NeoLeMarc/Diplomarbeit/zigbit_firmware/Bootloader/readme.txt

Fuse bytes for atmega: (without OTAU)
EXTENDED                   0xFF
HIGH                       0x9C
LOW                        0x62
