NeoLeMarc/Diplomarbeit/vortrag_tng2/vortrag.tex

% $Header: /cvsroot/latex-beamer/latex-beamer/examples/beamerexample1.tex,v 1.47 2004/11/04 15:43:51 tantau Exp $

\documentclass{beamer}
%\documentclass{article}
%\usepackage[envcountsect]{beamerarticle}

% Do NOT take this file as a template for your own talks. Use a file
% in the directory solutions instead. They are much better suited.

% Try the class options [notes], [notes=only], [trans], [handout],
% [red], [compress], [draft] and see what happens!

% Copyright 2003 by Till Tantau <tantau@users.sourceforge.net>.
%
% This program can be redistributed and/or modified under the terms
% of the LaTeX Project Public License Distributed from CTAN
% archives in directory macros/latex/base/lppl.txt.

% For a green structure color use:
%\colorlet{structure}{green!50!black}

\usepackage{array,paralist}
\usepackage{tabularx}
\usepackage{eurosym}

\mode<article> % only for the article version
{
  \usepackage{fullpage}
  \usepackage{hyperref}
}

\mode<presentation>
{
  \setbeamertemplate{background canvas}[vertical shading][bottom=red!10,top=blue!10]

  \usetheme{CambridgeUS}
  \usefonttheme[onlysmall]{structurebold}
}

%\setbeamercolor{math text}{fg=green!50!black}
%\setbeamercolor{normal text in math text}{parent=math text}

\usepackage{amsmath,amssymb}
\usepackage[latin1]{inputenc}
\usepackage{colortbl}
\usepackage[english]{babel}

%\usepackage{lmodern}
%\usepackage[T1]{fontenc} 

\usepackage{times}
\setbeamercovered{dynamic}

%% Titel etc
\title[]{Kabellose Sensornetze: ZigBee, Bluetooth \& co.}
\author[Noe]{Marcel Noe}
\institute[TNG]{
        \inst{}TNG Technology Consulting GmbH}
\date[2013]

%% Hauptseite
\begin{document}
\frame{\titlepage}

\section<presentation>*{Einführung}

\begin{frame}
  \frametitle{Überblick}
  \tableofcontents[part=1,hidesubsections]
\end{frame}

\part<presentation>{Vortrag}

\logo{}
\section{Motivation}
\subsection{Was ist ein Sensornetz?}
\begin{frame}
    \frametitle{Was ist ein Sensornetz?}

    \begin{columns}[T]
        \begin{column}{7cm}
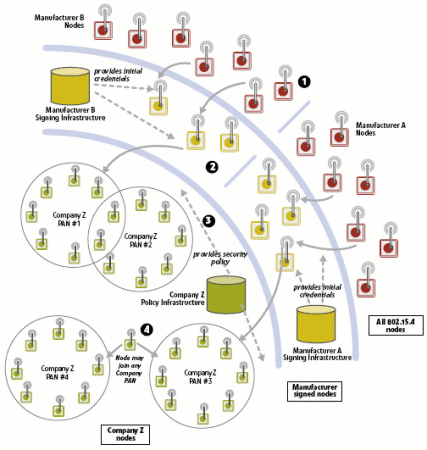
[picture p1: vortrag_tng2/images/certicom_sensor_nets_fig2.png]
            \\
        \end{column}

        \begin{column}{4cm}
            \begin{itemize}
                \item Netzwerk aus vielen verteilten Sensorknoten 
                \item Oft ad-hoc vernetzt 
                \item Energieversorgung meist über Batterie 
            \end{itemize}
        \end{column}
    \end{columns}
\end{frame}

\section{Anwendungen}
\subsection{Anwendungen}

\section{Grundlagen der kabellosen Datenübertragung}
\subsection{Die ISM Bänder}
\begin{frame}
    \frametitle{Die ISM Bänder}
      \begin{columns}[T]
        \begin{column}{3cm}
            \begin{itemize}
                \item 6,765 MHz
                \item 13,553 MHz
                \item 26,957 MHz 
                \item 40,66 MHz
                \item 433 MHz
                \item 902 MHz
                \item 2,4 GHz
                \item 5,7 GHz
                \item 24 GHz
                \item 61 GHz
                \item 122 GHz
                \item 244 GHz
            \end{itemize}
        \end{column}
        \begin{column}{5cm}
            \begin{itemize}
                \item In den meisten Ländern für jeden frei verwendbare Frequenzbänder
                \item Alle kabellosen Consumerprodukte verwenden eines der ISM-Bänder
                \item Verwendung anderer Frequenzen benötigt spezielle Lizenzen
            \end{itemize}
        \end{column}
    \end{columns}
\end{frame}

\subsection{Eigenschaften verschiedener Frequenzbänder}
\begin{frame}
    \frametitle{Eigenschaften verschiedener Frequenzbänder}

    Grundsätzlich: Je höher die Frequenz, desto höher die Datenübertragungsraten. Aber desto schlechter auch 
    Reichweite ein Eindringtiefe.
\end{frame}

\subsubsection{900 MHz}
\begin{frame}
    \frametitle{900 MHz}

    \begin{itemize}
           \item ca. 2,6 fache Reichweite wie 2,4GHz
           \item Bandbreite: 26 MHz (1/3 wie im 2,4GHz Band)
           \item Nur in Region 2 (Hauptsächlich Amerika. {\bf nicht} Europa)
    \end{itemize}
\end{frame}

\subsubsection{2.4 GHz}
\begin{frame}
    \frametitle{2.4 GHz Band}

    \begin{itemize}
           \item Reichweite ungerichtet bis ca. 100m 
           \item Maximal zulässige Sendeleistung: 100mW 
           \item Weltweit zulässig 
           \item Bandbreite: 100MHz
    \end{itemize}

\end{frame}

\subsubsection{5 GHz}
\begin{frame}
    \frametitle{5 GHz}

    \begin{itemize}
           \item Maximal zulässige Sendeleistung: 1W, daher theoretisch höhere Reichweite als 2,4GHz 
           \item Weltweit zulässig (Ausgenommen bestimmte Kanäle, z.B. in Japan)
           \item DFS und TPC zwingend vogeschrieben, um militärische Anwendungen nicht zu stören
           \item Bandbreite: 150MHz
           \item Weniger "Betrieb" als im 2,4GHz Band
    \end{itemize}
\end{frame}

\subsection{Frequenzspreizung}
\begin{frame}
    \frametitle{Frequenzspreizung: Motivation}

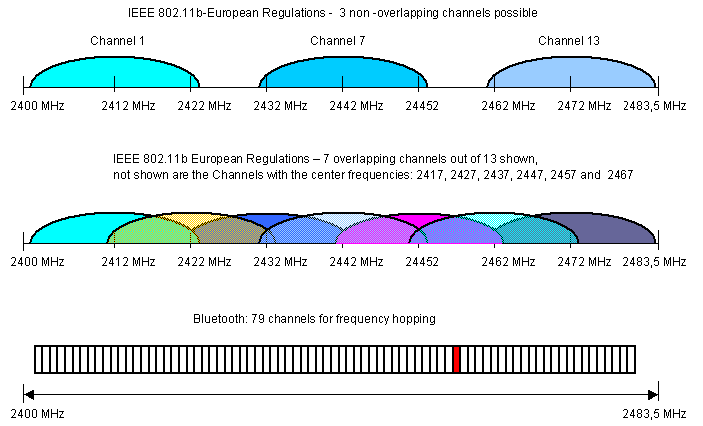
[picture p2: vortrag_tng2/images/ism_congest.png]
    \\
\end{frame}

\subsubsection{FHSS: Frequency Hopping Spread Spectrum}
\begin{frame}
    \frametitle{FHSS: Frequency Hopping Spread Spectrum}

    \\
\end{frame}

\subsubsection{DSSS: Direct Sequence Spread Spectrum}
\begin{frame}
    \frametitle{DSSS: Direct Sequence Spread Spectrum}

    \\
\end{frame}

\section{Verschiedene Technologien}
\subsection{WLAN}
\begin{frame}
    \frametitle{IEEE 802.11: WLAN}

    \begin{columns}[T]
        \begin{column}{3cm}
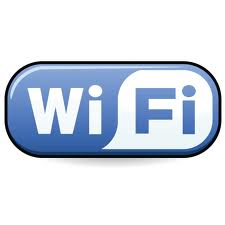
[picture p3: vortrag_tng2/images/wifi_logo.jpeg]
            \\
            \vspace{1cm}
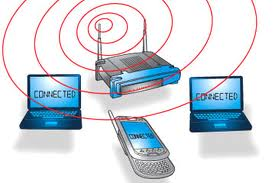
[picture p4: vortrag_tng2/images/wifi.jpeg]
            \\
        \end{column}

        \begin{column}{8cm}
            \begin{itemize}
                \item 2,4GHz und 5GHz 
                \item Übertragungsraten bis 150Mbit/sec
                \item Reichweiten ungerichtet bis ca. 100m, bei Sichtverbindung mit externer Antenne sogar bis 300m
                \item Richtfunk bis ca. 40km
                \item Je nach Standard: Verwendung von DSSS, FHSS und OFDM
                \item Relativ hoher Leistungsbedarf: 100mA zum Empfangen, 190mA zum Senden 
                \item Ad-Hoc Modus möglich
            \end{itemize}
        \end{column}
    \end{columns}
\end{frame}

\subsection{Bluetooth}
\begin{frame}
    \frametitle{Bluetooth}

    \begin{columns}[T]

        \begin{column}{3cm}
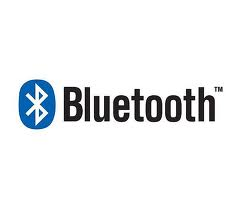
[picture p5: vortrag_tng2/images/bluetooth_logo.jpeg]
            \\
            \vspace{1cm}
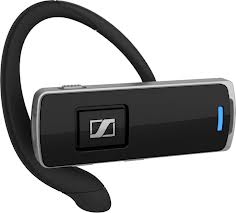
[picture p6: vortrag_tng2/images/headset.jpeg]
            \\
        \end{column}

        \begin{column}{8cm}
            \begin{itemize}
                \item 2,4GHz
                \item Übertragungsraten bis 2,1MBit/sec
                \item Reichweite bis 10m (Class 3), 50m (Class 2), 100m (Class 3) 
                \item FHSS
                \item Leistungsbedarf ca. 56,7mW (16,6mA) für ein Class 2 Slave
                \item Maximal 255 Teilnehmer
                \item Jedoch nur 7 gleichzeitig aktive Slaves
                \item 1 Master
                \item Teilnehmer müssen gepaired werden
            \end{itemize}
        \end{column}
    \end{columns}
\end{frame}

\subsection{ZigBee}
\begin{frame}
    \frametitle{ZigBee}

    \begin{columns}[T]

        \begin{column}{5cm}
            \\
        \end{column}

        \begin{column}{7cm}
            \begin{itemize}
                \item Protokollstack auf Basis von IEEE 802.15.4
                \item 868MHz (nur Europa), 900MHz (nur Amerika) und 2,4GHz (weltweit)
                \item 1mW Sendeleistung 
                \item Reichweite bis ca. 100 Meter 
                \item DSSS
                \item Übertragungsrate: 20kbit/sec (868MHz), 40kbit/sec (900MHz), 250kbit/sec (2,4GHz)
                \item 19mA im Betrieb, 6$µ$A im Sleep-Modus (Nur auf RFDs)
                \item FFDs (Full Functional Devices) und RFDs (Reduced Functional Devices)
                \item Mesh-Netzwerk bei Verwendung von FFDs als Router möglich.
            \end{itemize}
        \end{column}
    \end{columns}
\end{frame}

\section{Marktübersicht 2013}
\subsection{National Instruments}
\begin{frame}
    \frametitle{NI wireless sensor networks}

    \begin{columns}[T]

        \begin{column}{5cm}
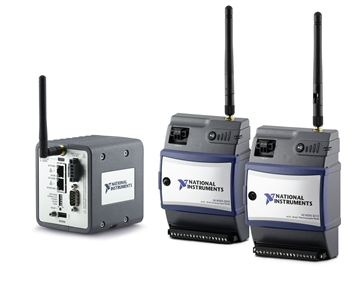
[picture p7: vortrag_tng2/images/national_instruments/RT_Gateway_and_Nodes_-_resized_JPEG.jpg]
            \\
        \end{column}

        \begin{column}{7cm}
            \begin{itemize}
                \item Programmierbare Ethernet und Wlan Gateways verfügbar 
                \item Knoten mit 4 digitalen und 4 analogen Eingängen
                \item Anbindung an LabVIEW
                \item Proprietäres Protokoll auf Basis von IEEE 802.15.4 
                \item Relativ teuer: ca. 500 Euro pro Sensorknoten
            \end{itemize}
        \end{column}
    \end{columns}
\end{frame}

\subsection{Libelium}
\begin{frame}
    \frametitle{Libelium}

    \begin{columns}[T]

        \begin{column}{5cm}
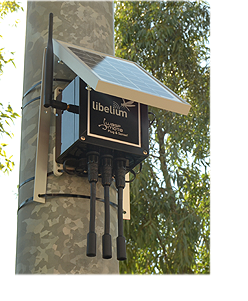
[picture p8: vortrag_tng2/images/libelium/installation.png]
            \\
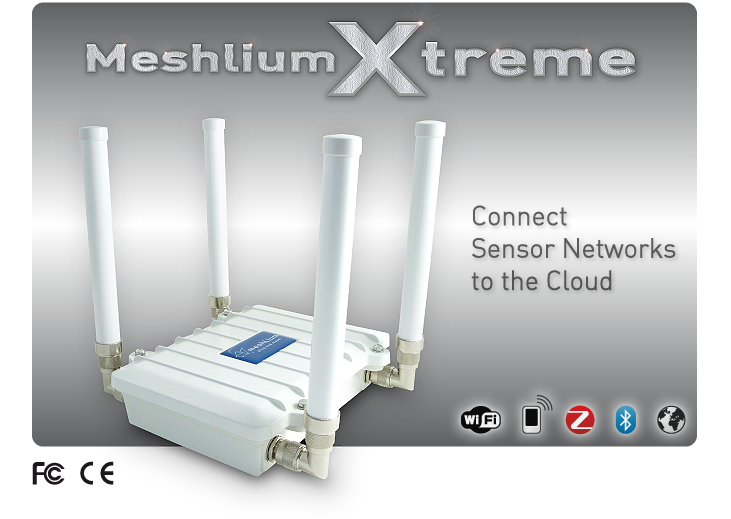
[picture p9: vortrag_tng2/images/libelium/title_frontpage_description_eng.png]
            \\
        \end{column}

        \begin{column}{7cm}
            \begin{itemize}
                \item Sensornetzprodukte auf ZigBee Basis 
                \item Sowohl als kostengünstige Entwicklerboards als auch als fertige Komplettlösung verfügbar 
                \item Unabhängige Energieversorgung über Solarzellen 
                \item Multiprotokoll-Gateways mit ZigBee, Wlan und Bluetooth
                \item Opensource Software 
                \item Lösungen für Smartcities
                \item Reichweite nach Herstellerangabe zwischen 7 und 14km
            \end{itemize}
        \end{column}
    \end{columns}
\end{frame}

\subsection{Zum selber basteln}

\begin{frame}
    \frametitle{Arduino}

    \begin{columns}[T]

        \begin{column}{5cm}
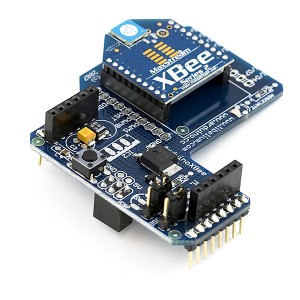
[picture p10: vortrag_tng2/images/arduino/arduino-xbee-shield-c-xbee.jpg]
            \\
        \end{column}

        \begin{column}{7cm}
            \begin{itemize}
                \item ZigBee Schild für Arduino
                \item Sockel für ein Digi International XBee Pro
                \item Preis für Modul und Schild zusammen unter 40 Euro
                \item XBee Module sind in verschiedenen Ausführungen erhältlich, die teilweise 
                      Pin-kompatibel sind
                \item Hergestellt von Libelium, Grundlage für die kommerziellen Waspmotes
            \end{itemize}
        \end{column}
    \end{columns}
\end{frame}

\begin{frame}
    \frametitle{Raspberry Pi}

    \begin{columns}[T]

        \begin{column}{5cm}
            \\
        \end{column}

        \begin{column}{7cm}
            \begin{itemize}
                \item Verwendung des Arduino ZigBee Schild mit Hilfe der Raspberry Pi to Arduino Shield.
                \item Preis für den Adapter: 40 Euro
            \end{itemize}
        \end{column}
    \end{columns}

\end{frame}

\begin{frame}
    \frametitle{ZigBit}

    \begin{columns}[T]

        \begin{column}{5cm}
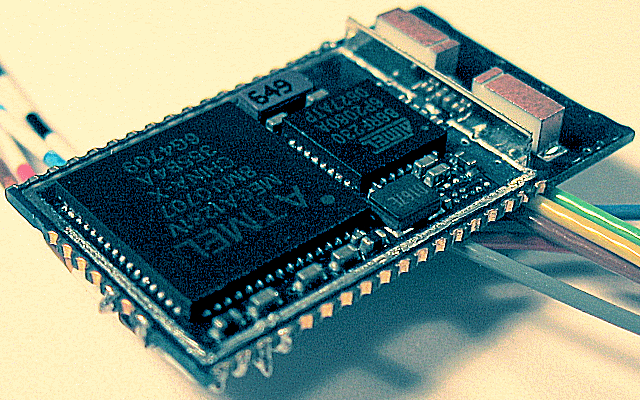
[picture p11: vortrag_tng2/images/ZDM-A1281-A2_offen.png]
            \\
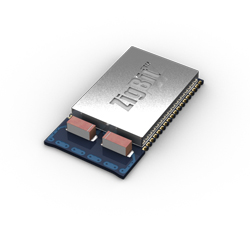
[picture p12: vortrag_tng2/images/zigbit_2.jpg]
            \\
        \end{column}

        \begin{column}{7cm}
            \begin{itemize}
                \item Kombination aus IEEE.802.15.4 Radios mit einem ATmega1281V Mikrocontroller
                \item 30 GPIO Leitungen
                \item UART, USART, I2C, SPI, 1-Wire, 4 ADCs, JTAG
                \item Stückpreis um die 14 Euro
                \item Mit etwas Geschick im Löten praktisch schon ein komplettes Starterkit.
            \end{itemize}
        \end{column}
    \end{columns}
\end{frame}

\section{Security}
\subsection{ZigBee: WEP Reloaded}
\begin{frame}
    \frametitle{ZigBee: WEP Reloaded}

    \begin{columns}[T]

        \begin{column}{5cm}
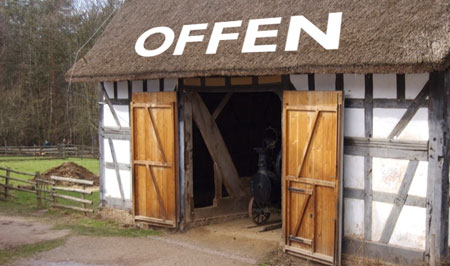
[picture p13: vortrag_tng2/images/scheunentor.jpg]
            \\
        \end{column}

        \begin{column}{7cm}
            \begin{itemize}
                \item Theoretisch 128-Bit-AES Verschlüsselung
                \item Aber oft managelhaftes Key-Management:
                \item Jedes Device in einem Netzwerk hat den selben PSK
                \item Keys können mittels JTAG extrahiert werden
                \item Oft schlecht gewählte Keys
                \item Kein Schutz gegen Replay Attacken
                \item Known-Plaintext Attacken möglich
                \item Besser: Security auf Application Layer. Aber: Auf einem 8-Bit Mikrocontroller...
            \end{itemize}
        \end{column}
    \end{columns}

\end{frame}

\subsection{Kisbee}
\begin{frame}
    \frametitle{Kisbee}

    \begin{columns}[T]

        \begin{column}{5cm}
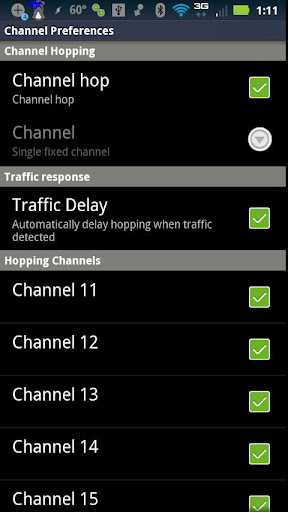
[picture p14: vortrag_tng2/images/netkismetwirelessandroidkisbee-1-1.jpg]
            \\
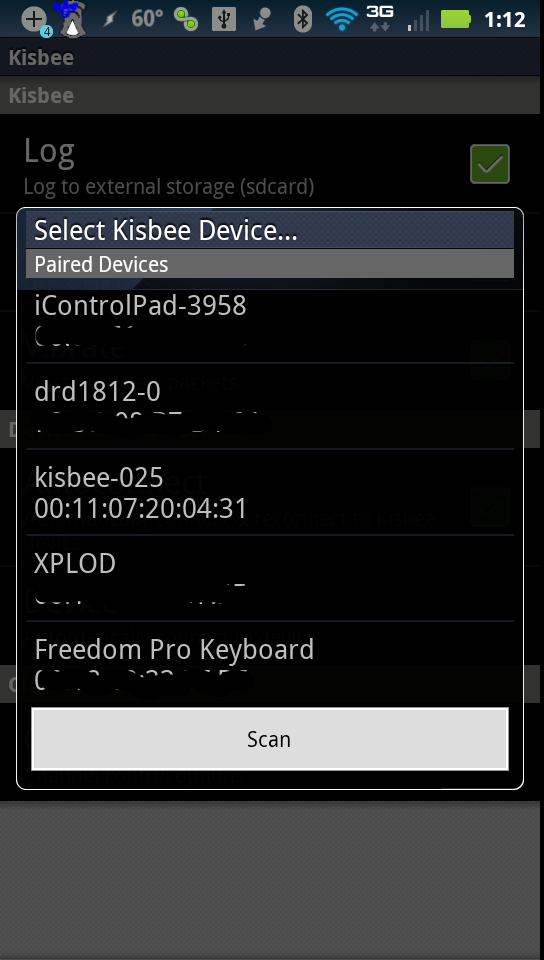
[picture p15: vortrag_tng2/images/kisbee-select.png]
            \\
        \end{column}

        \begin{column}{7cm}
            \begin{itemize}
                \item Projekt von den Kismet Autoren zum Angriff auf ZigBee Netze
                \item Läuft auf Android
                \item ZigBee Device kann per Bluetooth oder USB angebunden werden
            \end{itemize}
        \end{column}
    \end{columns}
\end{frame}

\subsection{Ich sehe was, was Du nicht siehst: Introducing HackRF}
\begin{frame}
    \frametitle{HackRF}

    \begin{columns}[T]

        \begin{column}{5cm}
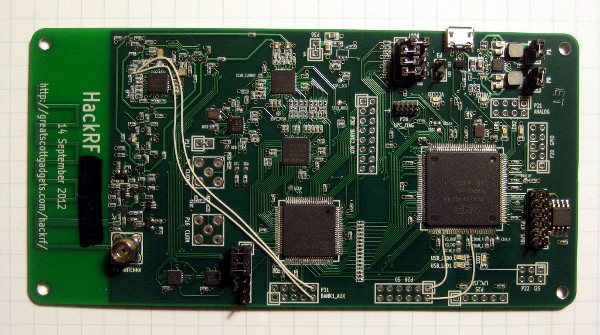
[picture p16: vortrag_tng2/images/HackRF.jpg]
            \\
        \end{column}

        \begin{column}{7cm}
            \begin{itemize}
                \item Idee: Low cost devices, das in der Lage ist, auf praktisch allen verwendeten Frequenzen zu 
                    Senden und zu Empfangen
                \item Damit werden auch Attacken auf Protokolle ausserhalb des ISM-Bandes möglich (z.B. GSM)
                \item Oder auf NFC, RFID...
                \item Integration in GNURadio
                \item Alle Bauteile sind auf kompatibilität mit OpenSourceSoftware sowie Robustheit ausgelegt
            \end{itemize}
        \end{column}
    \end{columns}

\end{frame}

\section{Aus der Alptraumabteilung}
\subsection{Smart dust}
\begin{frame}
    \frametitle{Smart dust}

    \begin{columns}[T]

        \begin{column}{10cm}
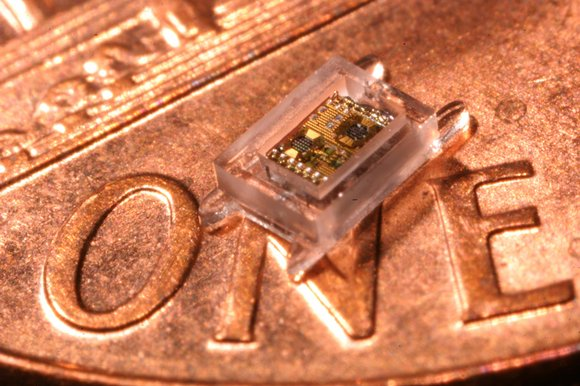
[picture p17: vortrag_tng2/images/smart_dust.jpg]
            \\
        \end{column}
    \end{columns}

\end{frame}

\subsection{Meine Kleidung funkt!}
\begin{frame}
    \frametitle{Meine Kleidung funkt!}

    \begin{columns}[T]

        \begin{column}{10cm}
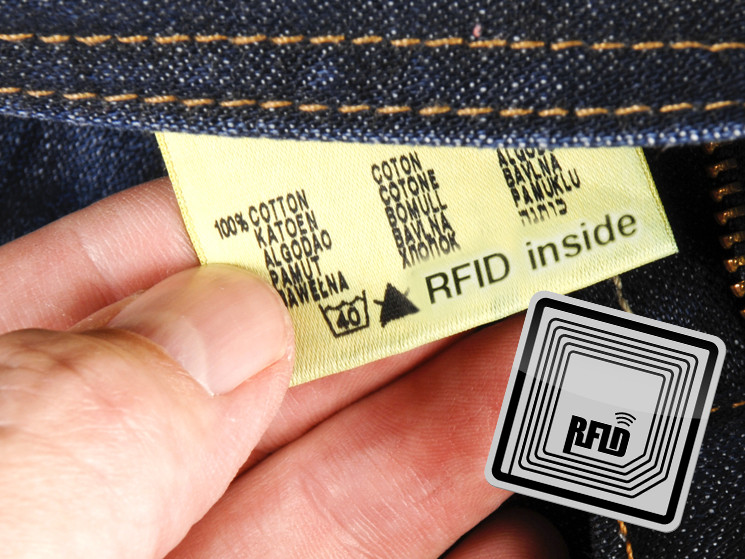
[picture p18: vortrag_tng2/images/rfid_kleidung.jpg]
            \\
        \end{column}
    \end{columns}

\end{frame}

\subsection{Tracking}
\begin{frame}
    \frametitle{Tracking}

    \begin{columns}[T]

        \begin{column}{10cm}
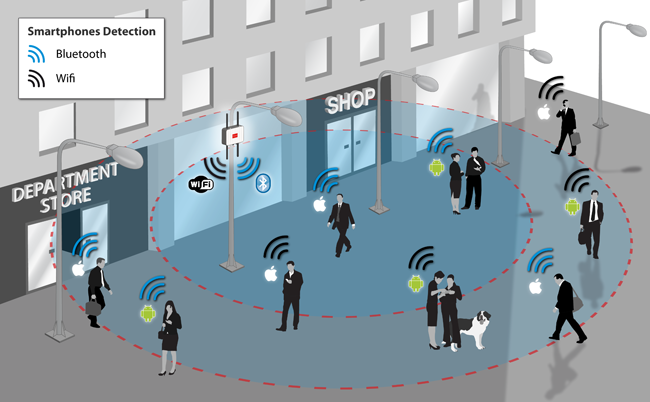
[picture p19: vortrag_tng2/images/libelium/bluetooth_street_wifi_bt_shops.png]
            \\
        \end{column}
    \end{columns}
\end{frame}

\section{Further reading}
\begin{frame}
    \frametitle{Further Reading}

    https://dev.noetech.net/svn/diplomarbeit/
    \\
    User: anonymous \\
    Passwort: anonymous
\end{frame}

\end{document}
