NeoLeMarc/Diplomarbeit/ausarbeitung/Diplomarbeit.tex

%-------------------------------%
%                               %
%    Hauptdokument              %
%    Diplomarbeit               %
%    Nicole Kikillus            %
%                               %
%    November 2003 - April 2004 %
%                               %
%-------------------------------%

\documentclass{wissdoc} %\textheight 23.0cm \textwidth 15.5cm
%\topmargin0cm \evensidemargin0cm \oddsidemargin0cm
\setlength{\parindent}{0pt}
\usepackage{a4,ngerman}
%\usepackage[a4paper, left=2.7cm, right=2.3cm, top=3.8cm, bottom=2.6cm]{geometry}
%\usepackage[a4paper, left=2.8cm, right=1.7cm, top=3.5cm, bottom=2.4cm]{geometry}
% ORG zum 11.08.05 \usepackage[a4paper, left=2.4cm, right=2.0cm, top=3.7cm, bottom=2.6cm]{geometry}
% ORG zum 18.07.05 \usepackage[a4paper, left=2.4cm, right=2cm, top=3.8cm, bottom=2.6cm]{geometry}
% ORG zum 06.07.05 \usepackage[a4paper, left=2.5cm, right=2.1cm, top=3.8cm, bottom=2.6cm]{geometry}
% ORG \usepackage[a4paper, left=3.6cm, right=3.2cm, top=3.8cm, bottom=2.6cm]{geometry}
%\usepackage[a4paper, left=2.5cm, right=2.5cm, top=1.2cm, bottom=2.3cm]{geometry}
\usepackage{graphicx}
\usepackage{epsfig}
\usepackage{float}
\usepackage[utf8]{inputenc}
\usepackage{url}
\usepackage{makeidx}
%\usepackage{natbib}
% \usepackage[dvips]{color}
\usepackage{color}
\usepackage{fancyhdr}
\usepackage{color}
\usepackage{pstricks}
\usepackage{rotating}
\usepackage[footnotesize,bf]{caption2}
\usepackage{eurosym}
\usepackage{pdfpages}
\usepackage{amsmath}
\usepackage{listings}
 \definecolor{middlegray}{rgb}{0.5,0.5,0.5}
 \definecolor{lightgray}{rgb}{0.8,0.8,0.8}
 \definecolor{orange}{rgb}{0.8,0.3,0.3}
 \definecolor{yac}{rgb}{0.6,0.6,0.1}
\lstset{numbers=left, numberstyle=\tiny, numbersep=5pt}
\lstset{language=python}
 \lstset{
   basicstyle=\small\ttfamily,
   keywordstyle=\bfseries\ttfamily\color{orange},
   stringstyle=\color{blue}\ttfamily,
   commentstyle=\color{middlegray}\ttfamily,
   emph={square}, 
   emphstyle=\color{blue}\texttt,
   emph={[2]root,base},
   emphstyle={[2]\color{yac}\texttt},
   showstringspaces=false,
   flexiblecolumns=false,
   tabsize=2,
   numbers=left,
   numberstyle=\tiny,
   numberblanklines=false,
   stepnumber=1,
   numbersep=10pt,
   xleftmargin=15pt
 }
\makeatletter \renewcommand{\fps@figure}{htbp} \makeatother
\renewcommand{\textfraction}{.1} 
\setlength{\parindent}{0em}
\renewcommand{\baselinestretch}{1.2}
%\KOMAoptions{twoside,BCOR=5mm,DIV=11}
\KOMAoptions{twoside,BCOR=5mm,DIV=12,footinclude=false,headinclude=true}

\recalctypearea

% Graphiken sollen nicht so oft auf Leeren Seiten stehen
\renewcommand{\topfraction}{0.9}
\renewcommand{\textfraction}{0.05}

% Macros, nicht unbedingt notwendig
\input{macros}

\newcommand{\blankpage}{% Leerseite ohne Seitennummer, nächste Seite rechts
 \clearpage{\pagestyle{empty}\cleardoublepage}
}

\pagestyle{headings}

%% *********************************
%% Formel- und Abkürzungsverzeichnis
%% *********************************

%% Achtung: an Kommandozeile folgender Befehl ausführen:
%%          makeindex -o diplom.gls -s nomencl.ist diplom.glo

\usepackage{nomencl}
\usepackage{ifthen}
\renewcommand{\nomname}{\chapter*{Glossar}}
\makeglossary
\makenomenclature
\setlength{\nomlabelwidth}{.25\hsize}
%\renewcommand{\nomlabel}[1]{\emph{#1}}
\setlength{\nomitemsep}{-\parsep}
%\makeglossary
%\makenomenclature

%% Quellcodeverzeichnis
\renewcommand\lstlistlistingname{Quellcodeverzeichnis}

%% Auskommentieren einer dieser Zeilen bewirkt, daß nur diese
%% eine Datei übersetzt wird

%\includeonly{Titel}
%\includeonly{Dank}
%\includeonly{Zitat}
%\includeonly{Kap_1}
%\includeonly{Kap_2}
%\includeonly{Kap_3}
%\includeonly{Kap_4}
%\includeonly{Kap_5}
%\includeonly{Kap_6}
%\includeonly{Anh_a}
%\includeonly{Anh_b}
%\includeonly{Anh_c}
%\includeonly{Anh_d}
%\includeonly{Anh_e}
%\includeonly{Anh_f}
%\includeonly{Anh_g}
%\includeonly{Tempverlauf}

%% **************
%% Dokumentbeginn
%% **************

%%% Überschrift 4ter Ordnung
\setcounter{secnumdepth}{4}

\usepackage[noindentafter]{titlesec}

% paragraphs sehen aus wie subsubsubsections
\titleformat{\paragraph}[hang]{\bf}{\thetitle\quad}{0pt}{}                      
\titlespacing{\paragraph}{0pt}{1em}{0.5em} 

% subparagraphs sehen aus wie vorher paragraphs
\titleformat{\subparagraph}[runin]{\bf}{}{0.5em}{}
\titlespacing{\subparagraph}{0pt}{1em}{1em}

%%%-----------------------------------
\begin{document} 
%%%-------------------------
\include{Titel}
%\include{Dank}

%\thispagestyle{empty}
\chapter*{} 
\pagenumbering{Roman}% Seitennummerierung durch arabische Ziffern
\vspace*{10.5cm} {\setlength{\parindent}{0pt}\textbf{Eidesstattliche Erklärung}\\
Hiermit erkläre ich an Eides Statt, dass ich die vorliegende Diplomarbeit selbständig und ohne unzulässige fremde Hilfsmittel angefertigt habe. Die verwendeten Literaturquellen sind im Literaturverzeichnis vollständig angegeben. Die Arbeit wurde in gleicher oder ähnlicher Form keiner anderen Prüfungsbehörde zur Erlangung eines akademischen Grades vorgelegt.\\ 

Karlsruhe, 31.10.2010\\

\include{Abstract}
\include{Vorwort}
%\include{Danksagung}

%%%------------------------------------------------INHALTS-,ABBILDUNGS-,TABELLENVERZEICHNIS-------------------------------------------
\setcounter{tocdepth}{4}
\tableofcontents 
\listoffigures
\addcontentsline{toc}{chapter}{Abbildungsverzeichnis}
\listoftables
\addcontentsline{toc}{chapter}{Tabellenverzeichnis}
\lstlistoflistings
\addcontentsline{toc}{chapter}{Quellcodeverzeichnis}

%%%------------------------------------------------GLOSSAR-----------------------------------------------------------------------------

%\chapter{Glossar}
\markboth{Glossar}{}
\printnomenclature
\addcontentsline{toc}{chapter}{Glossar}

\include{Einleitung}
\include{Grundlagen}
\include{Stand_der_Technik}
\include{Analyse}
\include{Entwurf}
\include{Praktische_Realisierung}
\include{Ergebnisse}
\include{Diskussion}
\include{Ausblick}

%%%------------------------------------------------ANHANG---------------------------------------------------------------

\begin{appendix}
\include{Anhang}
\end{appendix}

%%%------------------------------------------------KOMPLETTES LITERATURVERZEICHNIS NACH NORM------------------------------------------
\nocite{*} % Alle Einträge anzeigen
\bibliography{Diplomarbeit}
\bibliographystyle{itmalpha}
\addcontentsline{toc}{chapter}{Literaturverzeichnis}

\end{document}
