NeoLeMarc/Diplomarbeit/vortrag/vortrag.tex

% $Header: /cvsroot/latex-beamer/latex-beamer/examples/beamerexample1.tex,v 1.47 2004/11/04 15:43:51 tantau Exp $

\documentclass{beamer}
%\documentclass{article}
%\usepackage[envcountsect]{beamerarticle}

% Do NOT take this file as a template for your own talks. Use a file
% in the directory solutions instead. They are much better suited.

% Try the class options [notes], [notes=only], [trans], [handout],
% [red], [compress], [draft] and see what happens!

% Copyright 2003 by Till Tantau <tantau@users.sourceforge.net>.
%
% This program can be redistributed and/or modified under the terms
% of the LaTeX Project Public License Distributed from CTAN
% archives in directory macros/latex/base/lppl.txt.

% For a green structure color use:
%\colorlet{structure}{green!50!black}

\usepackage{array,paralist}
\usepackage{tabularx}
\usepackage{eurosym}

\mode<article> % only for the article version
{
  \usepackage{fullpage}
  \usepackage{hyperref}
}

\mode<presentation>
{
  \setbeamertemplate{background canvas}[vertical shading][bottom=red!10,top=blue!10]

  \usetheme{CambridgeUS}
  \usefonttheme[onlysmall]{structurebold}
}

%\setbeamercolor{math text}{fg=green!50!black}
%\setbeamercolor{normal text in math text}{parent=math text}

\usepackage{amsmath,amssymb}
\usepackage[latin1]{inputenc}
\usepackage{colortbl}
\usepackage[english]{babel}

%\usepackage{lmodern}
%\usepackage[T1]{fontenc} 

\usepackage{times}
\setbeamercovered{dynamic}

%% Titel etc
\title[MANV-Sensornetzwerk]{Entwurf und Implementierung
       eines kabellosen Sensornetzwerkes zur Überwachung von Patienten
       in einem MANV-Szenario}
\author[Noe, Tepelmann]{Marcel Noe \and Jan Tepelmann}
\logo{}
\institute[KIT]{
        \inst{} Institut für Biomedizinische Technik (IBT) \\
                Karlsruher Institut für Technologie } 
\date[2010]

%% Hauptseite
\begin{document}
\frame{\titlepage}

\section<presentation>*{Einleitung}

\begin{frame}
  \frametitle{Überblick}
  \tableofcontents[part=1,hidesubsections]
\end{frame}

\part<presentation>{Vortrag}

\logo{}
\section{Motivation}
\subsection{Massenanfall von Verletzten}
\begin{frame}
    \frametitle{Motivation: Massenanfall von Verletzten}

    \begin{columns}[T]
        \begin{column}{5cm}
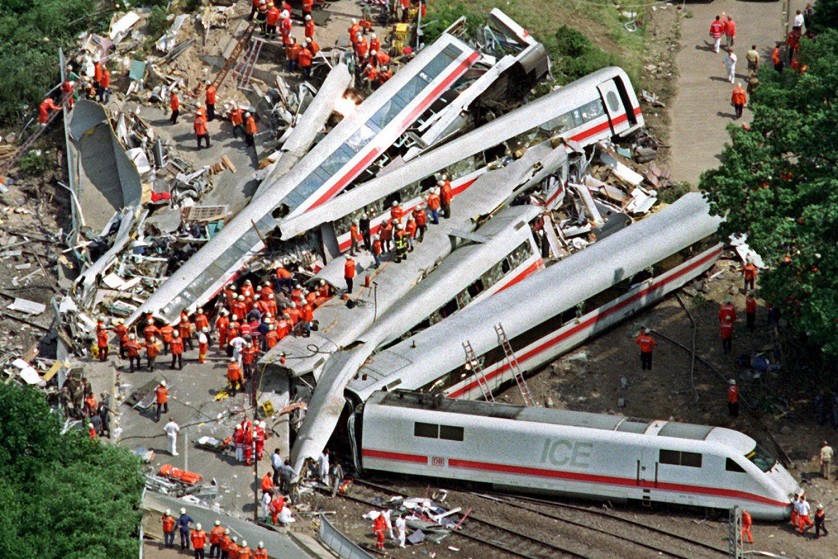
[picture p20: vortrag/eschede.jpg]
            
        \end{column}

        \begin{column}{7cm}
            \begin{itemize}
                \item Ereigniss mit einer großen Anzahl von Verletzten
                \item z.B. Verkehrsunglück, Brand, Naturkatastrophe oder Krankheit
                \item Teilweise Zusammenbruch (lokaler) Infrastruktur
                \item Knappe Ressourcen (Hilfsmittel, Helfer, Medikamente, Transportkapazität)
                \item Hohe Belastung für Helfer
                \item Unübersichtliche Lage (Beispiel: Teneriffa 1977)
            \end{itemize}
        \end{column}
    \end{columns}
\end{frame}

\subsection{Triage}
\begin{frame}
    \frametitle{Motivation: Triage}

    \begin{columns}[T]
         \begin{column}{8cm}
            \begin{itemize}
                \item Triage: Einteilung von Patienten in Gruppen nach Behandlungsdringlichkeit.
                \item Grund: Beschränkte Ressourcen: Transportmittel, Medikamente, Helfer
                \item Einfachste Hilfsmittel: "Sehen, hören, fühlen", Anhängekärtchen, etc.
                \item Aber: Werden alle Patienten korrekt zugeordnet? Was passiert bei Verschlechterung des
                      Zustands nach Triage? 
                \item Fehlerquellen: Zeitdruck, zu wenig Personal, Psychische Belastung der Helfer
            \end{itemize}
        \end{column}

       \begin{column}{3cm}
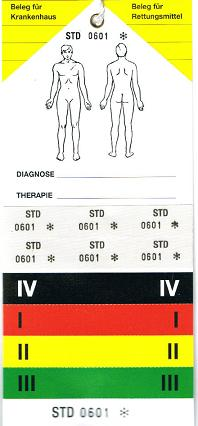
[picture p21: vortrag/Anhaengekarte2.JPG]
            
        \end{column}
    \end{columns}

    \vspace{0.3cm} \begin{center}{\bf $\Longrightarrow$ Technische Hilfsmittel können Fehler verringern.}\end{center}
\end{frame}
\logo{}

\section{Analyse}
\subsection{Stand der Technik}
\begin{frame}
    \frametitle{Stand der Technik: Hilfsmittel für MANV-Einsatz}

    \begin{itemize}
        \item Tragbare EKG-Geräte, insbesondere in Defis\\
              $\rightarrow$ Schwer, groß, teuer, pro Patient ein Gerät nötig
        \item Monitore mit Bluetooth-Technologie\\
              $\rightarrow{}$ Maximal 8 aktive Geräte pro Netzwerk
        \item Monitore mit WLAN-Technologie\\ 
              $\rightarrow{}$ störungsanfällig, hoher Stromverbrauch, teuer, kein Roaming.
        \item Herstellerspezifische Lösungen (z.B. Z-Wave oder Polar)\\
              $\rightarrow{}$ Proprietär, teuer
        \item ZigBee Healthcare, Bluetooth Low Energy (WiBree)\\
              $\rightarrow{}$ Bisher noch keine Geräte auf dem Markt
        \item $I^2C$ basiertes Sensornetz\\
              $\rightarrow{}$ Benötigt viele Kabel
    \end{itemize}
\end{frame}

\subsection{Anforderungen}
\begin{frame}
    \frametitle{Anforderungen}

    \begin{itemize}
        \item Skalierbar in Anzahl der Patienten {\bf und} Helfern
        \item Überwachung des Patientenzustands (z.B. Puls \& Atmung) durch Sensoren
        \item Senden von Befehlen (z.B. Alarm aus, manueller Alarm) an Sensoren
        \item Schnelle Einsatzfähigkeit: Je weniger Kabel desto besser.
        \item Kostengünstig
        \item Niedriger Stromverbrauch
        \item Robust 
        \item Einfache Bedienbarkeit
        \item Erweiterbar
    \end{itemize}
\end{frame}

\section{Lösung}

\subsection{Hardware: Funknetzwerk}
\begin{frame}
    \frametitle{Funknetzwerk: ZigBee}

    \begin{columns}[T]
        \begin{column}{5cm}
           % \includegraphics[width=5cm]{../ausarbeitung/diagramme/zigbit_bild-crop.pdf}
           
        \end{column}

        \begin{column}{7cm}
            \begin{itemize}
                \item Über 500 Teilnehmer möglich 
                \item Mesh-Netzwerk: Durch Router erweiterbar 
                \item Bis 50m (Klasse 2 Gerät) bzw. über 500m (Klasse 1 Gerät) Reichweite
                      {\bf pro Router!}
                \item Stromverbrauch: nur 1,8mA bei Einsatz von Energiesparmodus
                      (Bluetooth: 16,6mA, WLAN: 180mA).
                \item Stückpreis unter 15\EUR{}
            \end{itemize}
        \end{column}
    \end{columns}
\end{frame}

\subsection{Hardware: MANVNode}
% Logo ausschalten
\logo{}
\begin{frame}
    \frametitle{Hardware: MANVNode}

    \begin{columns}[T]
        \begin{column}{7cm}
            \begin{itemize}
                \item Entwicklungsplatine zum Entwerfen und Testen von Firmware
                \item JTAG-Schnittstelle für Debugging
                \item ADuC-Mikroprozessor (vgl. Erste-Hilfe-Sensor)
                \item Testpunkte für Strommessung 
                \item Programmierbare Taster und LEDs
                \item Piezzo-Summer
                \item Batterie- und Netzteilbetrieb (3V-16V)
            \end{itemize}
        \end{column}
   
        \begin{column}{5.5cm}
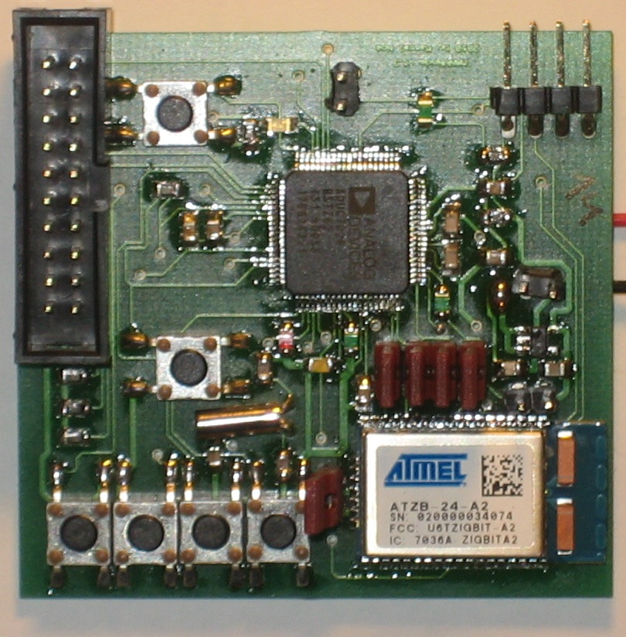
[picture p22: vortrag/platine.jpg]
            
        \end{column}
    \end{columns}
\end{frame}
% Logo wieder einschalten
\logo{}

% Logo ausschalten
\logo{}
\subsection{Software: Logische Sicht}
\begin{frame}
    \frametitle{Software: Logische Sicht}

    \begin{columns}[T]
    		\begin{column}{7cm}
            
        \end{column}
    
        \begin{column}{5.5cm}
            \begin{itemize}
            		\item Basisstation: kennt den Zustand des Sensornetzes
                \item An eine Basisstation können beliebig viele weitere Sichtstationen angeschlossen werden
                \item Sichtstation: zeigt Zustand der Patienten, kann Befehle an Sensoren senden
                \item Verbindung über WLAN, Ethernet oder UMTS
                %\item Handyzugriff über spezielle Software (Nokia) oder Weboberfläche (iPhone, Android)
            \end{itemize}
        \end{column}
    \end{columns}
\end{frame}

\subsection{Software: Technische Sicht}
\begin{frame}
    \frametitle{Software: Technische Sicht}

    \begin{columns}[T]
        \begin{column}{6cm}
            \begin{itemize}
                \item Kapselung von Zuständigkeiten in Komponenten
                \item Connector: Kommunikation mit Sensornetz
                \item Server: Speichern des Netzzustandes
                \item GUIs: Zustand des Netzes grafisch anzeigen
                \item Komponenten unabhängig voneinander austauschbar
                %\item Verbindung über standardisierte Schnittstellen (CORBA, SQL, Ethernet, WLAN)
            \end{itemize}
        \end{column}
        
        \begin{column}{7cm}
            
        \end{column}
    \end{columns}
\end{frame}

\subsection{Software: Zusammenfassung}
\begin{frame}
    \frametitle{Software: Zusammenfassung}

    \begin{block}{Schnittstellen zur Anbindung externer Software}
        \begin{itemize}
            \item CORBA (Industriestandard!)
            \item Datenbankzugriff: SQL-Schnittstelle
            \item Webservices: SOAP und JSON (Web 2.0!)
        \end{itemize}
    \end{block}

    \begin{block}{Skalierbarkeit}
        \begin{itemize}
            \item Anbindung beliebig vieler Sichtstationen 
            \item ZigBee unterstützt über 500 Teilnehmer.
            \item Lauffähig auf allen Standardbetriebssystemen durch Einsatz von Virtualisierung 
            \item Weboberfläche für alle gängigen Browser und Handytypen 
        \end{itemize}
    \end{block}
\end{frame}
% Logo wieder einschalten
\logo{}

\section{Ergebnisse}
\subsection{Praktische Vorführung}
\begin{frame}
    \frametitle{Praktische Vorführung}
    \begin{center}
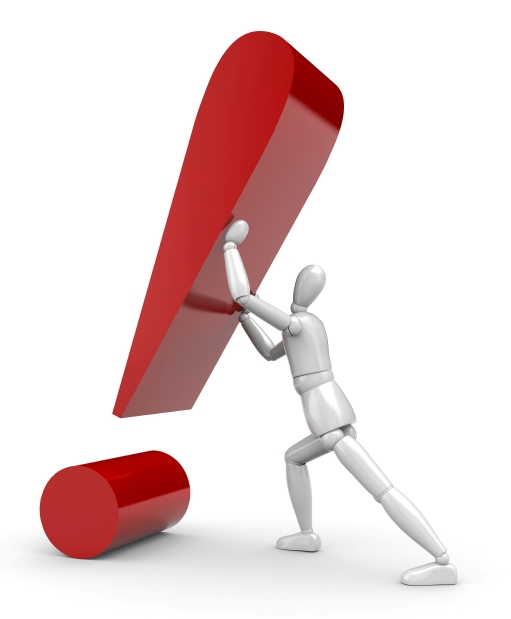
[picture p23: vortrag/Ausrufezeichen.jpg]
        
    \end{center}
\end{frame}

\subsection{Ergebnisse auf einen Blick}
\begin{frame}
    \frametitle{Ergebnisse auf einen Blick}
    \begin{itemize}
        \item 1,8mA Stromverbrauch bei Einsatz von Energiesparmodus
        \item Über 50m Reichweite pro Router
        \item Durch Router praktisch beliebig erweiterbar
        \item Laut Standard über 500 Teilnehmer möglich.
        \item Stabilität durch geringe Bandbreite und Frequenzspreizung 
        \item Software durch CORBA-Schnittstelle schnell an neue Anforderungen anpassbar.
        \item Größe wie Erste-Hilfe-Sensor. Demoplatine hat Format 50x56mm.
        \item Preis: Erste-Hilfe-Sensor + maximal 15\EUR{} für ZigBee-Modul 
    \end{itemize}
\end{frame}

\section{Diskussion und Ausblick}
\subsection{Diskussion}
\begin{frame}
    \frametitle{Verbesserungen gegenüber dem Stand der Technik}
    \begin{itemize}
        \item Keine Kabel mehr notwendig
        \item Kostengünstiger als alle existierenden Lösungen
        \item Stromsparender als alle existierenden Lösungen
        \item Mehr Teilnehmer als in allen existierenden Lösungen
        \item Hohe Reichweite durch Einsatz von Repeatern erreichbar
        \item Flexible und Erweiterbare Software 
        \item Herstellerunabhängig: Hardware-/Softwareschnittstelle austauschbar 
        \item Unabhängig von lokaler Infrastruktur
    \end{itemize}
\end{frame}

\subsection{Ausblick}
\begin{frame}
    \frametitle{Ausblick}

    \begin{block}{Optimierung der Hardware}
        \begin{itemize}
            \item Einsatz von Klasse 1 Modulen und Antennen ($\Rightarrow$ Reichweite)
            \item Tests von Modulen anderer Hersteller ($\Rightarrow$ Kosten)
        \end{itemize}
    \end{block}

    \begin{block}{Überarbeiten der ZigBit-Firmware}
        \begin{itemize}
            \item Verwendung von AES-Verschlüsselung
            \item Verringerung der Latenz
            \item Erhöhung der Datenübertragungsrate
        \end{itemize}
    \end{block}

    \begin{block}{Erweiterung der Software}
        \begin{itemize}
            \item Erweiterung der Weboberfläche
            \item Verbesserung der Benutzerführung
        \end{itemize}
    \end{block}
\end{frame}

\subsection{AAL}
\begin{frame}
    \frametitle{AAL-Kongress: Posterbeitrag}

    \begin{columns}[T]
        \begin{column}{4cm}
            
        \end{column}

        \begin{column}{8cm}
            \begin{itemize}
                \item Sensornetzwerk kann auch zur Unterstützung von älteren
                      Patienten im Alltag eingesetzt werden
                \item Veröffentlichung im Themengebiet "Wegweisende Anwendungsbeispiele"
                \item 25. - 26. Januar 2011 in Berlin
            \end{itemize}
        \end{column}
    \end{columns}
\end{frame}

\subsection{Fragen}
\begin{frame}
    \frametitle{Fragen?}

    \begin{center}
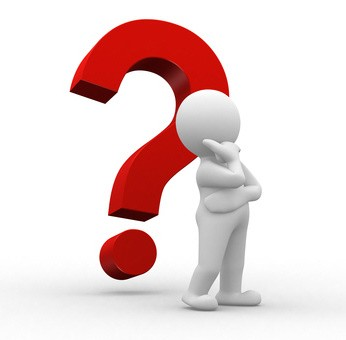
[picture p24: vortrag/fragezeichen.jpg]
        
    \end{center}
\end{frame}

\end{document}
