NeoLeMarc/Diplomarbeit/ausarbeitung/preview/preview.tex

    % Mit pdflatex (PDF-Ausgabe) bearbeiten
    \documentclass[a4paper]{article}
    \usepackage{pdfpages}
    \begin{document}
    \includepdf[pages={{},-},
                nup=1x2,
                landscape=true,
                frame=true,
                noautoscale=true,
                scale=0.65,
                delta=0mm 5mm]{Diplomarbeit.pdf}
    \end{document}
