NeoLeMarc/Diplomarbeit/konzept/projektbeschreibung.odt

# Entwicklung eines Sensornetzes zur Überwachung von Patienten bei einem Massenanfall von Verletzten (MANV)

# Einleitung

Unter dem Begriff „Massenanfall von Verletzten“ (MANV) versteht man ein Ereignis, bei dem innerhalb kurzer Zeit eine große Anzahl von Verletzten versorgt werden muss. Hierbei mögen einem zuerst Vorfälle wie die Terroranschläge am 11. September 2001, die Reaktorkatastrophe von Tschernobyl oder spektakuläre Naturereignisse wie der Hurrikan Katrina, die Flutkatastrophen der letzten Jahre oder die Erdbeben in Haiti in den Sinn kommen.

Doch bereits Ereignisse geringeren Ausmaßes - wie z.B. ein Auffahrunfall auf der Autobahn, ein Zugunglück, eine Massenpanik bei einem Konzert oder starke Schneefälle, wie sie in den letzten Monaten aufgetreten sind - können den Rettungsdienst einer Region sehr schnell an die Grenzen seiner Leistungsfähigkeit bringen.

Beispielhaft seien hier folgende Ereignisse der letzten Jahre und Jahrzehnte genannt:

1980 – Oktoberfestattentat: 13 Tote, 211 Schwerverletzte

1988 – Flugtagunglück von Ramstein: 70 Tote, 1000 Verletzte

1998 – ICE-Katastrophe von Eschede: 101 Tote, 88 Schwerverletzte

2000 – Zugunglück von Brühl: 9 Tote, 149 Verletzte

Dazu kommen jedes Jahr ca. 400.000 Verletzte im Straßenverkehr.

# Motivation

Im Falle eines Massenanfalls von Verletzten treffen vor Ort viele unterschiedliche Einheiten von Rettungskräften aufeinander. Um die Zusammenarbeit dieser Kräfte überhaupt zu ermöglichen und ein geordnetes Vorgehen zu unterstützen gibt es klar definierte Abläufe und Verantwortlichkeiten. Zunächst versuchen die Rettungskräfte die Patienten außerhalb des unmittelbaren Gefahrenbereichs abzulegen. An dieser Ablagestelle werden die Patienten vom Rettungsdienst übernommen, welcher auch bereits Lebensrettende Sofortmaßnahmen einleitet und eine Erstversorgung durchführt. Wenn möglich erfolgt bereits hier eine erste Registrierung der Patienten (Fundort, Name usw.).

Nun werden die Patienten einer Triage, also der Einordnung in verschiedene Schweregrade, unterzogen, um zu entscheiden, in welcher Reihenfolge diese Patienten versorgt werden.

Diese Einordnung ist notwendig, da meist nicht genügend Ressourcen (sowohl Material als auch Personal) vorhanden sind, um sofort alle Patienten zu versorgen. Daher gilt das Ziel, dass möglichst viele Patienten den Vorfall mit einem möglichst geringen Schaden überstehen. Um eine Zuteilung der vorhandenen Ressourcen gemäß dieses Ziels zu gewährleisten, erfolgt eine Einordnung der Patienten in folgende 4 Kategorien:

- T1: akute, vitale Bedrohung => sofortige Behandlung
- T2: nicht lebensbedrohlich verletzt => aufgeschobene Behandlung
- T3: leicht verletzt => spätere Behandlung
- T4: Tot oder ohne Überlebenschance[^1] => keine Behandlung

Für die Entscheidung, in welche Kategorie ein einzelner Patient einzuordnen ist, stehen meist weniger als 60 Sekunden zur Verfügung

Obwohl diese Vorgehensweise eine schnelle Versorgung von Schwerverletzten gewährleistet, stellen sich eine Reihe von Problemen:

1. Patienten können in die falsche Gruppe zugeordnet werden.
2. Möglicherweise verschlechtert sich der Zustand eines Patienten nach seiner Einteilung in die Gruppe T2 rapide, so dass dieser sofortiger Versorgung bedarf.
3. Es besteht ein Konflikt zwischen sorgfältiger Untersuchung und zu wenig zur Verfügung stehender Zeit.

Hierbei ist zu bemerken, dass die Sichtung immer noch ohne besondere technische Hilfsmittel stattfindet. Die Patienten werden mit Hilfe von einfachen Papierkarten markiert, die Überprüfung von Atmung, Puls und Blutdruck erfolgt durch einfache physische Methoden wie Anfassen, Hören und Beobachten.

Insbesondere der zweite Punkt obiger Aufzählung könnte mit technischen Mitteln entschieden verbessert werden. Da eine dauerhafte Überwachung nur deswegen nicht erfolgt, weil nicht genügend Personal zur Verfügung steht, könnten diese durch ein automatisches System ersetzt werden, welches die Patienten überwacht, und im Falle einer Zustandsänderung eine Alarmierung durchführt.

Zwar gibt es automatische Überwachungssysteme (sogenannte Monitore), die in Krankenhäusern oder Rettungsfahrzeugen zur Patientenüberwachung eingesetzt werden, allerdings sind diese Systeme für den Einsatz in einem MANV-Szenario ungeeignet, da sie zu groß, zu teuer und zu kompliziert sind.

# Existierende Lösungen

Bestehende Monitoring-Lösungen für den Feldeinsatz setzten zur Zeit entweder auf die Ableitung des elektrischen EKG-Signals oder auf die Pulsoximetrie (Überwachung der Sauerstoffsättigung im Blut durch Durchleuchtung der Haut).

Bei dem EKG-Verfahren werden über mehrere Elektroden die elektrische Aktivität der Herzmuskelfasern abgeleitet. Entsprechende Geräte sind jedoch relativ aufwendig und störanfällig (das abgeleitete Signal befindet sich im Millivolt Bereich), d.h. Für den Einsatz in einem MANV-Szenario zu teuer. Außerdem ist selbst bei bestehendem EKG-Signal nicht gewährleistet, dass auch tatsächlich eine mechanische Aktivität des Herzens stattfindet (Stichwort: Pulslose Elektrische Aktivität).

Bei der Pulsoximetrie wird hingegen eine Reihe von LEDs eingesetzt, um die Haut zu durchleuchten. Über die Absorption innerhalb eines bestimmten Wellenlängenbereiches kann hierdurch die Sauerstoffsättigung des Bluts bestimmt werden. Außerdem können Pulsschläge detektiert werden. Die Pulsoximetrie reagiert jedoch nur sehr träge auf einen Atemstillstand (Detektionszeit mehrere Minuten!) und arbeitet darüber hinaus bei Patienten im Schockzustand nicht mehr zuverlässig.

Ein neuer Ansatz stellt der von Dr. Marc Jäger entwickelte Erste-Hilfe-Sensor dar. Dieser Sensor wird am Hals des Patienten angebracht und misst kapazitiv Atmung und Puls. Dieses Verfahren hat den Vorteil, dass es zum einen innerhalb kürzester Zeit eine Aussage über den Zustand des Patienten machen kann, und zum anderen sehr kostengünstig zu realisieren ist (Angestrebt ist ein Stückpreis im einstelligen Euro-Bereich).

# Ziele

In dem vorgestellten Projekt soll der oben genannte Erste-Hilfe-Sensor zu einer Monitoringlösung für den Einsatz bei einem MANV weiterentwickelt werden. Mit Hilfe eines Sensornetzes sollen die Sensoren in die Lage versetzt werden, den Zustand des Patienten an eine zentrale Überwachungsstelle zu kommunizieren und so eine fortwährende Überwachung zu gewährleisten. Die Überwachungsstelle soll über eine Benutzeroberfläche verfügen, über die der Zustand er einzelnen Sensoren abgebildet wird. Außerdem sollen Befehle an die Sensoren geschickt werden können.

Im Hintergrund soll eine Aufzeichnung der Vitaldaten der Patienten in eine Datenbank erfolgen, so dass diese später ausgewertet werden können. Im Falle des Eintritts eines kritischen Zustandes soll eine Alarmierung sowohl am Sensor als auch an der Bedienoberfläche erfolgen. Behandelndes medizinisches Personal soll mit Hilfe von Handheld Geräten (Mobiltelefon, PDA etc.) direkt am Patienten Funktionen der Benutzeroberfläche aufrufen können.

# Anforderungen

An die zu entwickelnde Lösung werden folgende Anforderungen gestellt:

Power Management

Die Energieversorgung erfolgt kabellos über Batterien. Hierbei ist auf einen möglich geringen Energiebedarf zu achten, um mit einer möglichst kleinen Stromquelle eine möglichst lange Laufzeit zu gewährleisten (Idealfall: Mehrere Tage Laufzeit mit einer einzelnen Knopfzelle).

Störsicherheit
Das Netzwerk soll selbst bei massiven Störungen (z.B. WLAN, Mobilfunkstrahlung, Bahnstrom) noch zuverlässig funktionieren.

Zuverlässigkeit
Das Gesamtsystem soll Robust gegenüber Störungen und Teilausfällen sein. Das Netzwerk soll sich bei einem Ausfall von Teilkomponenten neu organisieren („Selbstheilung“). Die einzelnen Sensoren sollen auch bei Verlust der Netzwerkverbindung noch eine sinnvolle Funktion erfüllen (z.B. Audiovisuelle Alarmierung mit Hilfe von Summern und LEDs). Sobald das Netzwerk wieder verfügbar ist, sollen die Sensoren selbstständig die Verbindung wieder Aufnehmen. Der Verlust von Sensoren darf nicht unerkannt bleiben (→ Regelmäßige Statusanfrage, „An-Pingen“).

Kabellos
Die Vernetzung der Sensoren soll kabellos erfolgen.

Reichweite
Die Reichweite des Netzwerkes soll für den Einsatz in einem MANV-Szenario ausreichend sein.

Skalierbarkeit
Das Netzwerk soll einfach sowohl um weitere Knoten als auch auf eine größere Fläche erweitert werden können.

Platformunabhängigkeit
Benutzeroberfläche und Server-Komponente sollten sowohl auf dem Betriebssystem Linux als auch unter gängigen Windows-Betriebssystemen lauffähig sein.
Die mobile Oberfläche sollte auf gängigen Mobiltelefonen und PDAs lauffähig sein.

Kostengünstig
Der Preis für einen einzelnen Sensor sollte möglichst gering sein. Angestrebt ist ein Stückpreis unter 20 Euro.

Mindestens MANV-Stufe 2, besser 3
Das Gesamtsystem sollte für die Versorgung von 1000 – mindestens aber 500 Patienten ausreichend Leistungsfähig und skalierbar sein.

# Überblick über das Gesamtsystem

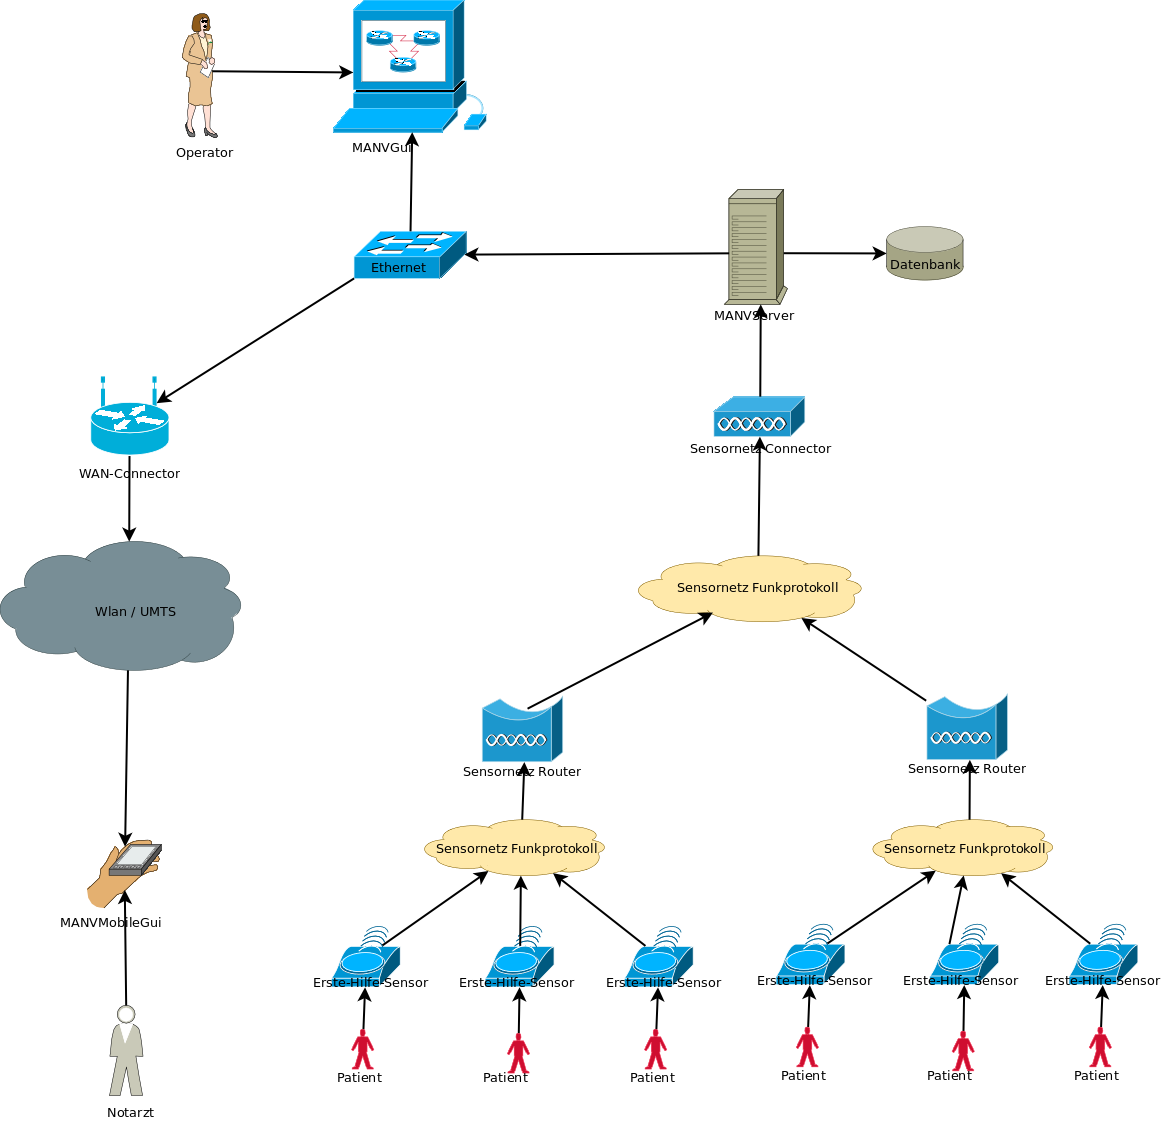
[picture p25: figure]

Bei der Entwicklung des Systems wird ein komponentenbasierter Ansatz gewählt. Hierfür werden Server, GUI und der Treiber für das Sensornetzwerk in einzelne Komponenten gekapselt, die über CORBA miteinander verbunden werden. Die Schnittstellen der einzelnen Komponenten sind klar definiert. Hierdurch wird es sehr einfach, die Hardwareumgebung zu skalieren: In der kleinsten Version können alle Aufgabe von einem Netbook oder Laptop übernommen werden. Wird mehr Leistung benötigt, können die Aufgaben auf verschiedene Serversyteme verteilt werden. Eine Replikation einzelner Komponenten ist möglich, wodurch die Zuverlässigkeit erhöht und die Leistung gesteigert wird.

Das Sensornetzwerk selbst basiert in der ersten Version auf dem ZigBee Standard. Dieser erlaubt es, selbstorganisierte, autonome multi-hop Verbindungen aufzubauen. Das Netzwerk kann mit Hilfe von Routern sowohl vertikal (räumliche Ausbreitung) als auch horizontal (Anzahl der Knoten) skaliert werden. Sollten einzelne Router ausfallen, führt das Netzwerk automatisch eine Reorganisation durch, und ein Ausweichpfad über einen anderen Router wird gewählt.

# Komponenten

  MANVGui
  Die MANVGui ist die graphische Benutzeroberfläche, mit deren Hilfe die Operatoren mit dem Sensornetz kommunizieren. Sie erlaubt die Verwaltung der Knoten, die Zuordnung zu Patienten, die Überwachung der Patienten (Audiovisuelle Signalisierung von Alarmen, Puls- und Atmungsüberwachung mit Verlaufsanzeige), sowie die Konfiguration der einzelnen Knoten. Es können beliebig viele GUIs im Netzwerk vorhanden sein. Zum Betrieb des eigentlichen Netzwerks ist keine GUI erforderlich.
  MANVMobileGui
  Die MANVMobileGui ist eine Version der MANVGui, die speziell für den Einsatz auf Handheld-Geräten optimiert ist. Die Verbindung mit dem MANVServer erfolgt über ein kabelloses Protokoll wie UMTS oder WLAN (je nach Fähigkeit des Handheld-Gerätes). Die MobileGUI wird vom Notarzt direkt am Patienten eingesetzt, und ermöglicht es, schnell die Vitalparameter dieses abzufragen. Außerdem verfügt sie über eine Pager-Funktion, mit der Arzt im Falle eines Alarms benachrichtigt werden kann.
  MANVServer
  Der MANVServer koordiniert die Kommunikation zwischen den einzelnen Komponenten. Er interagiert mit dem Sensornetzwerk über den MANVConnector, leitet von der GUI gesendete Befehle an diesen weiter. Ereignisse wie Alarme, oder Messwerte für Puls und Atmung werden vom MANVConnector an den Server ausgeliefert. Der Server leitet diese dann an alle registrierten GUIs und MobileGUIs weiter. Außerdem werden alle Ereignisse zur späteren Analyse in einer Datenbank gespeichert.
  MANVConnector
  Der MANVConnector kapselt das Funkprotokoll des Sensornetzwerks. Hierdurch wird das Protokoll sehr einfach austauschbar. Es ist möglich, dass das momentan eingesetzt ZigBee Protokoll in Zukunft gegen ein anderes Protokoll ausgetauscht wird (denkbar wäre hier der Bluetooth 3.0 Standard, der ähnliche Eigenschaften wie ZigBee hat). Außerdem kann für spezielle Anwendungen auf ein kabelgebundenes Protokoll wie CAN oder RS485 ausgewichen werden (Dies könnte notwendig sein, wenn das System in einem Krankenhaus oder Flugzeug eingesetzt werden soll).
  MANVCoordinator
  Der MANVCoordinator koordiniert die Kommunikation der Knoten im Sensornetzwerk. Außerdem bildet er die Schnittstelle zwischen MANVConnector und Sensornetzwerk. Geplant ist die Realisierung als USB-Stick.
  Erste-Hilfe-Sensor
  Der Erste-Hilfe-Sensor ist die Hardwarekomponente, die den Patienten überwacht. Er kommuniziert über I²C oder UART mit einem Modul, das die Verbindung mit dem Sensornetzwerk herstellt.
  MANVFirmware
  Die MANVFirmware ist ein Binary, das auf dem Erste-Hilfe-Sensor ausgeführt wird. Sie ist für die Überwachung des Patienten sowie der Kommunikation mit dem Sensornetzwerk zuständig. Die Implementierung erfolgt in Form eines in C geschriebenen Binaries.

# Eingesetzte Technologien

  Java
  Die GUIs, der Connector sowie der Server sind in Java geschrieben. Dies gewährleistet die notwendige Platformunabhängigkeit.
  Swing
  Für die Realisierung der GUI wird Java Swing verwendet.
  CORBA
  Die Kommunikation der Softwarekomponenten erfolgt mittels CORBA.
  PostgreSQL
  Für die Speicherung von Ereignissen wird eine PostgreSQL-Datenbank eingesetzt. Prinzipiell kann jede Datenbank verwendet werden, für die ein JDBC-Treiber existiert.
  Linux/Windows
  Server und GUI können sowohl unter Windows als auch unter Linux eingesetzt werden. Prinzipiell ist der Einsatz auf jedem Betriebssystem denkbar, das über eine Java-Virtual-Machine verfügt.
  Eclipse
  Für die Entwicklung der Java Komponenten wird Eclipse als integrierte Entwicklungsumgebung verwendet.
  CrossWorks
  Die Firmware des Erste-Hilfe-Sensors wird die Software CrossWorks von Rowley Associates verwendet.
  Mentor CHS
  Alle notwendige Platinen werden mit dem EDA-Tool Mentor CHS entworfen. Die prototypische Entwicklung erfolgt im Ätzbad.
  Aduc702X-Mikrocontroller
  Die Hardware des Erste-Hilfe-Sensors ist auf Grundlage des ARM7TDMI basierten Analog Devices Aduc702x Mikrocontrollers realisiert.
  Atmel-ZigBit
  Für die Kommunikation zwischen Mikrocontroller und Sensornetzwerks wird ein OEM-Modul von Atmel (ZigBit) eingesetzt. Hierbei handelt es sich um eine fertiges Modul, das im wesentlichen aus einem Transmitter, einem Mikrocontroller sowie einem ZigBee-Protokollstack besteht.

# Machbarkeitsnachweis

Vor Beginn der Arbeit wurde bereits ein Proof of Concept durchgeführt, um die Realisierbarkeit des Projektes zu zeigen. Hierzu wurden einige Prototyp Platinen gefertigt, die es ermöglichen, die 2 Atmel ZigBit-Module auf jeweils ein Steckbrett aufzustecken. Auf dem Steckbrett wurde mit einem MAX3232 Baustein eine Verbindung zwischen Funkmodul und PC hergestellt. Danach wurde ein Python-Skript verwendet, um die Module anzusteuern, und Testnachrichten zu verschicken. Hierdurch konnte gezeigt werden, dass es möglich ist, die ZigBit Module anzusteuern, und Nachrichten zu verschicken.

In einem weiteren Test wurden Prototypen der zu realisierenden Java-Komponenten entwickelt, und über CORBA verbunden. Ein Simulator sendete einige zufällige Ereignisse über CORBA an den Prototyp des Servers. Dieser sendete diese an den Prototyp der GUI weiter, welche diese wiederum als Textnachricht in einem Fenster auf dem Bildschirm de Benutzer darstellte. Die einzelnen Komponenten liefen hierbei jeweils auf zwei verschiedenen Rechnern, die über WLAN miteinander verbunden waren. Mit diesem Test konnte gezeigt werden, dass die Verbindung über CORBA funktioniert, und ein Austausch von Nachrichten über ein TCP/IP-Netzwerk möglich ist.

Zuletzt wurde noch die Verbindung zwischen Mikrocontroller und ZigBit Modul getestet. Hierzu wurden Mikrocontroller und ZigBit Modul über eine Kabelbrücke auf dem Steckbrett miteinander verbunden. Auf dem Mikrocontroller wurde nun ein Programm gestartet, dass im 10-Sekunden-Intervall die Nachricht „TEST“ verwendet. Mit einem Terminalprogramm wurde vom PC aus eine Verbindung mit dem zweiten ZigBit Modul aufgebaut, und die Testnachricht konnte erfolgreich empfangen werden. Mit diesem Test wurde gezeigt, dass die Kommunikation zwischen Mikrocontroller und ZigBit Modul funktioniert, und es möglich ist, vom Mikrocontroller aus Nachrichten zu versenden.

# Aufteilung zwischen Diplomarbeit und Studienarbeit

Da das Projekt sehr umfangreich ist, wurde es auf in zwei Teile zerlegt. Der Entwurf des Gesamtsystems, die Realisierung des Sensornetzwerks, die Rechnerschnittstelle sowie alle Hardwarekomponenten werden in Form einer Diplomarbeit realisiert. Inhalt der Arbeit ist der Entwurf und die Implementierung eines komplexen Systems, das sowohl aus Software- als auch Hardware besteht.

Graphische Benutzeroberfläche und Server wurden als Einheit zusammengefasst und sollen in Form einer Studienarbeit realisiert werden. Ziel der Arbeit ist der Entwurf und Implementierung einer verteilten Anwendung. Die Vorgehensweise entspricht dem Design-By-Contract: Im Rahmen der Diplomarbeit wird eine Schnittstelle zwischen den beiden Arbeiten definiert. Dem Studienarbeiter steht es frei, in welcher Form diese implementiert werden. Er muss hier selbst den Entwurf und die Implementierung durchführen, da diese von der Diplomarbeit nicht vorgegeben werden. Ziel der Studienarbeit ist der ingenieurhaft Entwurf und Implementierung einer verteilten Anwendung mit Hilfe der Verfahren der Softwaretechnik und der Objektorientierten Programmierung.

Durch die Realisierung des Gesamtprojektes im Team stellt ein besonderes Alleinstellungsmerkmal dieser beiden Arbeiten dar. Um das Projekt erfolgreich durchzuführen muss eine klare Trennung zwischen den beiden Arbeiten erfolgen. Darüber hinaus ist eine ingenieurhafte Herangehensweise zwingend erforderlich, um Interaktion der beiden entworfenen Teile zu gewährleisten. Dies entspricht insbesondere der Realität der Tätigkeit eines Informatikers in der Industrie, wo die Teamarbeit schon lange Alltag ist, und die Fähigkeit dazu immer mehr gefragt ist.

# Herausforderungen

Powermanagement:

Die Energieversorgung des Erste-Hilfe-Sensors basiert in der aktuellen Ausführung auf einer einzelnen Knopfzelle. In einem MANV-Szenario muss hiermit ein Betrieb über mehrere Stunden gewährleistet sein. Dies stellt besondere Anforderungen an das zu entwickelnde Sensornetz, und schließt von vornherein energiehungrige Technologien wie WLAN oder UMTS als Übertragungsprotokoll aus. Ideal wäre eine Lösung, die einen Energiesparmodus (Idle-Mode) besitzt.

Integration von Netzwerkmodul in Erste-Hilfe-Sensor:

Um eine Verbindung zwischen Sensornetz und Erste-Hilfe-Sensor herzustellen, muss das Netzwerk-Modul in den Erste-Hilfe-Sensor integriert werden. Hierzu ist es notwendig, das Platinenlayout des Erste-Hilfe-Sensors entsprechend anzupassen. Darüber hinaus muss die Firmware (s.u.) des Sensors angepasst werden.

Firmware:

Von der Standard-Bibliothek und dem Startup-Code abgesehen, wird die Firmware des Erste-Hilfe-Sensors direkt auf dem verwendeten Mikrocontroller ausgeführt. Es ist weder Treibersoftware noch Unterstützung für Multitasking oder Threads vorhanden. Um das Netzwerkmodul anzubinden, muss sowohl ein Treiber für die verbindende Schnittstelle (abhängig vom Modultyp entweder SPI, I²C oder UART), als auch für das Netzwerkmodul selbst entworfen werden. Hierbei kommt ein Interrupt-getriebenes Programmiermodell zum Einsatz, welches besondere Anforderungen an die Programmierung stellt. Insbesondere müssen Timing-Probleme gelöst werden. Die beschränkten Ressourcen des Mikrocontrollers (16kByte RAM, 10 MHz Takt) stellen eine weitere Herausforderung dar.

Anbindung an Java:

Die Verbindung zwischen dem Sensornetzwerk und dem Servercomputer findet mittels USB statt. Es stellt sich nun das Problem, dass mittels Java auf diese USB-Verbindung zugegriffen werden muss. Normalerweise müsste hierfür ein Treiber für das entsprechende Betriebssystem geschrieben werden, welcher über eine Standardschnittstelle wie z.B. einen Socket von Java angesprochen wird. Eine Alternative wäre ein Zugriff über ein Java-Native-Interface (JNI). Beide Möglichkeiten wären jedoch nicht mehr platformunabhängig. In der Diplomarbeit ist zu überprüfen, ob eine platformunabhängige Lösung gefunden werden kann.

Anzahl der zu überwachenden Patienten:

Mit der zu entwickelnden Lösung muss eine Vielzahl von Patienten gleichzeitig versorgt werden können (Planungsszenario für ein MANV der Stufe 2 oder 3 sind 500 bzw. 1000 Verletzte). Dadurch stellen sich besondere Anforderungen an das Netzwerk. Zunächst einmal muss das Netzwerkprotokoll eine solch hohe Zahl an Teilnehmer unterstützen. Es muss gewährleistet sein, dass trotz der großen Teilnehmerzahl trotzdem noch möglich ist, dass eine Kommunikation zwischen den Knoten zuverlässig stattfinden kann. Es darf nicht zu einem übermäßigen auftreten von Kollisionen bzw. Paketverlusten kommen. Auftretende Fehler müssen vom Netzwerk entsprechend behandelt werden.

Usability:

Der Anwenderkreis der zu entwickelnden Lösung besteht aus medizinischem Personal (Notärzte, Rettungssanitäter usw.). Die zu entwickelnde Lösung muss daher ohne besonderen technischen Hintergrund aufzubauen und einzusetzen sein. Hierbei muss insbesondere bei der Gestaltung der Graphischen Oberfläche geachtet werden.

Nummerierung der Sensoren:

Zur Identifikation im Sensornetzwerk verfügt jeder Sensor über eine eindeutige Kennung (ID). Im Feldeinsatz ist die alleinige Identifikation über diese ID-Nummer jedoch unpraktikabel. Die Sensoren müssen sinnvoll in Gruppen organisiert werden (z.B. nach Zelten) und die Zuordnung zum Patienten muss leicht erkennbar sein. Die Zuordnung muss innerhalb weniger Sekunden mit wenig Aufwand vorgenommen werden können.

Ausfallsicherheit:

Das Netzwerk muss möglichst ausfallsicher sein. Hierzu gehört zum einen, dass das Netzwerkprotokoll robust gegen Störungen sein muss. Beim Ausfall einzelner Teilnehmer des Netzwerkes dürfen andere Teilnehmer nicht beeinflusst werden. Im Falle des Ausfalls zentraler Komponenten muss gewährleistet sein, dass das Netzwerk nach wieder Inbetriebnahme dieser Komponenten ohne Probleme seine Funktionalität wieder aufnimmt. Zustandsdaten der einzelnen Komponenten sollen persistent sein (im Falle der Server-Komponente in einer Datenbank, für die einzelne Sensoren durch speichern in einem Flash-Speicher oder NVRAM). Auf keinen Fall sollte nach einem Totalausfall eine Neukonfiguration erforderlich sein. Im Falle eines Ausfalls des Netzwerkes sollen die einzelnen Sensoren weiterhin funktionieren und mit Hilfe von Signaltönen und LEDs Ihren Status signalisieren.

[^1] Die Arbeitsgemeinschaft der Notärzte in Deutschland hält die Einteilung in die Kategorie „Sterbende ohne Chancen“ für äußerst fragwürdig, die im modernen Rettungswesen nicht vorgenommen werden sollte.
