NeoLeMarc/Diplomarbeit/konzept/projektbeschreibung_arzt.odt

# Sensornetzwerk zur Überwachung von Patienten bei einem Massenanfall von Verletzten

## Kurzbeschreibung

Ziel des Projektes ist die Erstellung eines Überwachungssystems zum Einsatz in einem MANV-Szenario. Das System besteht aus Sensoren, die an den zu überwachenden Patienten angebracht werden. Diese Sensoren sollen optisch (per LED) sowie akustisch (Über einen Signalton) einen kritischen Kreislaufzustand des überwachten Patienten signalisieren. Zusätzlich verfügt jeder Sensor über eine Funkschnittstelle. Diese dient sowohl zur Überwachung als auch zur Fernsteuerung der einzelnen Sensoren. Hierzu meldet jeder Sensor in einem Abstand von jeweils 10 Sekunden seinen aktuellen Zustand an eine zentrale Überwachungsstation, an der der Alarm durch eine Meldung auf einem Bildschirm sowie durch einen Warnton signalisiert wird. Von der Zentrale aus kann eine automatische Weiterleitung des Signals auf einen Pager, ein PDA oder ein Mobiltelefon erfolgen. Darüber hinaus gibt es ein Handgerät, mit dem ein Arzt von unterwegs auf die Zentrale zugreifen kann. Hierbei können sowohl der Zustand einzelner Patienten eingesehen werden, als auch eine Fernsteuerung der Sensoren durchgeführt werden.

Die Fernsteuerung umfasst die Funktionen “Alarm Stumm schalten” sowie “Alarm manuell auslösen”.

Die von den Sensoren an die Zentrale übertragenen Vitalparameter werden in einer Datenbank gespeichert. Zusätzlich soll es möglich sein, weitere Daten wie Name, Fundort, Zeitpunkt etc. zu dem Patienten zu vermerken. Die Zentrale kann im einfachsten Fall aus einem einzelnen Notebook-Computer bestehen. Zur Ausfallsicherheit kann ein weitere Notebook-Computer angeschlossen werden, der bei Ausfall des ersten Gerätes die Kontrolle über das Netzwerk übernimmt.

Zur Bestimmung des aktuellen Zustands des Patienten werden die Parameter “Atmung” und “Puls” überwacht. Hierzu wird ein von Dr. Marc Jäger entwickeltes Verfahren eingesetzt.

## Eigenschaften

Das zu entwickelnde System basiert auf dem ZigBee Funkstandard. Dieser gewährleistet eine zuverlässige Funkübertragung bei gleichzeitig niedrigem Energiebedarf. Das System soll folgende Eigenschaften erfüllen:

- Hohe Reichweite durch den Einsatz von Funk-Repeatern
- Lange Akkulaufzeit
- Hohe Zuverlässigkeit
- Geringe Kosten
- Überwachung von bis zu 500 Patienten gleichzeitig.
- Outdoor-Einsatz möglich

# Konkurrenzprodukte

In einer kurzen Internetrecherche konnten keine vergleichbaren Konkurrenzprodukte anderer Hersteller gefunden werden. Zwar existieren kabellose Lösungen von Herstellern wie Dräger Medical, Philips, GE und WelchAllyn, allerdings scheint es sich hierbei mehr um kabellose Varianten klassischer Krankenhausmonitore zu handeln, bei denen neben einem 12 Kanal EKG auch Parameter wie Blutdruck und SPo2 überwacht werden können.

Am ähnlichsten scheint das Mobile Acuity System der Firma WelchAllyn zu sein: http://www.welchallyn.com/products/en-us/x-11-ac-100-0000000001099.htm

Hierbei können mit einem einzelnen Notebook-Computer bis zu 12 Patienten kabellos überwacht werden. Das gesamte System ist skalierbar auf bis zu 120 Patienten – allerdings müssen hierfür 10 Notebook-Computer verbunden werden.

Unsere Lösung weist im Vergleich zu allen existierenden Lösungen einen deutlichen Kostenvorteil auf, da zum einen die einzelnen Sensoren deutlich billiger sind als die Konkurrenz, und zum anderen mit einem einzelnen Notebook bis zu 500 Patienten überwacht werden können. Dafür kann von unserer Lösung lediglich Puls und Atmung überwacht werden, während von den Konkurrenzprodukten eine Vielzahl von Parametern überwacht werden können.

# Zuordnung zwischen Patienten und Sensoren

Ein noch ungelöstes Problem ist die Zuordnung zwischen Patient und Sensor. Die Sensoren sind durchnummeriert und werden aktuell in der Überwachungssoftware mit ihrer Nummer angezeigt. Bei einer möglichen Anzahl von bis zu 500 Patienten stellt sich nun die Frage, wie der durch einen Alarm betroffene Patient gefunden werden kann. Es wäre z.B. möglich, die einzelnen Sensoren fest einem Bett zuzuordnen. Ist dies sinnvoll? Gibt es evtl. sinnvolle Alternativen?

# Weitere Offene Fragen

Ist die Überwachung von Puls und Atmung für den MANV-Einsatz ausreichend, oder sollten auch weitere Parameter wie SPo2 und EKG überwacht werden?

Ist die Anzahl von 500 zu überwachenden Patienten angemessen?

Ist es hinnehmbar, dass Alarme schlimmstenfalls mit einer Verzögerung von 10 Sekunden in der Zentrale dargestellt werden?

Wie lange sollte die Akkulaufzeit der einzelnen Sensoren sein?

Wie sollte sich das System verhalten, falls die Funkverbindung mit der Zentrale zusammenbricht?

In welcher Art sollten Alarme signalisiert werden?

Welche weiteren Anforderungen sollten für den MANV-Einsatz beachtet werden?

Welche Funktionalität sollte die Überwachungssoftware bieten?

Ist eine Speicherung der Messdaten sinnvoll/erwünscht oder sollte diese unterbleiben?

Wie groß sollte die Reichweite der Funkschnittstelle der Sensoren sein?
