NeoLeMarc/Diplomarbeit/vortrag_tng2/vortrag.pdf

Kabellose Sensornetze: ZigBee, Bluetooth & co.

Marcel Noe

TNG Technology Consulting GmbH

Noe (TNG) | 2013 | 1 / 26

Einf ¨uhrung

## Uberblick ¨

### 1 Motivation

### 2 Anwendungen

### 3 Grundlagen der kabellosen Datenubertragung ¨

### 4 Verschiedene Technologien

### 5 Marktubersicht 2013 ¨

### 6 Security

### 7 Aus der Alptraumabteilung

8 | Further reading Noe (TNG) | 2013 | 2 / 26

Motivation Was ist ein Sensornetz?

## Was ist ein Sensornetz?

Netzwerk aus
vielen verteilten
Sensorknoten
Oft ad-hoc
vernetzt
Energieversorgung
meist uber Batterie ¨


Noe (TNG) | 2013 | 3 / 26

Grundlagen der kabellosen Daten ¨ubertragung Die ISM Bander ¨

## Die ISM Bander ¨

6,765 MHz
13,553 MHz
26,957 MHz
40,66 MHz
433 MHz
902 MHz
2,4 GHz
5,7 GHz
24 GHz
61 GHz
122 GHz
244 GHz

In den meisten Landern ¨
fur jeden frei ¨
verwendbare
Frequenzbander ¨
Alle kabellosen
Consumerprodukte
verwenden eines der
ISM-Bander ¨
Verwendung anderer
Frequenzen benotigt ¨
spezielle Lizenzen
Noe (TNG) | 2013 | 4 / 26

Grundlagen der kabellosen Daten ¨ubertragung Eigenschaften verschiedener Frequenzbander ¨

## Eigenschaften verschiedener Frequenzbander ¨

Grundsatzlich: Je h ¨ | oher die Frequenz, desto h ¨ | oher die ¨
Datenubertragungsraten. Aber desto schlechter auch Reichweite ein ¨ Eindringtiefe.
Noe (TNG) | 2013 | 5 / 26

Grundlagen der kabellosen Daten ¨ubertragung Eigenschaften verschiedener Frequenzbander ¨

## 900 MHz

ca. 2,6 fache Reichweite wie 2,4GHz
Bandbreite: 26 MHz (1/3 wie im 2,4GHz Band)
Nur in Region 2 (Hauptsachlich Amerika. ¨ | nicht Europa)
Noe (TNG) | 2013 | 6 / 26

Grundlagen der kabellosen Daten ¨ubertragung Eigenschaften verschiedener Frequenzbander ¨

## 2.4 GHz Band

Reichweite ungerichtet bis ca. 100m Maximal zulassige Sendeleistung: 100mW ¨ Weltweit zulassig ¨
Bandbreite: 100MHz
Noe (TNG) | 2013 | 7 / 26

Grundlagen der kabellosen Daten ¨ubertragung Eigenschaften verschiedener Frequenzbander ¨

## 5 GHz

Maximal zulassige Sendeleistung: 1W, daher theoretisch h ¨ | ohere ¨
Reichweite als 2,4GHz
Weltweit zulassig (Ausgenommen bestimmte Kan ¨ | ale, z.B. in ¨
Japan)
DFS und TPC zwingend vogeschrieben, um militarische ¨ Anwendungen nicht zu storen ¨
Bandbreite: 150MHz
Weniger ”Betrieb” als im 2,4GHz Band
Noe (TNG) | 2013 | 8 / 26

## Frequenzspreizung: Motivation

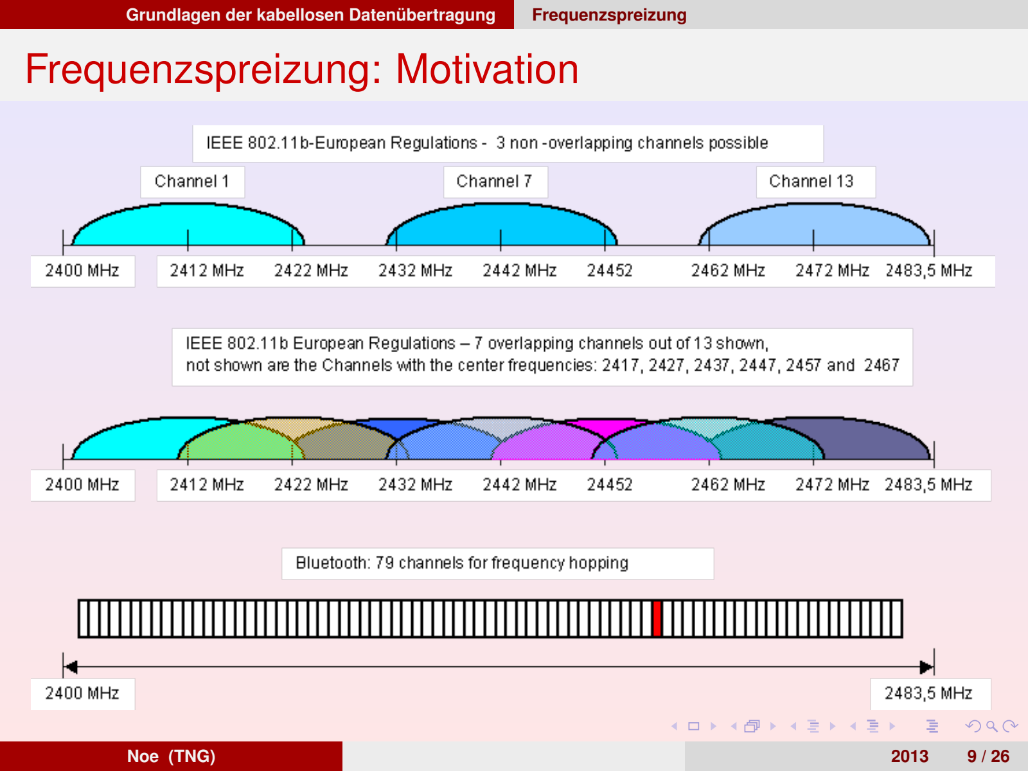
[picture p26: page 9]

Grundlagen der kabellosen Daten ¨ubertragung | Frequenzspreizung
Noe (TNG) | 2013 | 9 / 26

Grundlagen der kabellosen Daten ¨ubertragung Frequenzspreizung

## FHSS: Frequency Hopping Spread Spectrum

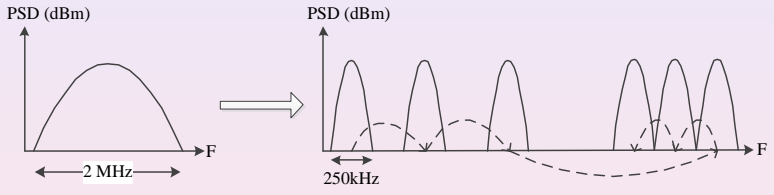
[picture p27: figure]
PSD (dBm); 2 MHz; 250kHz

Noe (TNG) | 2013 | 10 / 26

Grundlagen der kabellosen Daten ¨ubertragung Frequenzspreizung

## DSSS: Direct Sequence Spread Spectrum

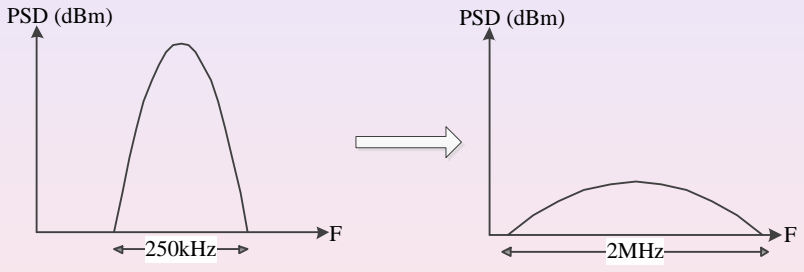
[picture p28: figure]
PSD (dBm); F 250kHz; 2MHz

Noe (TNG) | 2013 | 11 / 26

Verschiedene Technologien WLAN

## IEEE 802.11: WLAN


2,4GHz und 5GHz
Ubertragungsraten bis 150Mbit/sec ¨

Reichweiten ungerichtet bis ca. 100m, bei Sichtverbindung mit externer Antenne sogar bis 300m
Richtfunk bis ca. 40km
Je nach Standard: Verwendung von DSSS, FHSS und OFDM
Relativ hoher Leistungsbedarf: 100mA zum Empfangen, 190mA zum Senden Ad-Hoc Modus moglich ¨


Noe (TNG) | 2013 | 12 / 26

Verschiedene Technologien Bluetooth

## Bluetooth

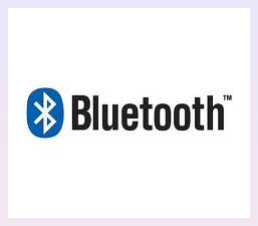
[picture p29: figure]

2,4GHz
Ubertragungsraten bis 2,1MBit/sec ¨

Reichweite bis 10m (Class 3), 50m (Class 2), 100m (Class 3)
FHSS
Leistungsbedarf ca. 56,7mW (16,6mA) fur¨ ein Class 2 Slave
Maximal 255 Teilnehmer
Jedoch nur 7 gleichzeitig aktive Slaves
1 Master
Teilnehmer mussen gepaired werden ¨


Noe (TNG) | 2013 | 13 / 26

Verschiedene Technologien ZigBee

## ZigBee

APL (Anwendung)

SEC (Security)

NWK (Vermittlung)

MAC (Sicherung)

PHY (Bitübertragung)

IEEE 802.15.4 ZigBee

Protokollstack auf Basis von IEEE 802.15.4
868MHz (nur Europa), 900MHz (nur Amerika) und 2,4GHz (weltweit) 1mW Sendeleistung
Reichweite bis ca. 100 Meter
DSSS
Ubertragungsrate: 20kbit/sec ¨ (868MHz), 40kbit/sec (900MHz), 250kbit/sec (2,4GHz)
19mA im Betrieb, 6µA im
Sleep-Modus (Nur auf RFDs)
FFDs (Full Functional Devices) und RFDs (Reduced Functional Devices) Mesh-Netzwerk bei Verwendung
Noe (TNG) | 2013 | 14 / 26

Markt ¨ubersicht 2013 National Instruments

## NI wireless sensor networks


Programmierbare Ethernet und Wlan Gateways verfugbar ¨
Knoten mit 4 digitalen und 4 analogen Eingangen ¨
Anbindung an LabVIEW
Proprietares Protokoll auf Basis von ¨ IEEE 802.15.4
Relativ teuer: ca. 500 Euro pro Sensorknoten
Noe (TNG) | 2013 | 15 / 26

Markt ¨ubersicht 2013 Libelium

## Libelium

Sensornetzprodukte auf ZigBee Basis
Sowohl als kostengunstige ¨ Entwicklerboards als auch als fertige
Komplettlosung verf ¨ | ugbar ¨
Unabhangige Energieversorgung ¨ uber Solarzellen ¨
Multiprotokoll-Gateways mit ZigBee, Wlan und Bluetooth
Opensource Software
Losungen f ¨ | ur Smartcities ¨
Reichweite nach Herstellerangabe zwischen 7 und 14km

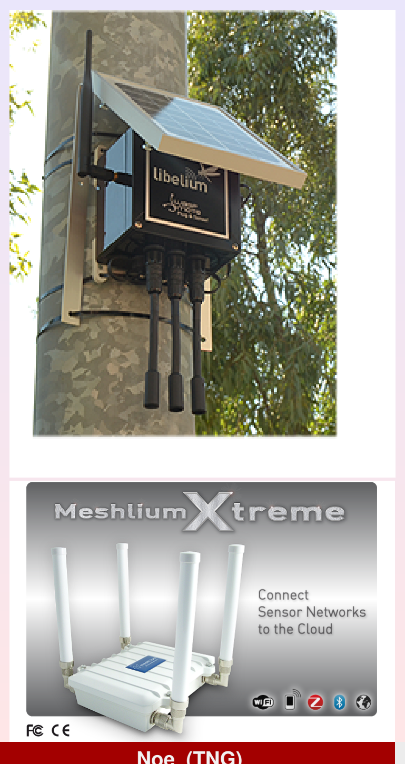
[picture p30: figure]

Noe (TNG) | 2013 | 16 / 26

Markt ¨ubersicht 2013 Zum selber basteln

## Arduino


ZigBee Schild fur Arduino ¨ Sockel fur ein Digi International ¨ XBee Pro
Preis fur Modul und Schild ¨
zusammen unter 40 Euro
XBee Module sind in verschiedenen
Ausfuhrungen erh ¨ | altlich, die ¨
teilweise Pin-kompatibel sind Hergestellt von Libelium, Grundlage fur die kommerziellen Waspmotes ¨
Noe (TNG) | 2013 | 17 / 26

Markt ¨ubersicht 2013 Zum selber basteln

## Raspberry Pi

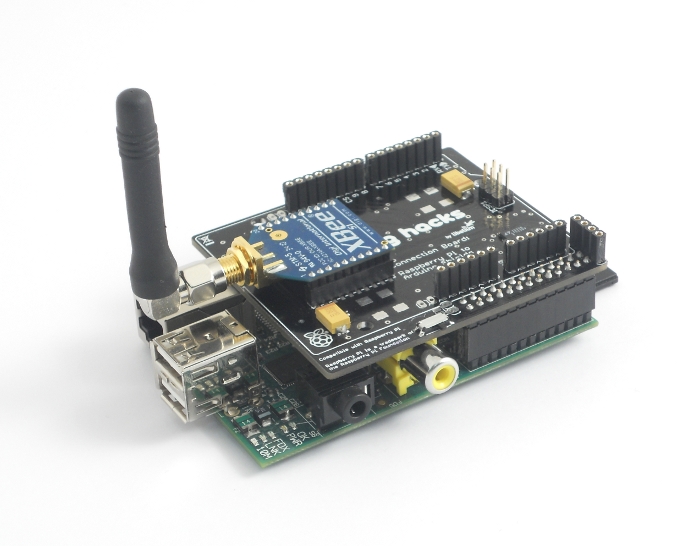
[picture p31: figure]

Verwendung des Arduino ZigBee Schild mit Hilfe der Raspberry Pi to Arduino Shield.
Preis fur den Adapter: 40 Euro ¨
Noe (TNG) | 2013 | 18 / 26

Markt ¨ubersicht 2013 Zum selber basteln

## ZigBit

Kombination aus IEEE.802.15.4 Radios mit einem ATmega1281V Mikrocontroller
30 GPIO Leitungen
UART, USART, I2C, SPI, 1-Wire, 4 ADCs, JTAG
Stuckpreis um die 14 Euro ¨
Mit etwas Geschick im Loten ¨ praktisch schon ein komplettes Starterkit.

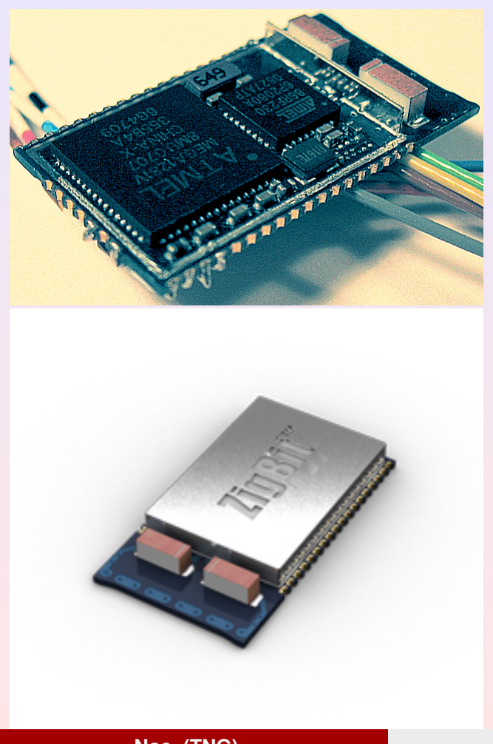
[picture p32: figure]

Noe (TNG) | 2013 | 19 / 26

Security ZigBee: WEP Reloaded

## ZigBee: WEP Reloaded


Theoretisch 128-Bit-AES
Verschlusselung ¨
Aber oft managelhaftes
Key-Management:
Jedes Device in einem Netzwerk hat den selben PSK
Keys konnen mittels JTAG extrahiert ¨ werden
Oft schlecht gewahlte Keys ¨
Kein Schutz gegen Replay Attacken Known-Plaintext Attacken moglich ¨ Besser: Security auf Application Layer. Aber: Auf einem 8-Bit Mikrocontroller...
Noe (TNG) | 2013 | 20 / 26

Security Kisbee

## Kisbee

Projekt von den Kismet Autoren zum Angriff auf ZigBee Netze
Lauft auf Android ¨
ZigBee Device kann per Bluetooth oder USB angebunden werden

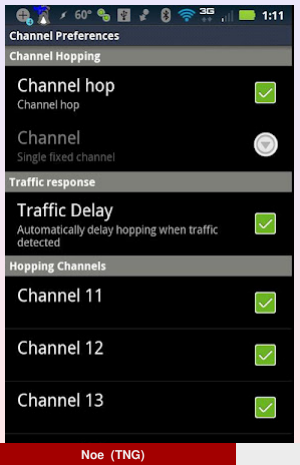
[picture p33: figure]

Noe (TNG) | 2013 | 21 / 26

Security Ich sehe was, was Du nicht siehst: Introducing HackRF

## HackRF

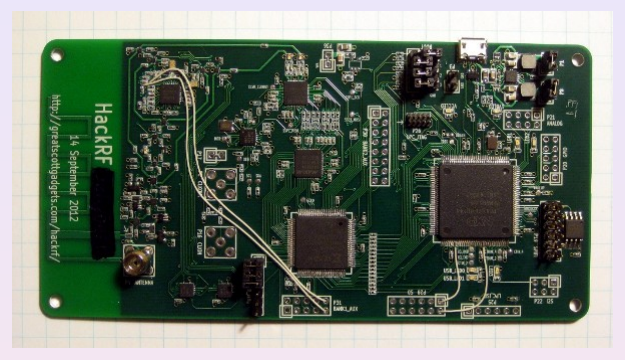
[picture p34: figure]

Idee: Low cost devices, das in der Lage ist, auf praktisch allen verwendeten Frequenzen zu
Senden und zu Empfangen
Damit werden auch Attacken auf Protokolle ausserhalb des
ISM-Bandes moglich (z.B. GSM) ¨ Oder auf NFC, RFID...
Integration in GNURadio
Alle Bauteile sind auf kompatibilitat¨ mit OpenSourceSoftware sowie Robustheit ausgelegt
Noe (TNG) | 2013 | 22 / 26

Aus der Alptraumabteilung Smart dust

## Smart dust


Noe (TNG) | 2013 | 23 / 26

## Meine Kleidung funkt!

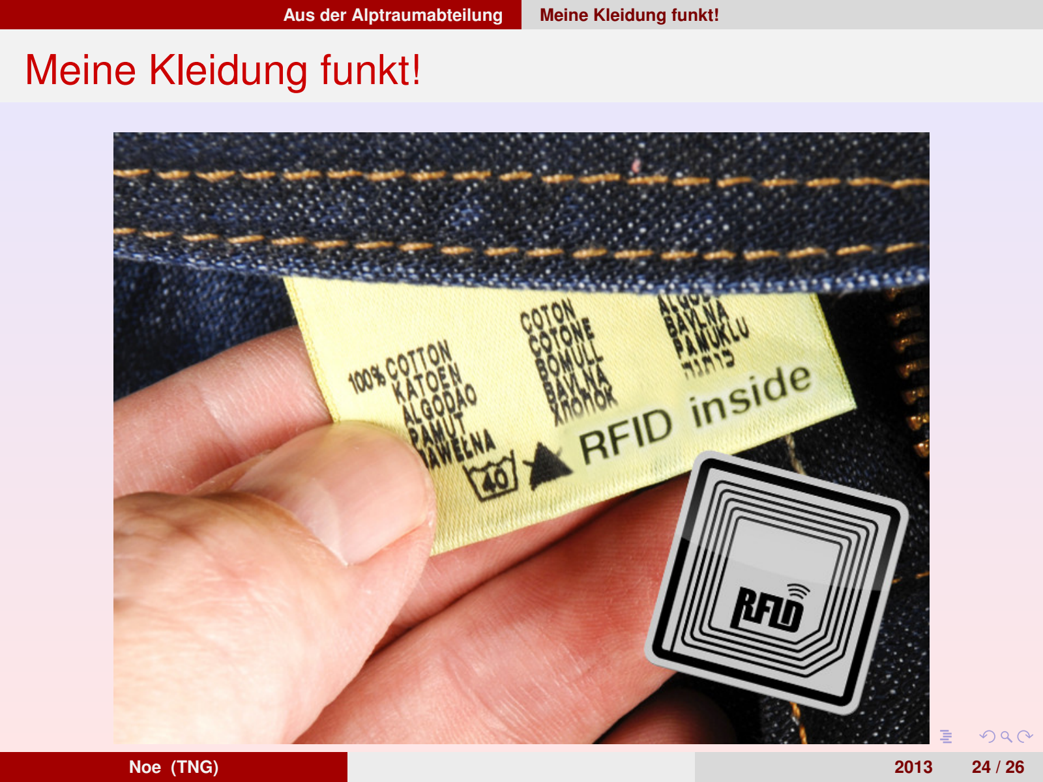
[picture p35: page 24]

Aus der Alptraumabteilung | Meine Kleidung funkt!
Noe (TNG) | 2013 | 24 / 26

Aus der Alptraumabteilung Tracking

## Tracking

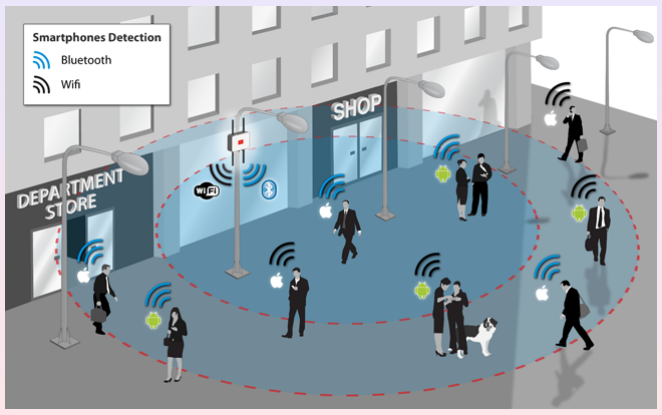
[picture p36: figure]

Noe (TNG) | 2013 | 25 / 26

Further reading

## Further Reading

https://dev.noetech.net/svn/diplomarbeit/User: anonymous
Passwort: anonymous
Noe (TNG) | 2013 | 26 / 26
