NeoLeMarc/Diplomarbeit/vortrag_tng/vortrag.pdf

# Eine kurze Einfuhrung in die biomedizinische ¨ Meßtechnik

# Marcel Noe

## TNG Technology Consulting GmbH

Noe (TNG) | Patienten unter Strom: Mein erstes EKG | 2012 | 1 / 21

Einf ¨uhrung

# Uberblick ¨

# 1 Einfuhrung ¨

# 2 Medizinische Grundlagen

# 3 Messtechnik

Noe (TNG) | Patienten unter Strom: Mein erstes EKG | 2012 | 2 / 21

Einf ¨uhrung Motivation

# Intensivstation

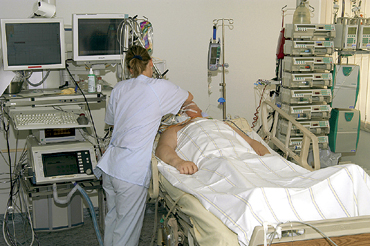
[picture p37: figure]

# Foo

# Bar

# Foobar

Noe (TNG) | Patienten unter Strom: Mein erstes EKG | 2012 | 3 / 21

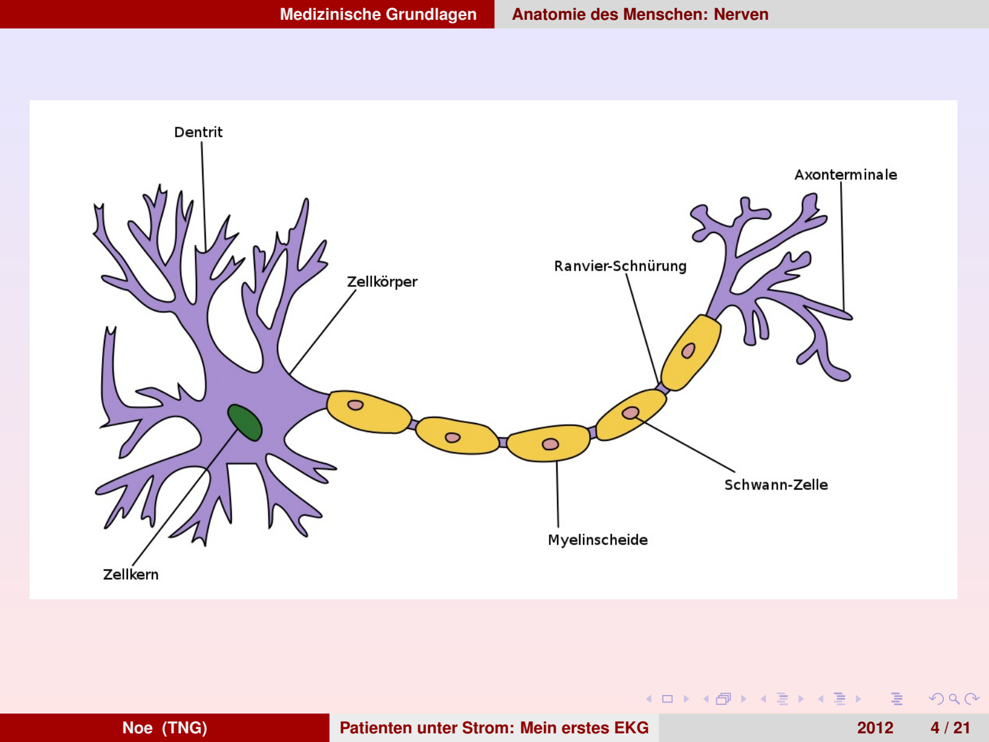
[picture p38: page 4]

Medizinische Grundlagen | Anatomie des Menschen: Nerven
Noe (TNG) | Patienten unter Strom: Mein erstes EKG | 2012 | 4 / 21

Medizinische Grundlagen | Anatomie des Menschen: Nerven

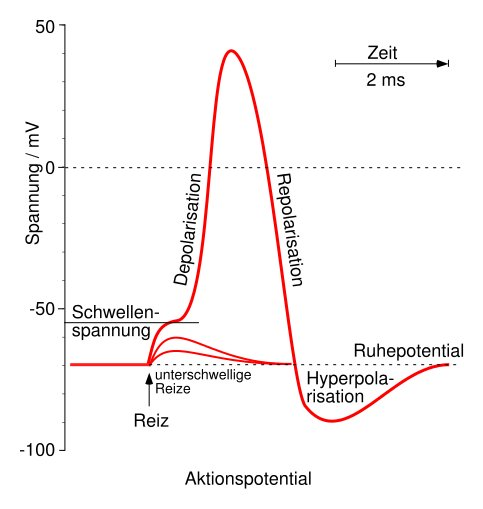
[picture p39: figure]

Noe (TNG) | Patienten unter Strom: Mein erstes EKG | 2012 | 5 / 21

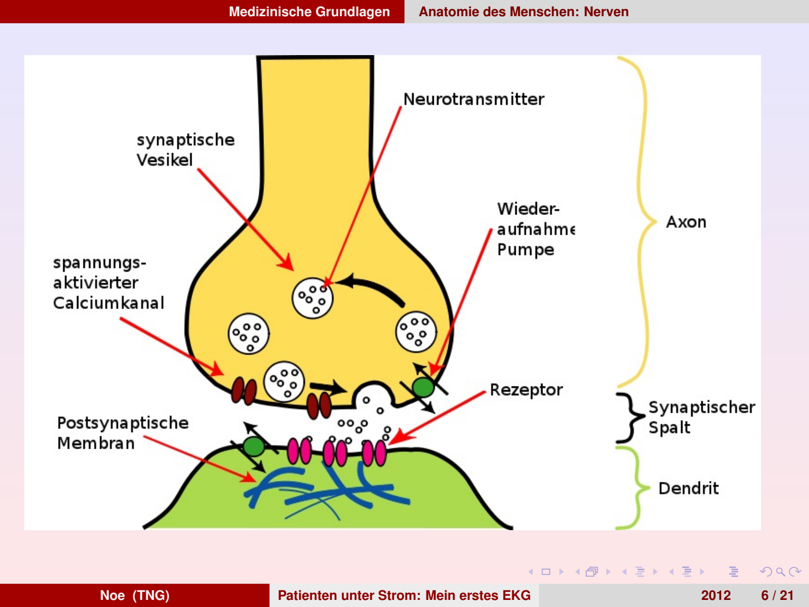
[picture p40: page 6]

Medizinische Grundlagen | Anatomie des Menschen: Nerven
Noe (TNG) | Patienten unter Strom: Mein erstes EKG | 2012 | 6 / 21

Medizinische Grundlagen | Anatomie des Menschen: Blutgefaße ¨

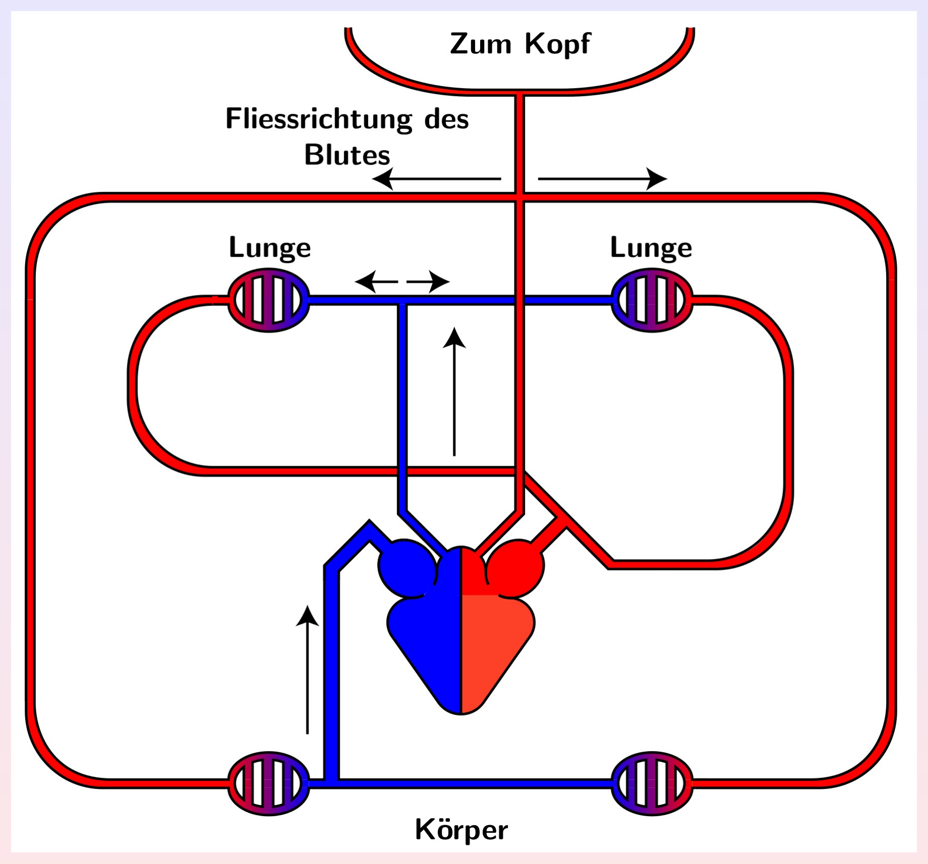
[picture p41: figure]

Noe (TNG) | Patienten unter Strom: Mein erstes EKG | 2012 | 7 / 21

Medizinische Grundlagen | Anatomie des Menschen: Herz

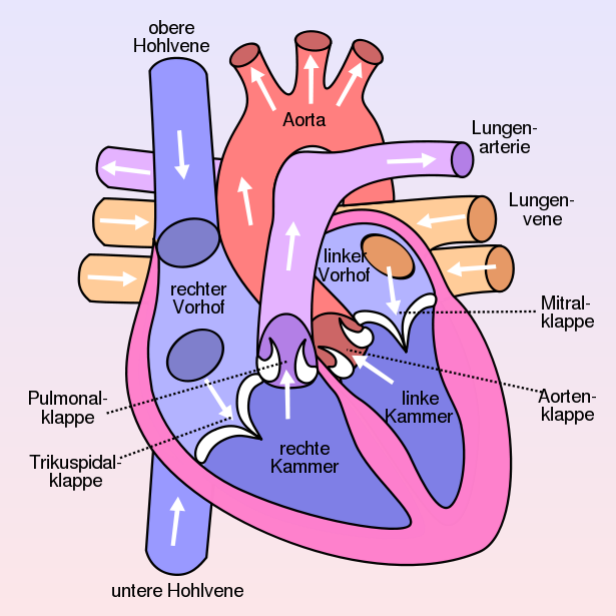
[picture p42: figure]

Noe (TNG) | Patienten unter Strom: Mein erstes EKG | 2012 | 8 / 21

Messtechnik Ableitung von elektrischen Signalen

# Ein- und Auskopplung elektrischer Signale

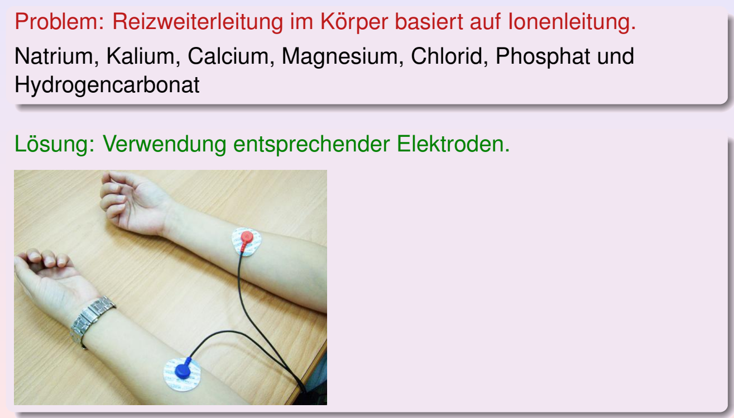
[picture p43: figure]
Hydrogencarbonat

# Problem: Reizweiterleitung im Korper basiert auf Ionenleitung. ¨

# Natrium, Kalium, Calcium, Magnesium, Chlorid, Phosphat und

# Losung: Verwendung entsprechender Elektroden. ¨

Noe (TNG) | Patienten unter Strom: Mein erstes EKG | 2012 | 9 / 21

# Storsignale ¨

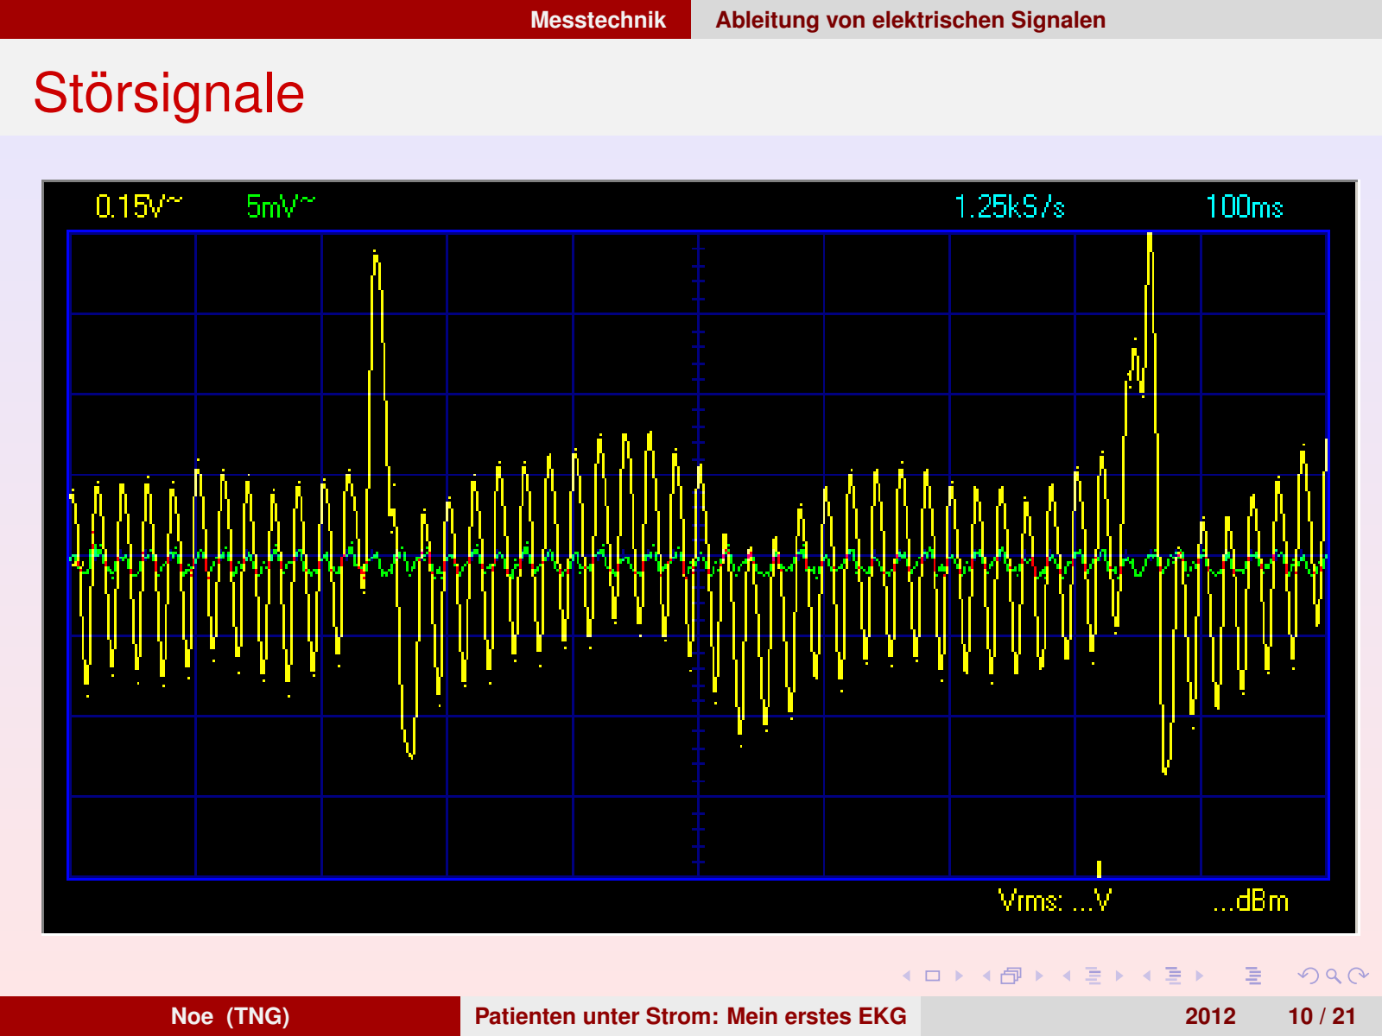
[picture p44: page 10]

Messtechnik | Ableitung von elektrischen Signalen
Noe (TNG) | Patienten unter Strom: Mein erstes EKG | 2012 | 10 / 21

Messtechnik Ableitung von elektrischen Signalen

# Behandlung von Storsignalen ¨

# Vorschlag: Erdung des Patienten

# Durch die Erdung des Patienten wird ein gemeinsames Bezugspotenzial zwischen Patient und Messgerat hergestellt. ¨ Storsignale werden symmetrisch eingekoppelt und verschwinden ¨

somit.

# Problem: Gefahrlich! ¨

Im Falle eines Kurzschlusses konnen hohe Str ¨ | ome durch den ¨

# Patienten fließen. → Potenziell todlich und daher mittlerweile ¨

verboten.

# Fruher jedoch oft angewendet. ¨

Noe (TNG) | Patienten unter Strom: Mein erstes EKG | 2012 | 11 / 21

Messtechnik Ableitung von elektrischen Signalen

# Behandlung von Storsignalen ¨

# Bezugspotentialsteuerung (Driven right leg)

# Das Storsignal wird in der Messchaltung abgeleitet und invertiert an ¨ den Patienten zuruckgegeben. ¨ → Storung und Gegensignal heben sich gegenseitig auf. ¨

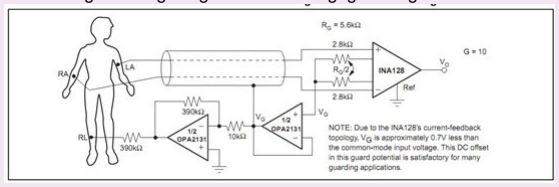
[picture p45: figure]

Noe (TNG) | Patienten unter Strom: Mein erstes EKG | 2012 | 12 / 21

Messtechnik Ableitung von elektrischen Signalen

# Behandlung von Storsignalen ¨

# Ausfiltern des 50Hz Storsignals mit einem Notchfilter ¨

# Mit Hilfe einer Bandsperre mit einer Sperrfrequenz von 50Hz wird das Storsignal ausgefiltert. ¨

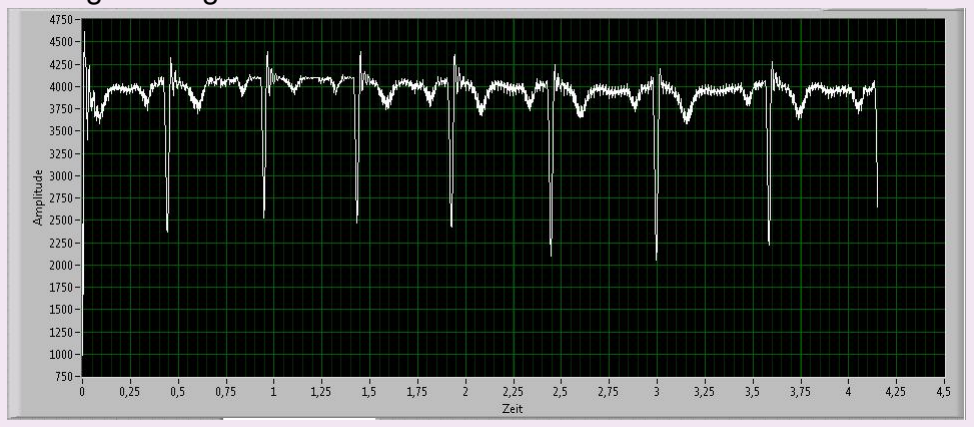
[picture p46: figure]

Noe (TNG) | Patienten unter Strom: Mein erstes EKG | 2012 | 13 / 21

Messtechnik Ableitung von elektrischen Signalen

# Behandlung von Storsignalen ¨

# Hochpaßfilter

# Ausfilterung von Signalen mit einer Frequenz von uber 50Hz. ¨

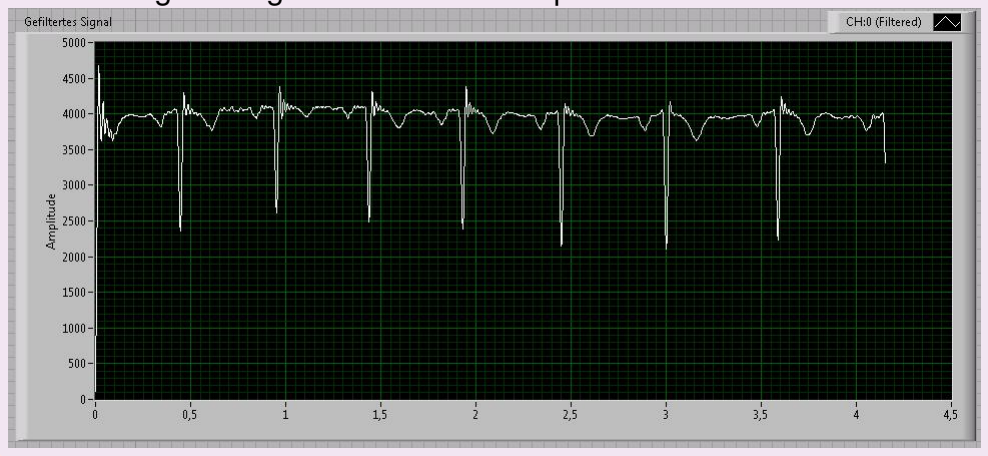
[picture p47: figure]

Noe (TNG) | Patienten unter Strom: Mein erstes EKG | 2012 | 14 / 21

Messtechnik | Das EKG
Noe (TNG) | Patienten unter Strom: Mein erstes EKG | 2012 | 15 / 21

Messtechnik | Pulsoximetrie
Noe (TNG) | Patienten unter Strom: Mein erstes EKG | 2012 | 16 / 21

Messtechnik | Blutdruck
Noe (TNG) | Patienten unter Strom: Mein erstes EKG | 2012 | 17 / 21

Messtechnik | Blutfluss
Noe (TNG) | Patienten unter Strom: Mein erstes EKG | 2012 | 18 / 21

Messtechnik | Herzschritmacher
Noe (TNG) | Patienten unter Strom: Mein erstes EKG | 2012 | 19 / 21

Messtechnik | Defibrillator
Noe (TNG) | Patienten unter Strom: Mein erstes EKG | 2012 | 20 / 21

Messtechnik Fragen

# Fragen?


Noe (TNG) | Patienten unter Strom: Mein erstes EKG | 2012 | 21 / 21
