NeoLeMarc/Diplomarbeit/ausarbeitung/diagramme/Ansteuerung-USB-Stick-crop.pdf

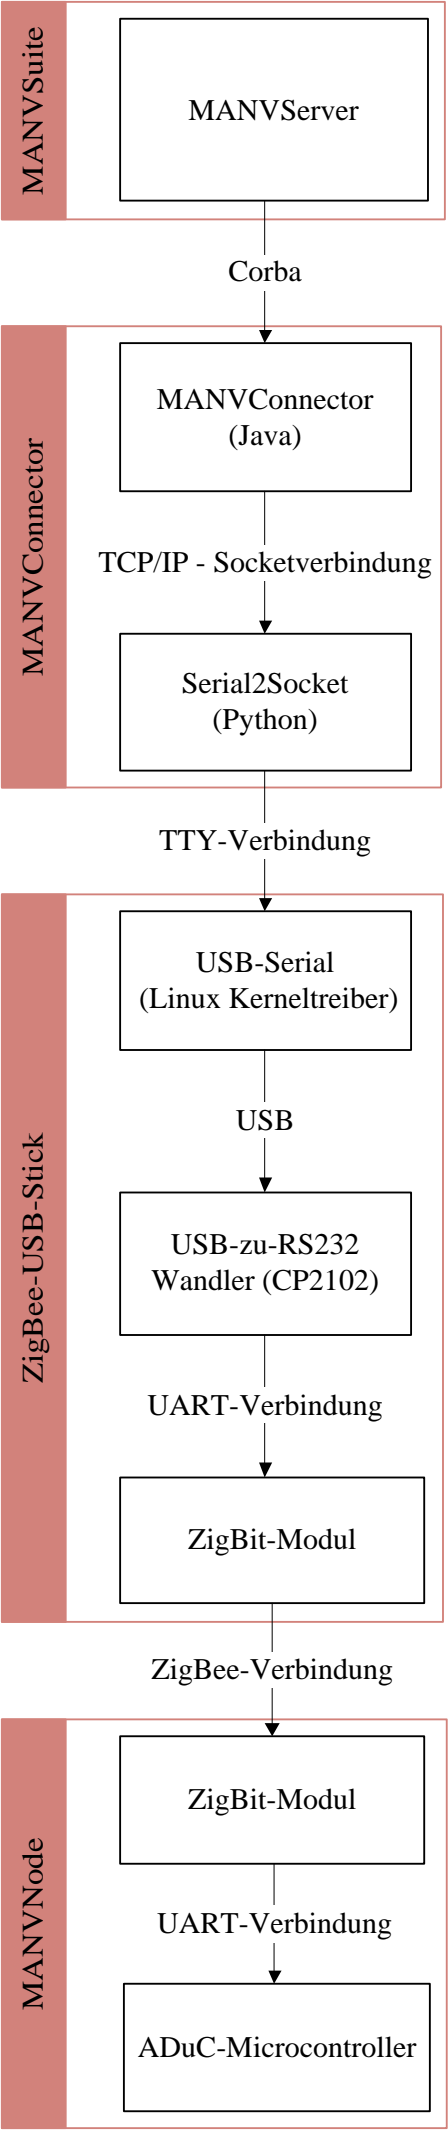
[picture p48: figure]
uite; ctor Zig; B-Stic; MANVConnector (Java); Serial2Socket (Python); TCP/IP - Socketverbindung; USB-Serial (Linux Kerneltreiber); TTY-Verbindung; USB-zu-RS232 Wandler (CP2102); USB; ZigBit-Modul; UART-Verbindung; MANVServer; Corba; ZigBee-Verbindung; ADuC-Microcontroller
