NeoLeMarc/Diplomarbeit/ausarbeitung/diagramme/schaltplan_manvnode_b-crop.pdf

1

2

POWER

JTAG | user interface

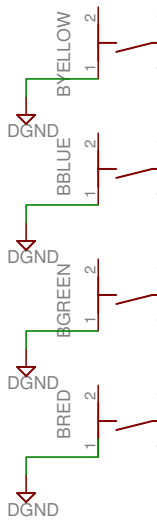
[picture p49: figure]
DGND; BRED; BGREEN; BBLUE; BYELLOW
