NeoLeMarc/Diplomarbeit/ausarbeitung/diagramme/schaltplan_manvnode_interface-crop.pdf

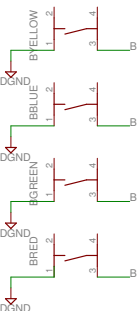
[picture p50: figure]
DGND; BRED; BGREEN; BBLUE; BYELLOW

DGND

BUTTON_RED

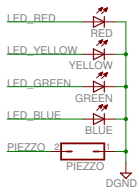
[picture p51: figure]
DGND; BLUE; GREEN; YELLOW; RED; 12 PIEZZO; LED_BLUE; LED_GREEN; LED_RED; LED_YELLOW; PIEZZO

BUTTON_YELLOW

BUTTON_GREEN

BUTTON_BLUE

# user interface
