NeoLeMarc/Diplomarbeit/ausarbeitung/diagramme/schaltplan_manvnode_interface.pdf

DGND

DGND

DGND

DGND

DGND

BLUE

GREEN

YELLOW

RED

21

BRED
3 4

21

BGREEN
3 4

21

BBLUE
3 4

21

BYELLOW
3 4

12
PIEZZO

BUTTON_RED

BUTTON_YELLOW

BUTTON_GREEN

LED_BLUE

LED_GREEN

BUTTON_BLUE

LED_RED

LED_YELLOW

PIEZZO

# user interface
