NeoLeMarc/Diplomarbeit/ausarbeitung/diagramme/schaltplan_manvnode_zigbit.pdf

ZigBit

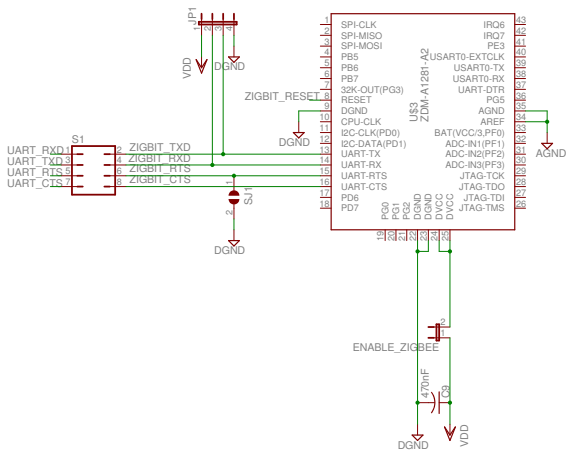
[picture p52: figure]
DGND; VDD; ZDM-A1281-A2; AGND; DGND 22; DGND 23 DVCC 24; DVCC 25; UART-CTS 16; UART-RTS 15; UART-RX 14; UART-TX 13; I2C-DATA(PD1) 12; I2C-CLK(PD0) 11; CPU-CLK 10; DGND 9; RESET 8; 32K-OUT(PG3) 7; SPI-MOSI 3; SPI-MISO 2; SPI-CLK 1; JTAG-TMS; 26 JTAG-TDI; 27 JTAG-TDO; 28 JTAG-TCK; 29 ADC-IN3(PF3); 30 ADC-IN2(PF2); 31 ADC-IN1(PF1); 32 BAT(VCC/3,PF0); 33 AREF; 34 AGND; 36 UART-DTR; 37 USART0-RX; 38 USART0-TX; 39 USART0-EXTCLK; 41 IRQ7; 42 IRQ6; ENABLE_ZIGBEE; ZIGBIT_RXD ZIGBIT_RTS ZIGBIT_CTS; ZIGBIT_TXD; UART_CTS; UART_RTS; UART_RXD UART_TXD; ZIGBIT_RESET
