NeoLeMarc/Diplomarbeit/ausarbeitung/diagramme/serialnet_protokoll.pdf

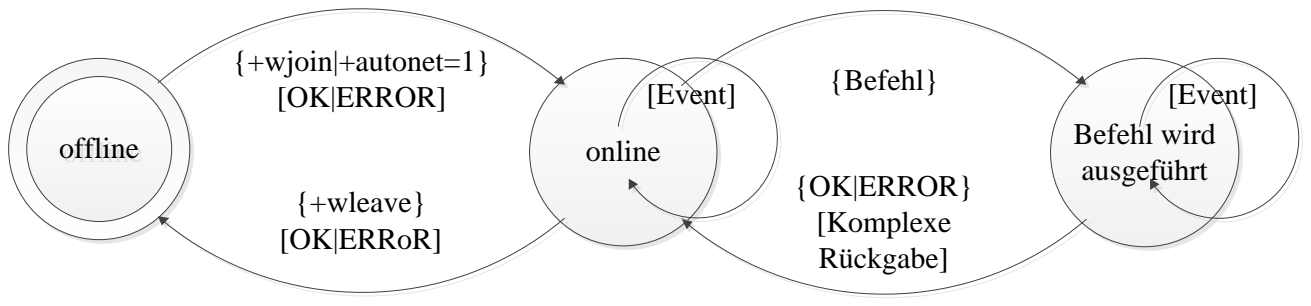
[picture p53: figure]
oofffflliinnee; online; Befehl wird ausgeführt; {+wjoin|+autonet=1}; [OK|ERROR]; {Befehl}; {OK|ERROR} [Komplexe Rückgabe]; {+wleave} [OK|ERRoR]; [Event]

{ } – Befehl
[ ] – Antwort
