NeoLeMarc/Diplomarbeit/vortrag/aal_kongress.pdf

Organisation:

w w w.aal -ko ng ress.de

Wie rechnet sich AAL?

Wegweisende
Anwendungbeispiele

Technische
Forschung
für morgen

## AltersgerechteAssistenzsysteme – Aus der Forschung in den Markt

4. Deutscher AAL-Kongressmit Ausstellung
25.–26. Januar 2011, Berlin
