NeoLeMarc/Diplomarbeit/ausarbeitung/diagramme/spannungsverlauf_client_normal.pdf

t

2

1

5

m

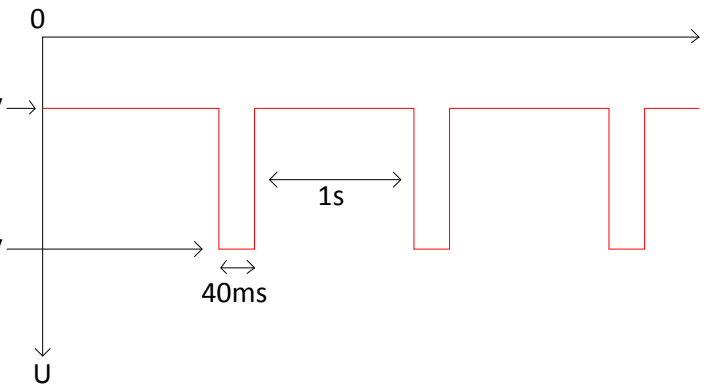
[picture p56: figure]

V

4

7

0

m

V
