NeoLeMarc/Diplomarbeit/platine/adapter/bottom.pdf

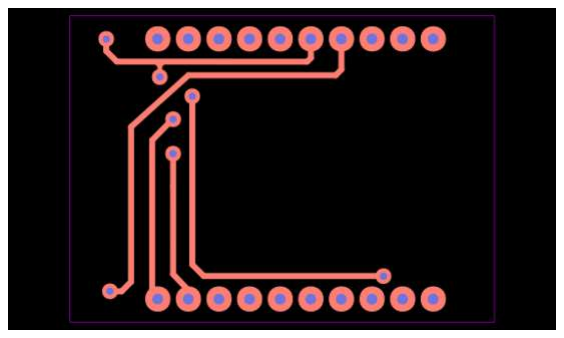
[picture p57: figure]
