NeoLeMarc/Diplomarbeit/platine/adapter/bottom_proper.pdf

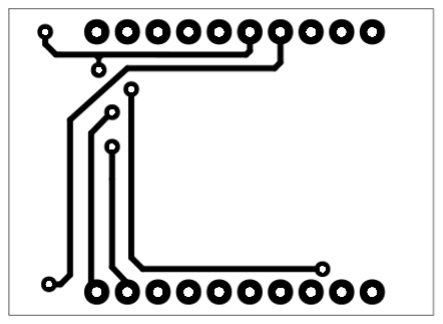
[picture p58: figure]
