NeoLeMarc/Diplomarbeit/platine/adapter/bottom_proper_mirrored.pdf

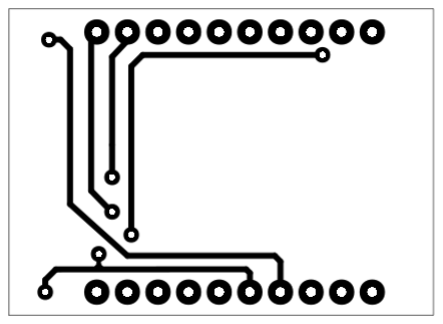
[picture p59: figure]
