NeoLeMarc/Diplomarbeit/platine/adapter/top.pdf

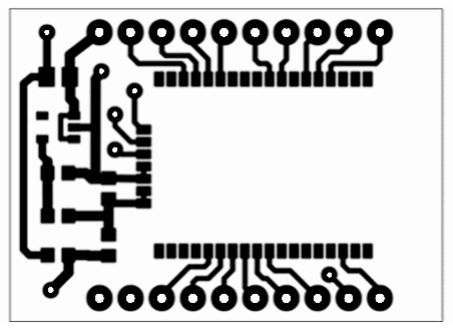
[picture p60: figure]
