NeoLeMarc/Diplomarbeit/platine/adapter/top_proper.pdf

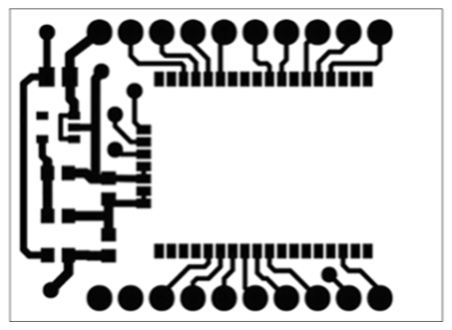
[picture p61: figure]
