NeoLeMarc/Diplomarbeit/platine/adapter/top_proper_mirrored.pdf

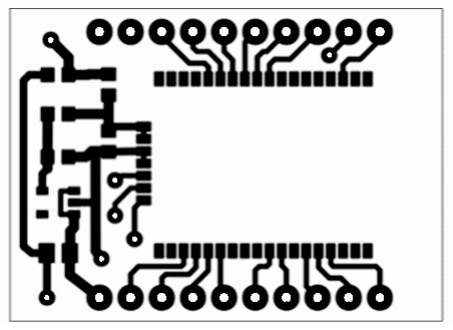
[picture p62: figure]
