NeoLeMarc/Diplomarbeit/vortrag_tng2/images/diplomarbeit/frequenzspreizung_dss-crop.pdf

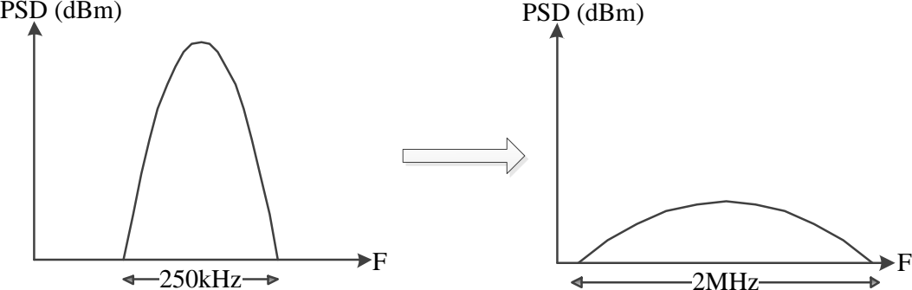
[picture p63: figure]
PSD (dBm); F 250kHz; 2MHz
