NeoLeMarc/Diplomarbeit/vortrag_tng2/images/diplomarbeit/frequenzspreizung_dss.pdf

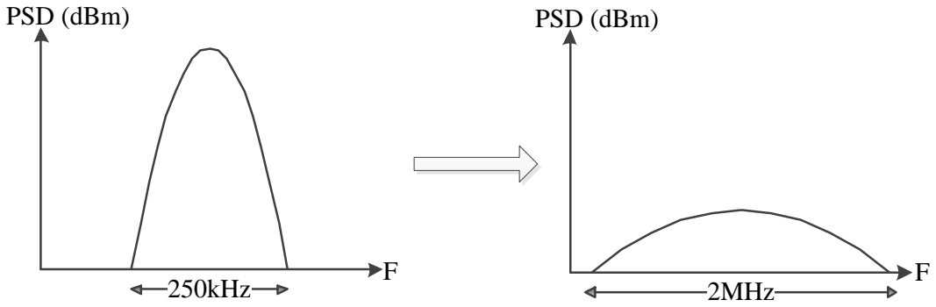
[picture p64: figure]
PSD (dBm); F 250kHz; 2MHz
