NeoLeMarc/Diplomarbeit/vortrag_tng2/images/diplomarbeit/frequenzspreizung_fhss-crop.pdf

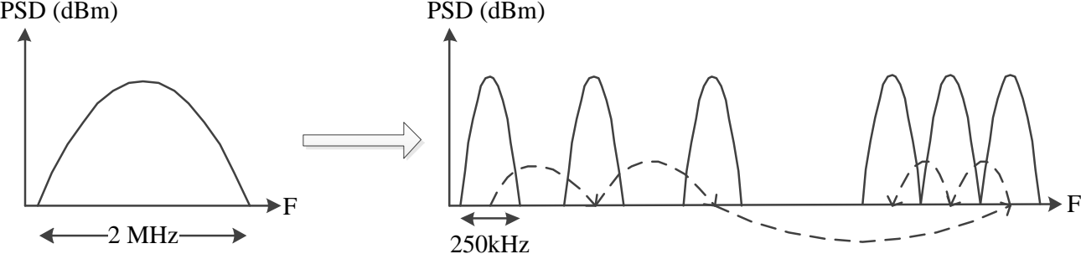
[picture p65: figure]
PSD (dBm); 2 MHz; 250kHz
