NeoLeMarc/Diplomarbeit/vortrag_tng2/images/diplomarbeit/frequenzspreizung_fhss.pdf

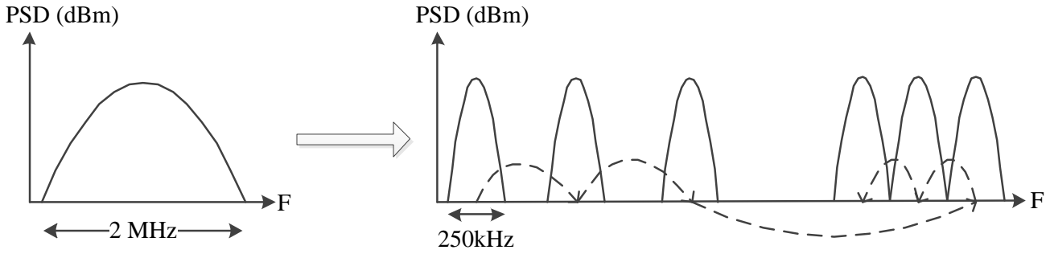
[picture p66: figure]
