NeoLeMarc/Diplomarbeit/ausarbeitung/old_Titel.tex

\begin{picture}(0,0)(85,770)

\end{picture}
\begin{center}
\textsf{\large UNIVERSITÄT KARLSRUHE (TH) - FORSCHUNGSUNIVERSITÄT}\\
			\vspace{0.3cm}
\textsf{\large FAKULTÄT FÜR ELEKTRO- UND INFORMATIONSTECHNIK}\\
			\vspace{0.3cm}
\textsf{\large INSTITUT FÜR BIOMEDIZINISCHE TECHNIK}\\
			\vspace{1.5cm}
\textsf{{\Huge DIPLOMARBEIT\\}}
			\vspace{2cm}
\textsf{\Large Entwurf und Implementierung eines kabellosen Sensornetzes\vspace{0.25cm}\\
        \Large zur "Uberwachung von Patienten bei einem\vspace{0.5cm}\\
        \Large Massenanfall von Verletzten (MANV)}\\
			\vspace{3.0cm}
\begin{table}[ht]
	\begin{tabular}{p{0cm} p{5.1cm} l}
		& \textsf{\large vorgelegt von} 								& \textsf{\large cand. inform. Marcel Noe}\vspace{0.5cm}\\

		& \textsf{\large Betreuer}  & \textsf{\large Prof. Dr. Armin Bolz}\vspace{0.5cm}\\

		& \textsf{\large }			& \textsf{\large Prof. Dr. R"udiger Dillmann}\vspace{0.5cm}\\
		
		& \textsf{\large }			& \textsf{\large Dr.-Ing. Marc J"ager}\vspace{0.5cm}\\
		
		& \textsf{\large Abgabetermin}				& \textsf{\large 01.11.2010}\\
	\end{tabular}	
\end{table}
\end{center}
\thispagestyle{empty}
\clearpage
