NeoLeMarc/Diplomarbeit/ausarbeitung/diagramme/Corbelt.jpg

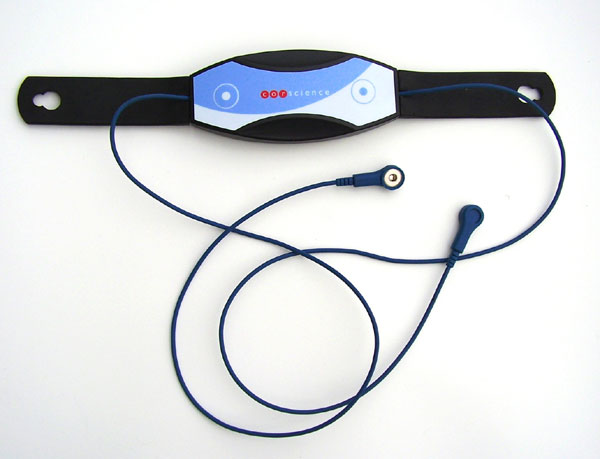
ausarbeitung/diagramme/Corbelt.jpg
