NeoLeMarc/Diplomarbeit/ausarbeitung/diagramme/integrationstest_gui.png

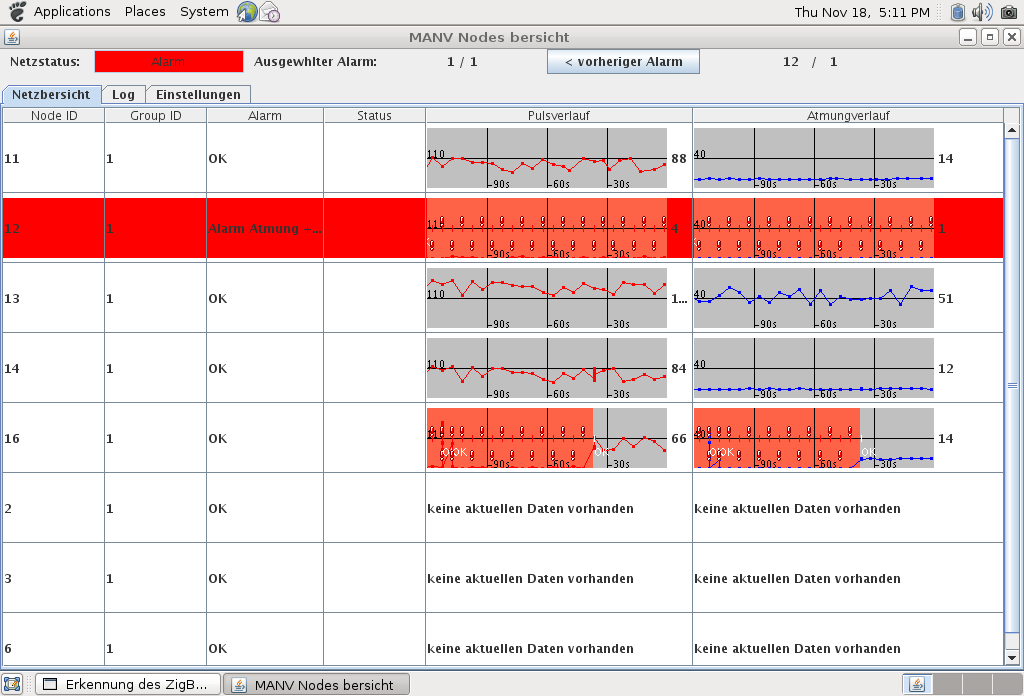
ausarbeitung/diagramme/integrationstest_gui.png
