NeoLeMarc/Diplomarbeit/ausarbeitung/diagramme/kabellose_pulsoximetrie.jpg

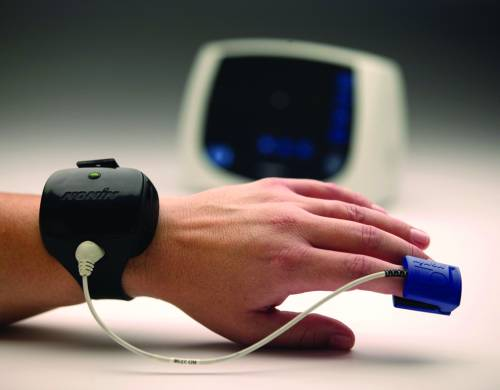
ausarbeitung/diagramme/kabellose_pulsoximetrie.jpg
