NeoLeMarc/Diplomarbeit/ausarbeitung/diagramme/platine_manvnode.png

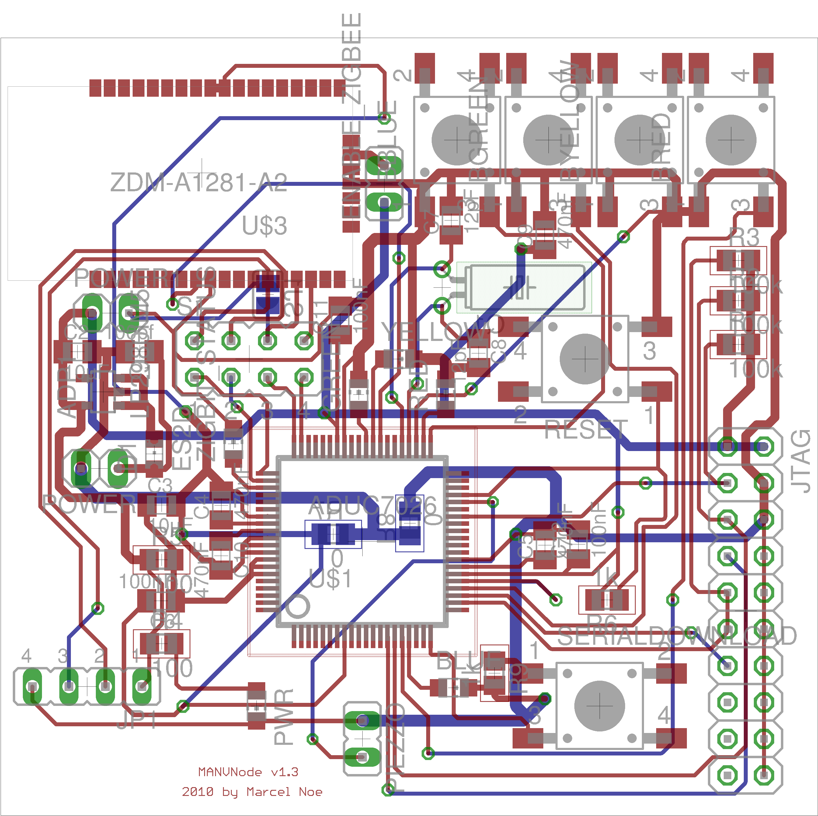
ausarbeitung/diagramme/platine_manvnode.png
