NeoLeMarc/Diplomarbeit/ausarbeitung/diagramme/platine_usbstick.png

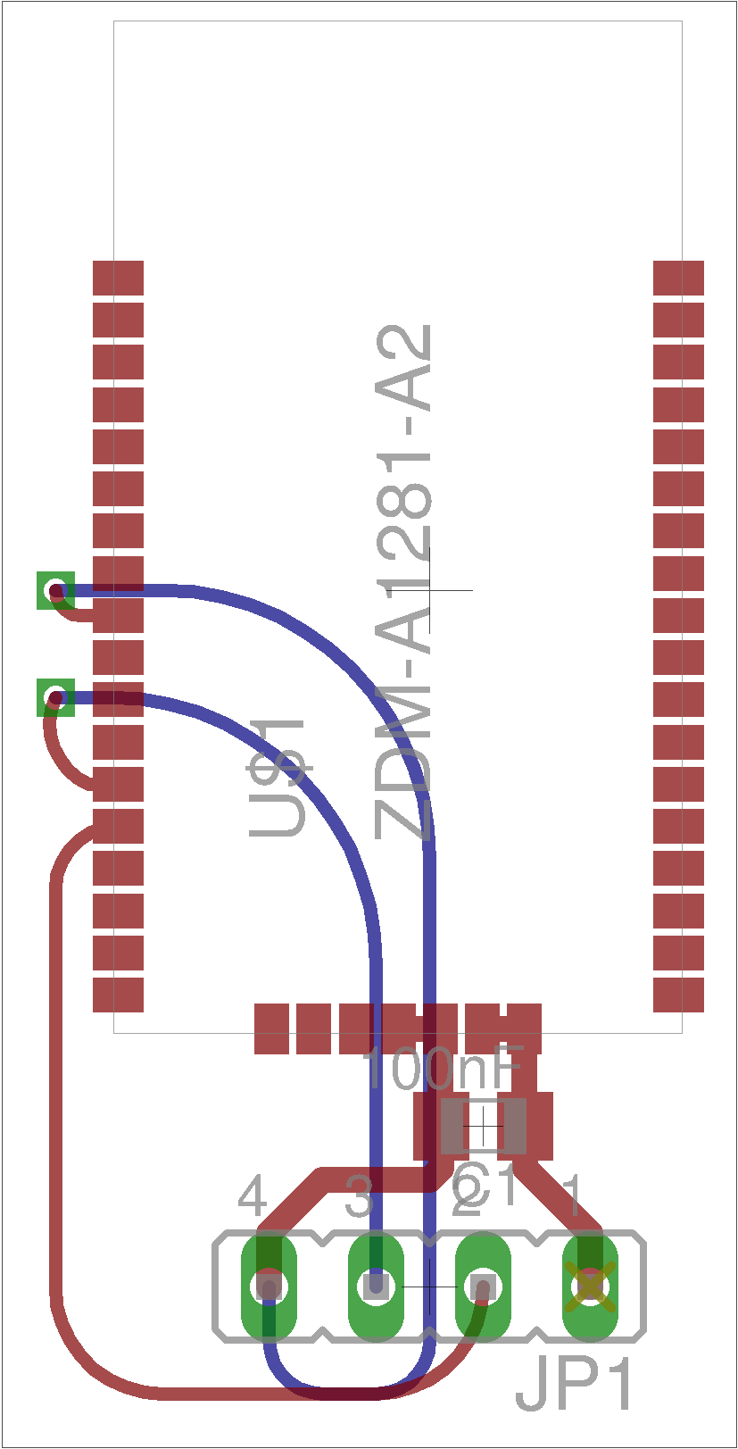
ausarbeitung/diagramme/platine_usbstick.png
