NeoLeMarc/Diplomarbeit/ausarbeitung/diagramme/schaltplan_manvnode.png

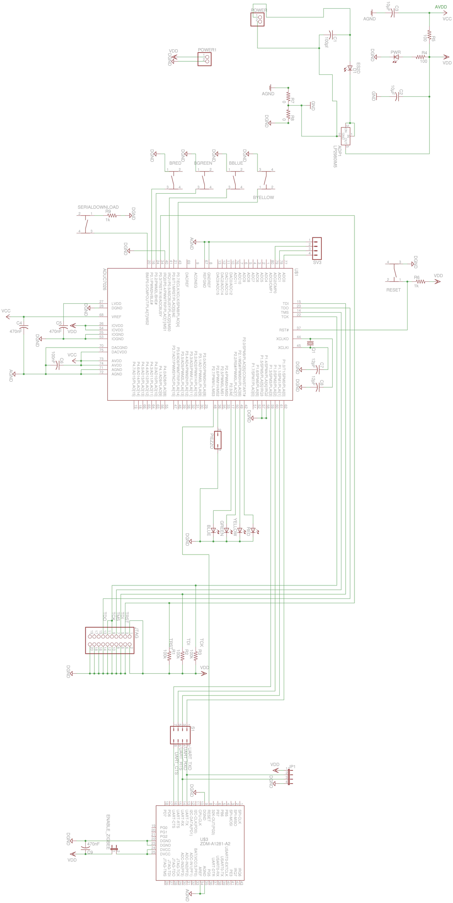
ausarbeitung/diagramme/schaltplan_manvnode.png
