NeoLeMarc/Diplomarbeit/ausarbeitung/diagramme/sogro.jpg

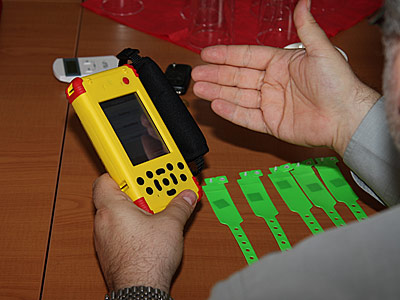
ausarbeitung/diagramme/sogro.jpg
