NeoLeMarc/Diplomarbeit/vortrag_tng2/images/arduino/Arduino_FIO_based_ZigBee_Development_Platform_35D.jpg

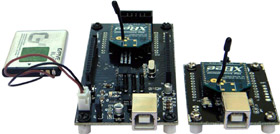
vortrag_tng2/images/arduino/Arduino_FIO_based_ZigBee_Development_Platform_35D.jpg
