NeoLeMarc/Diplomarbeit/vortrag_tng2/images/AuuotCXCIAI6QJh.jpg:large.jpeg

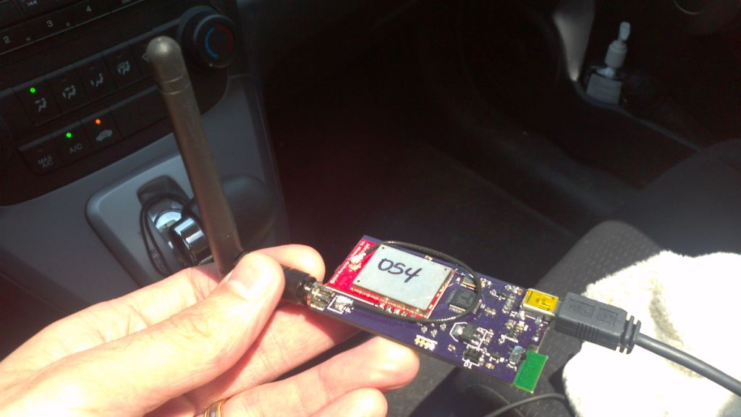
vortrag_tng2/images/AuuotCXCIAI6QJh.jpg:large.jpeg
