NeoLeMarc/Diplomarbeit/vortrag_tng2/images/bluetooth_chip.jpeg

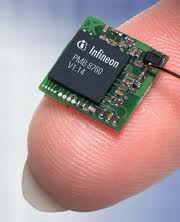
vortrag_tng2/images/bluetooth_chip.jpeg
