NeoLeMarc/Diplomarbeit/vortrag_tng2/images/diplomarbeit/oszi/empfangen_details.jpg

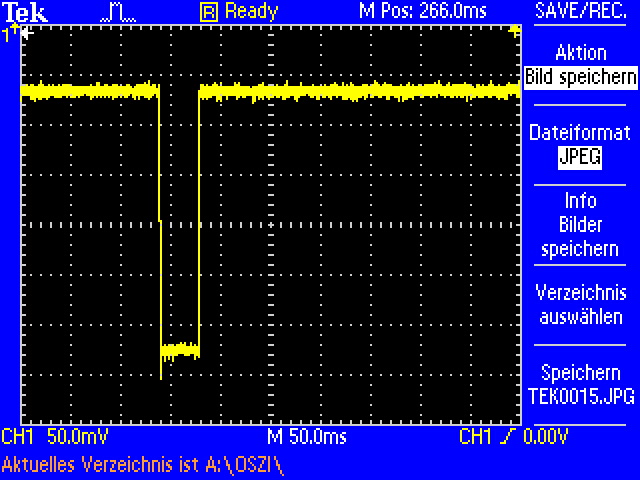
vortrag_tng2/images/diplomarbeit/oszi/empfangen_details.jpg
