NeoLeMarc/Diplomarbeit/vortrag_tng2/images/diplomarbeit/oszi/erwachen2.jpg

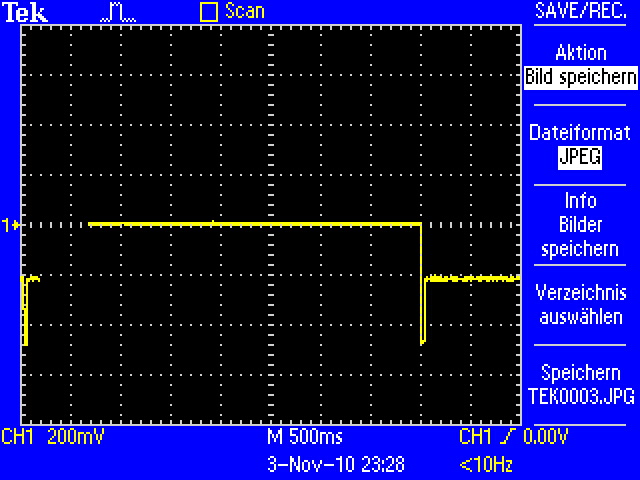
vortrag_tng2/images/diplomarbeit/oszi/erwachen2.jpg
