NeoLeMarc/Diplomarbeit/vortrag_tng2/images/diplomarbeit/oszi/erwachen_1.jpg

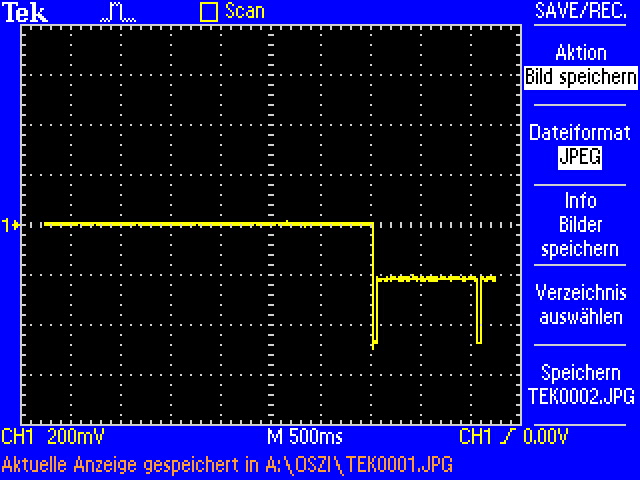
vortrag_tng2/images/diplomarbeit/oszi/erwachen_1.jpg
