NeoLeMarc/Diplomarbeit/vortrag_tng2/images/diplomarbeit/oszi/joined.jpg

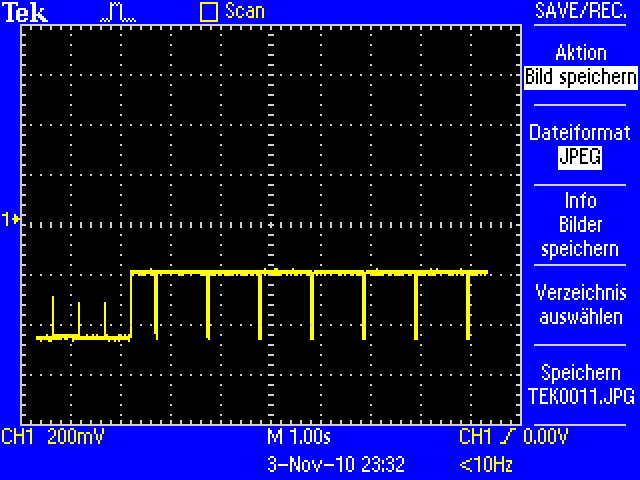
vortrag_tng2/images/diplomarbeit/oszi/joined.jpg
