NeoLeMarc/Diplomarbeit/vortrag_tng2/images/diplomarbeit/oszi/normalbetrieb_client.jpg

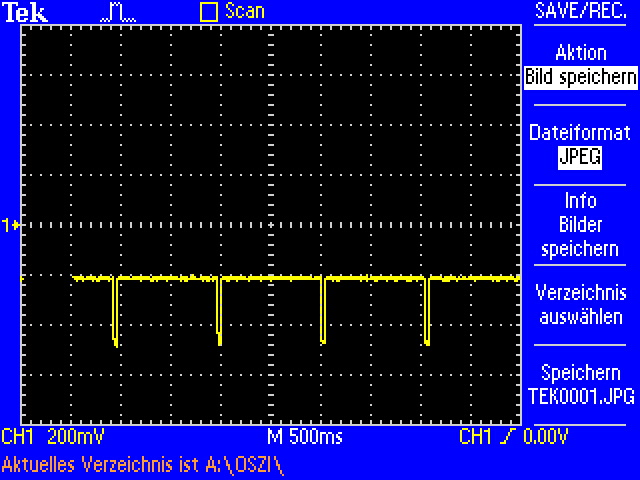
vortrag_tng2/images/diplomarbeit/oszi/normalbetrieb_client.jpg
