NeoLeMarc/Diplomarbeit/vortrag_tng2/images/diplomarbeit/oszi/powersave_periodic.jpg

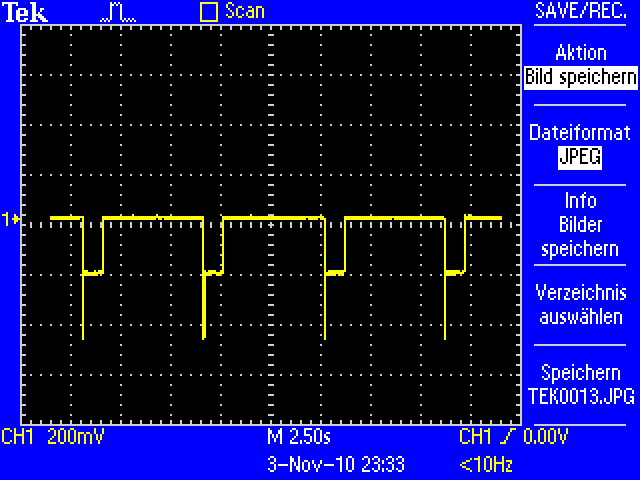
vortrag_tng2/images/diplomarbeit/oszi/powersave_periodic.jpg
