NeoLeMarc/Diplomarbeit/vortrag_tng2/images/diplomarbeit/oszi/TEK0000.JPG

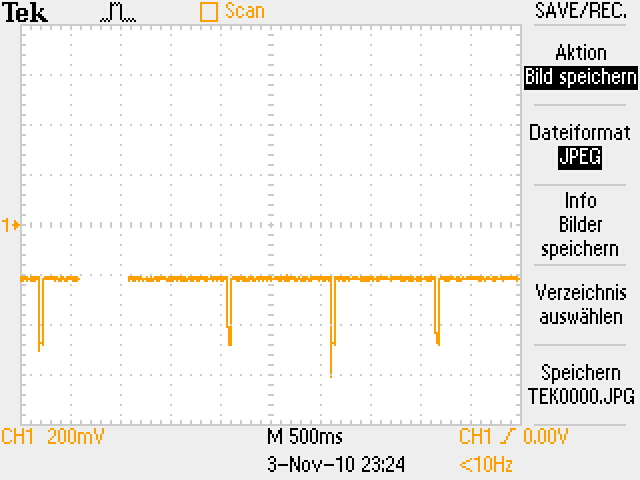
vortrag_tng2/images/diplomarbeit/oszi/TEK0000.JPG
