NeoLeMarc/Diplomarbeit/vortrag_tng2/images/diplomarbeit/oszi/TEK0004.JPG

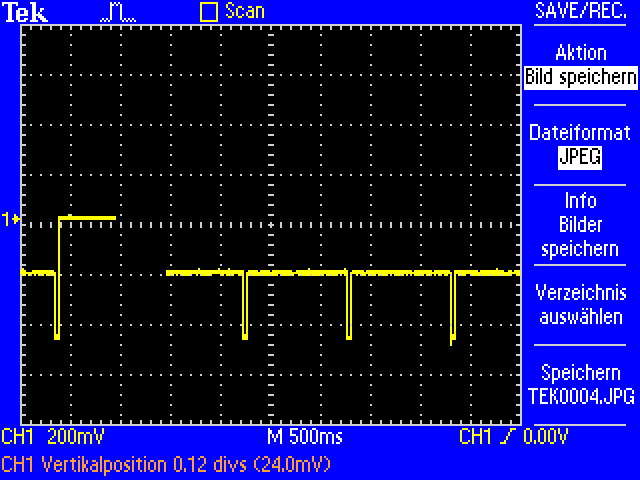
vortrag_tng2/images/diplomarbeit/oszi/TEK0004.JPG
