NeoLeMarc/Diplomarbeit/vortrag_tng2/images/diplomarbeit/oszi/TEK0012.JPG

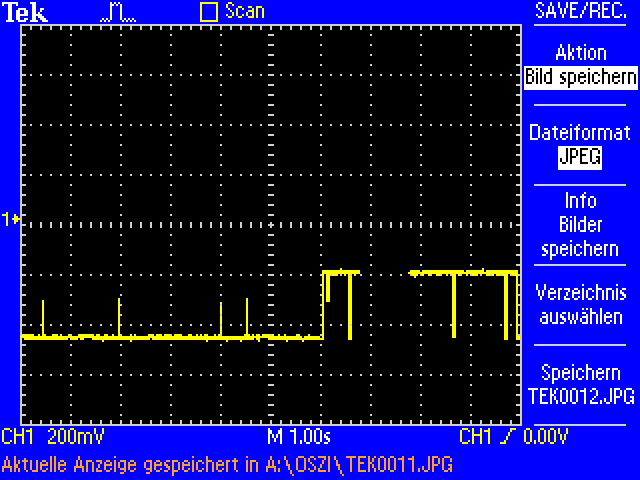
vortrag_tng2/images/diplomarbeit/oszi/TEK0012.JPG
