NeoLeMarc/Diplomarbeit/vortrag_tng2/images/illustrationWSN.jpg

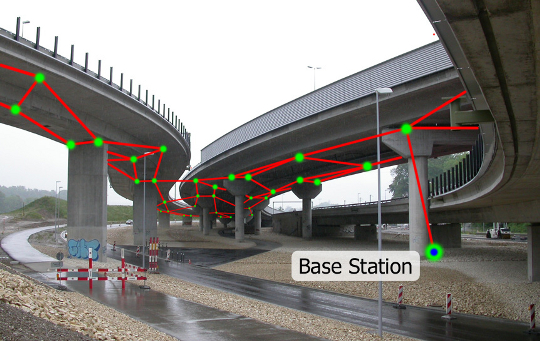
vortrag_tng2/images/illustrationWSN.jpg
