NeoLeMarc/Diplomarbeit/vortrag_tng2/images/ism_congest.gif

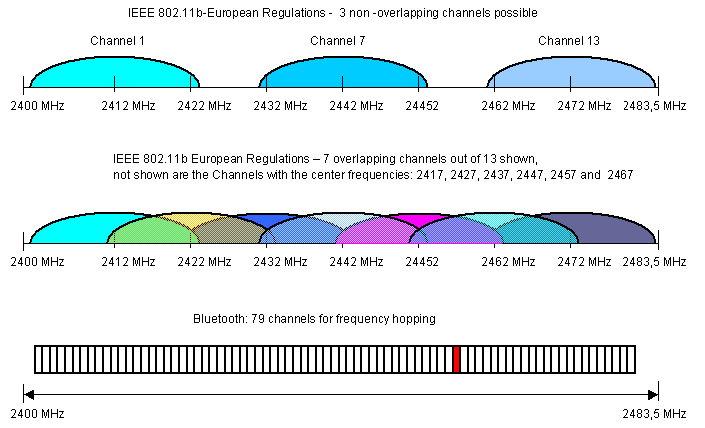
vortrag_tng2/images/ism_congest.gif
