NeoLeMarc/Diplomarbeit/vortrag_tng2/images/libelium/data_cloud.png

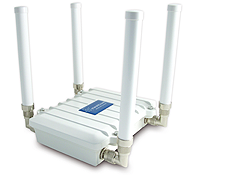
vortrag_tng2/images/libelium/data_cloud.png
