NeoLeMarc/Diplomarbeit/vortrag_tng2/images/libelium/kit_comunicacion_4.png

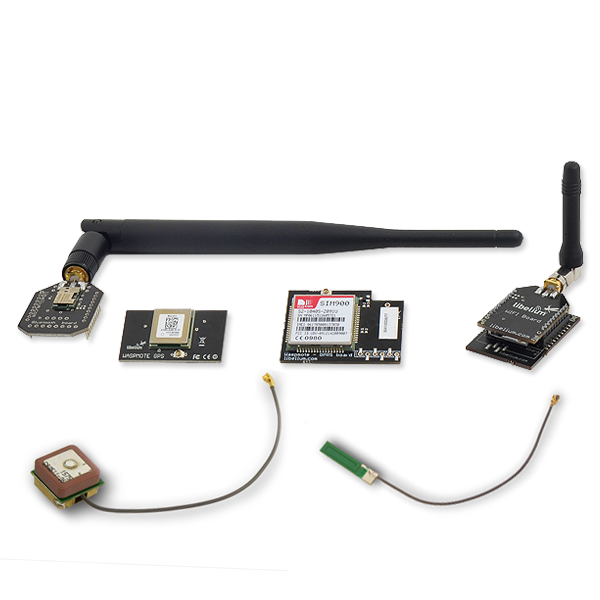
vortrag_tng2/images/libelium/kit_comunicacion_4.png
