NeoLeMarc/Diplomarbeit/vortrag_tng2/images/libelium/meshlium_scanner_zigbee-ap.jpg

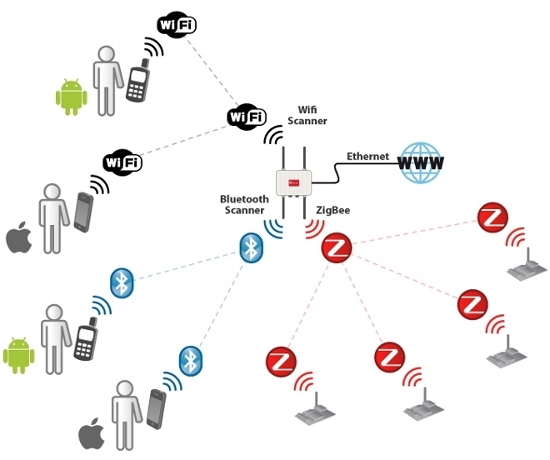
vortrag_tng2/images/libelium/meshlium_scanner_zigbee-ap.jpg
