NeoLeMarc/Diplomarbeit/vortrag_tng2/images/libelium/sensor_probes.png

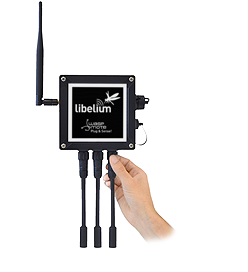
vortrag_tng2/images/libelium/sensor_probes.png
