NeoLeMarc/Diplomarbeit/vortrag_tng2/images/libelium/smart_agriculture.png

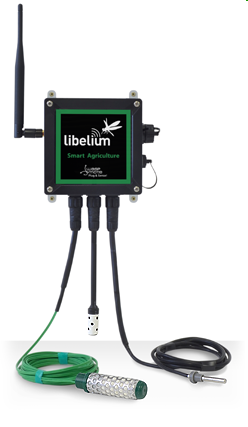
vortrag_tng2/images/libelium/smart_agriculture.png
