NeoLeMarc/Diplomarbeit/vortrag_tng2/images/libelium/solar_powered.png

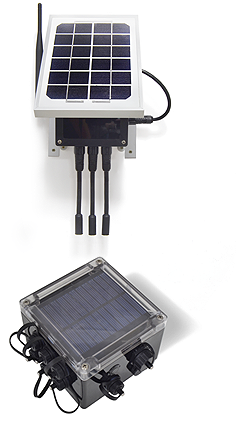
vortrag_tng2/images/libelium/solar_powered.png
