NeoLeMarc/Diplomarbeit/vortrag_tng2/images/libelium_frontend_eng.png

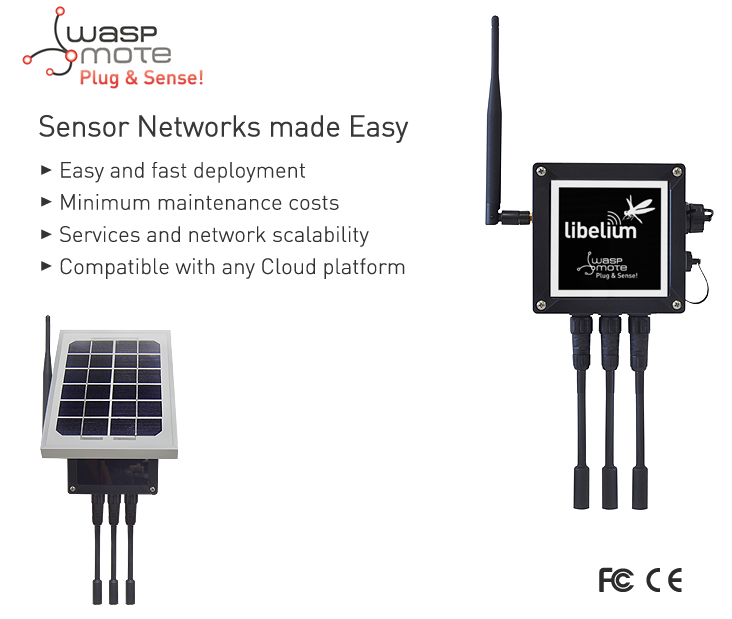
vortrag_tng2/images/libelium_frontend_eng.png
