NeoLeMarc/Diplomarbeit/vortrag_tng2/images/schaltplan_usbstick.png

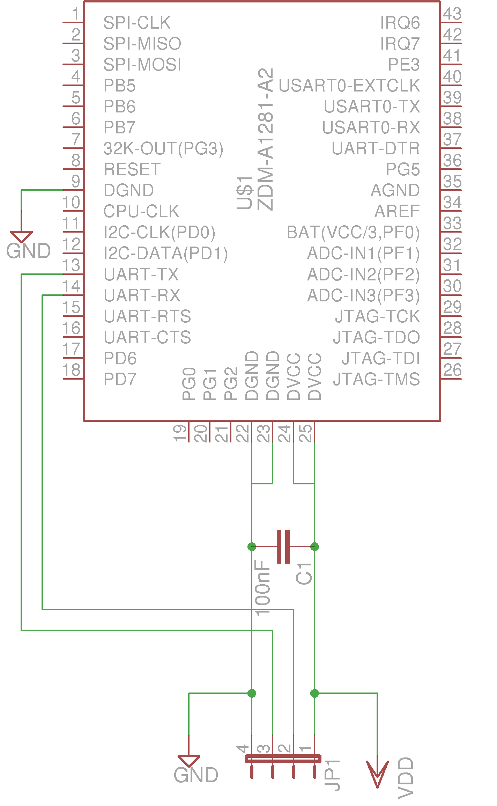
vortrag_tng2/images/schaltplan_usbstick.png
