NeoLeMarc/Diplomarbeit/vortrag_tng2/images/zigbee_development_big1.jpg

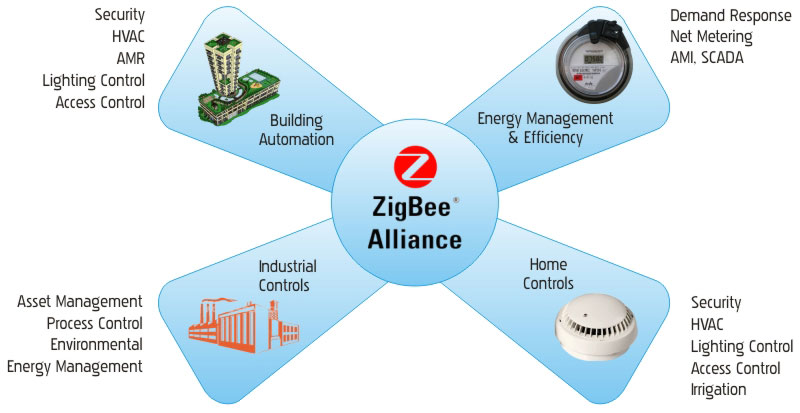
vortrag_tng2/images/zigbee_development_big1.jpg
