NeoLeMarc/Diplomarbeit/vortrag_tng2/images/zigbit_group.jpg

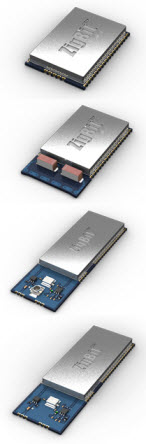
vortrag_tng2/images/zigbit_group.jpg
