NeoLeMarc/Diplomarbeit/ausarbeitung/diagramme/integrationstest_setup.jpg

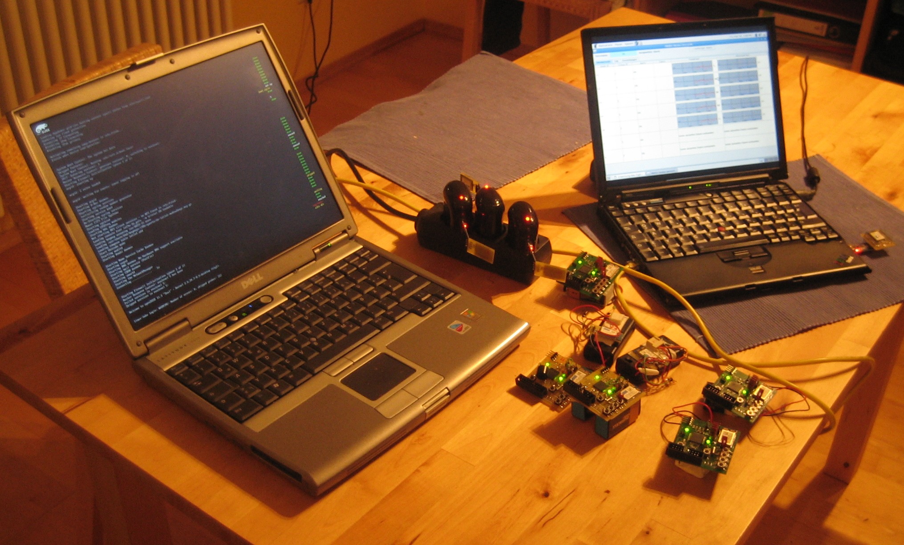
ausarbeitung/diagramme/integrationstest_setup.jpg
