NeoLeMarc/Diplomarbeit/ausarbeitung/diagramme/visio_test.pdf

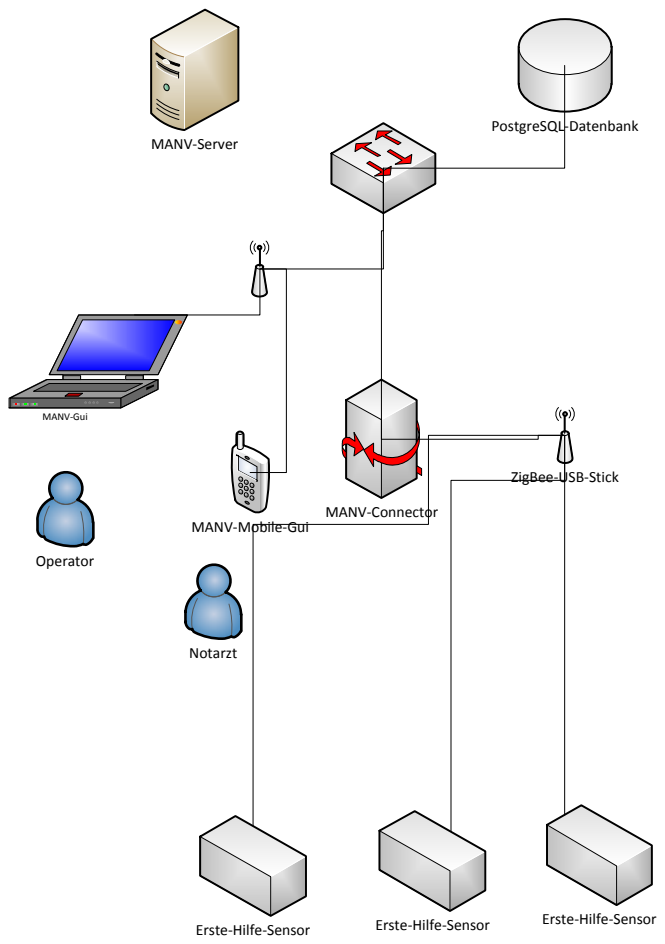
[picture p99: page 1]
PostgreSQL-Datenbank; MANV-Connector; MANV-Gui; MANV-Server; Erste-Hilfe-Sensor; Operator; Notarzt

ZigBee-USB-Stick

MANV-Mobile-Gui
