NeoLeMarc/Diplomarbeit/vortrag/vortrag.pdf

## Entwurf und Implementierung eines kabellosen

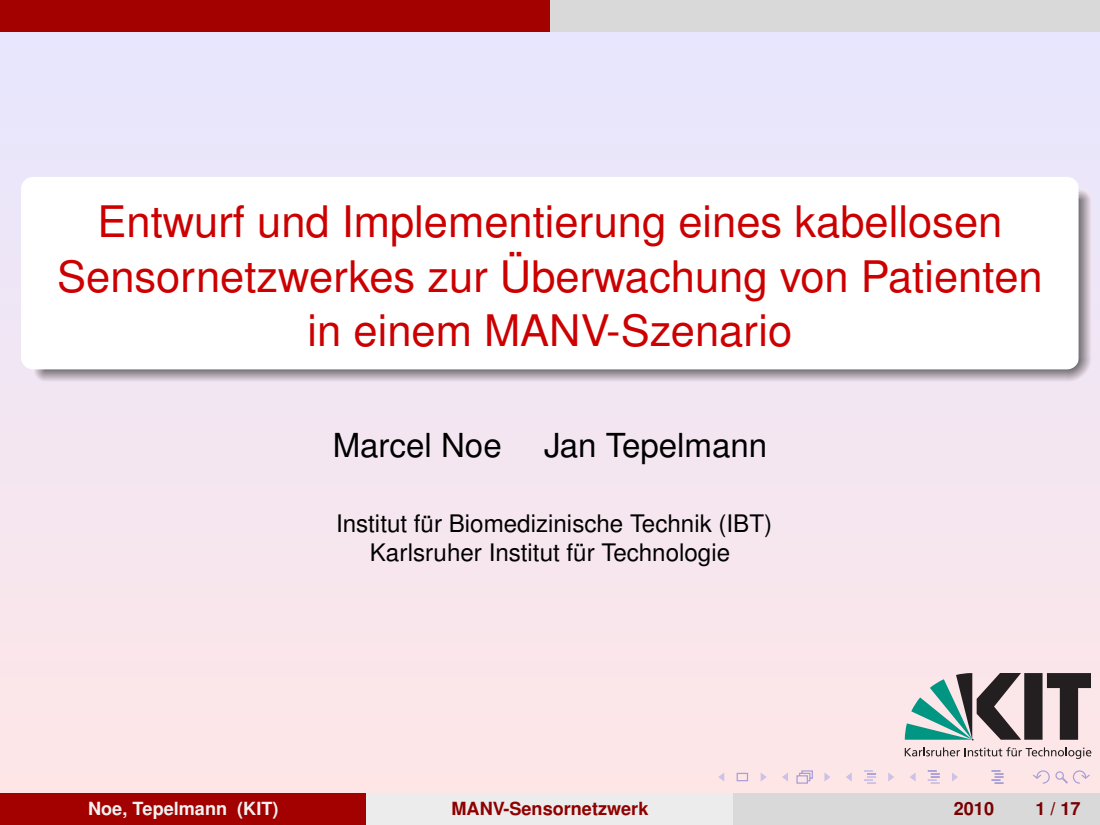
[picture p100: page 1]
Marcel Noe; Jan Tepelmann; Noe, Tepelmann (KIT); MANV-Sensornetzwerk

Sensornetzwerkes zur Uberwachung von Patienten ¨

in einem MANV-Szenario

Institut fur Biomedizinische Technik (IBT) ¨
Karlsruher Institut fur Technologie ¨

## Uberblick ¨

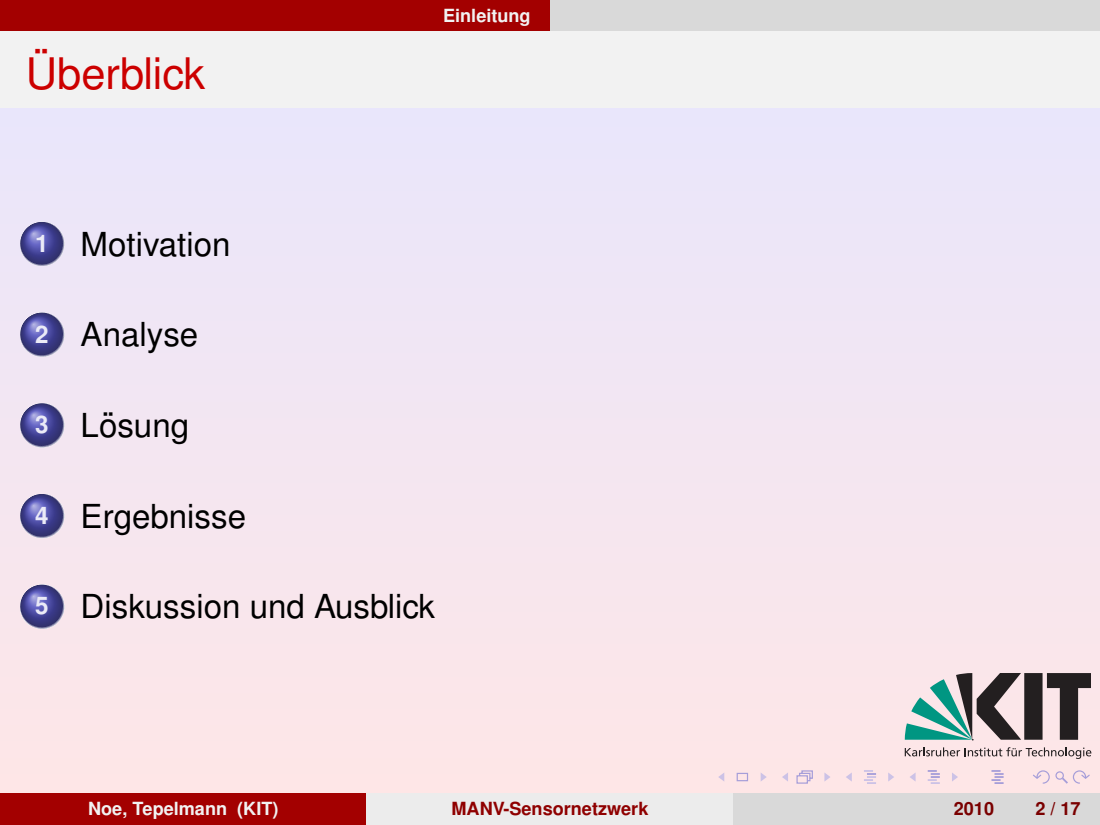
[picture p101: page 2]
Einleitung; 1 Motivation; 2 Analyse; 3 Losung ¨; 4 Ergebnisse; Noe, Tepelmann (KIT); MANV-Sensornetzwerk

5 Diskussion und Ausblick

Motivation Massenanfall von Verletzten

## Motivation: Massenanfall von Verletzten


Ereigniss mit einer großen Anzahl von Verletzten
z.B. Verkehrsungluck, Brand, ¨ Naturkatastrophe oder Krankheit Teilweise Zusammenbruch (lokaler) Infrastruktur
Knappe Ressourcen (Hilfsmittel, Helfer, Medikamente,
Transportkapazitat) ¨
Hohe Belastung fur Helfer ¨

Motivation Triage

## Motivation: Triage

Triage: Einteilung von Patienten in Gruppen nach Behandlungsdringlichkeit. Grund: Beschrankte Ressourcen: ¨ Transportmittel, Medikamente, Helfer Einfachste Hilfsmittel: ”Sehen, horen, ¨
fuhlen”, Anh ¨ | angek ¨ | artchen, etc. ¨
Aber: Werden alle Patienten korrekt zugeordnet? Was passiert bei Verschlechterung des Zustands nach Triage?
Fehlerquellen: Zeitdruck, zu wenig
Personal, Psychische Belastung der Helfer


=⇒ Technische Hilfsmittel konnen Fehler verringern. ¨

## Stand der Technik: Hilfsmittel fur MANV-Einsatz ¨

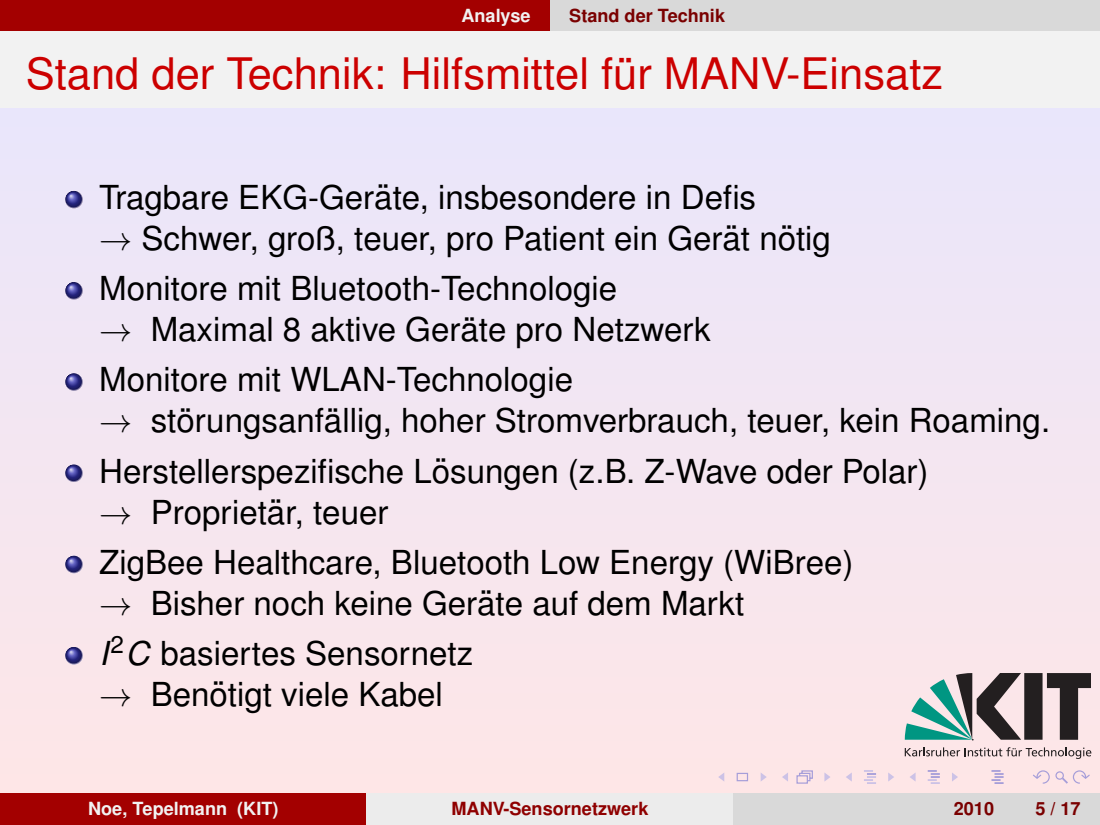
[picture p102: page 5]
Analyse; Stand der Technik; → Schwer, groß, teuer, pro Patient ein Gerat n ¨; otig ¨; → storungsanf ¨; allig, hoher Stromverbrauch, teuer, kein Roaming. ¨; Noe, Tepelmann (KIT); MANV-Sensornetzwerk

Tragbare EKG-Gerate, insbesondere in Defis ¨
Monitore mit Bluetooth-Technologie
→ Maximal 8 aktive Gerate pro Netzwerk ¨
Monitore mit WLAN-Technologie
Herstellerspezifische Losungen (z.B. Z-Wave oder Polar) ¨
→ Proprietar, teuer ¨
ZigBee Healthcare, Bluetooth Low Energy (WiBree)
→ Bisher noch keine Gerate auf dem Markt ¨
2C basiertes Sensornetz
→ Benotigt viele Kabel ¨

## Anforderungen

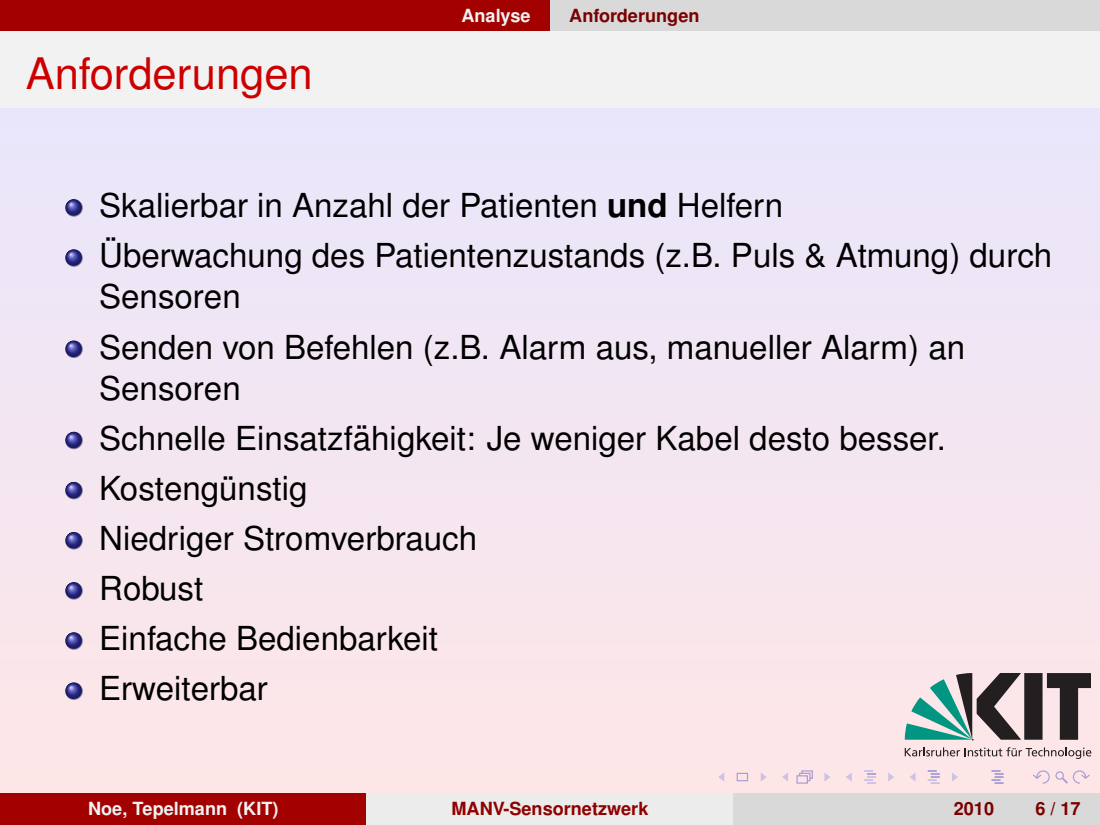
[picture p103: page 6]
Analyse; Anforderungen; Noe, Tepelmann (KIT); MANV-Sensornetzwerk

Skalierbar in Anzahl der Patienten und Helfern
Uberwachung des Patientenzustands (z.B. Puls & Atmung) durch ¨
Sensoren
Senden von Befehlen (z.B. Alarm aus, manueller Alarm) an
Schnelle Einsatzfahigkeit: Je weniger Kabel desto besser. ¨
Kostengunstig ¨
Niedriger Stromverbrauch
Robust
Einfache Bedienbarkeit
Erweiterbar

## Funknetzwerk: ZigBee

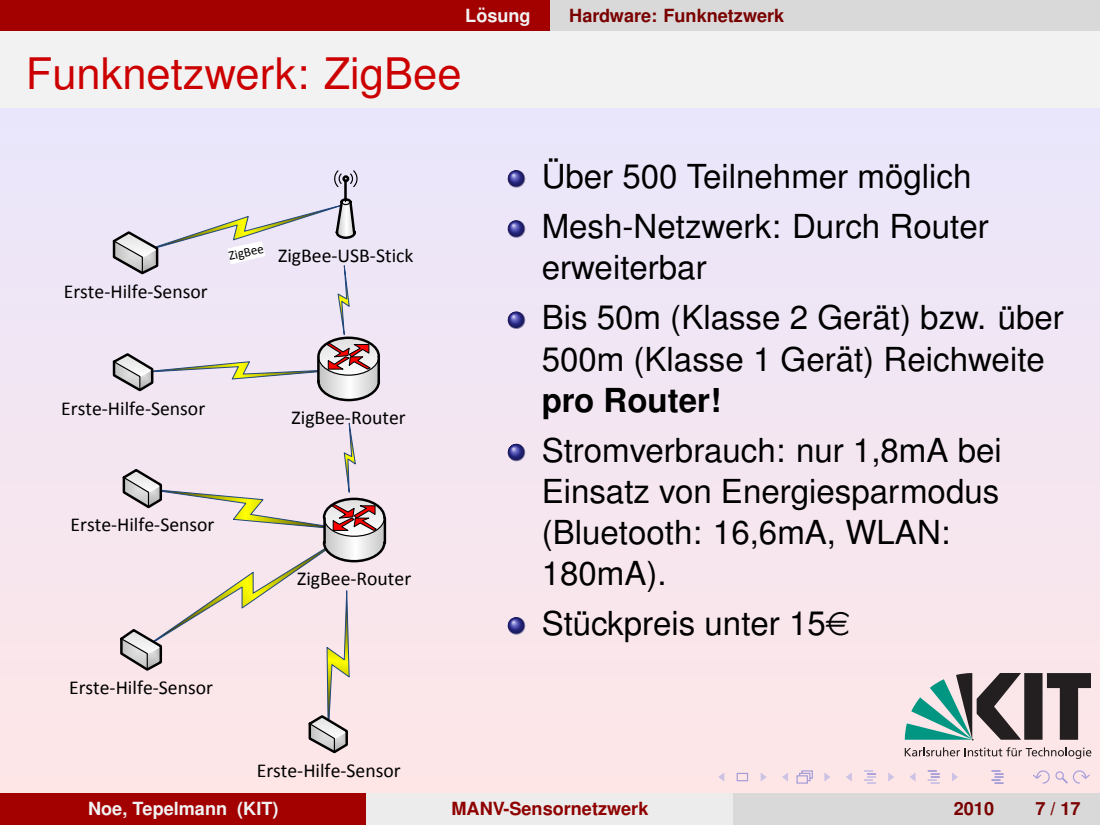
[picture p104: page 7]
Losung ¨; Hardware: Funknetzwerk; ZigBee-Router; Uber 500 Teilnehmer m ¨; oglich ¨; Bis 50m (Klasse 2 Gerat) bzw. ¨; uber ¨; Stuckpreis unter 15 ¨; Noe, Tepelmann (KIT); MANV-Sensornetzwerk

Mesh-Netzwerk: Durch Router
erweiterbar
500m (Klasse 1 Gerat) Reichweite ¨
pro Router!
Stromverbrauch: nur 1,8mA bei
Einsatz von Energiesparmodus
(Bluetooth: 16,6mA, WLAN:

ZigBee
ZigBee-USB-Stick

Erste-Hilfe-Sensor

Losung ¨ | Hardware: MANVNode

## Hardware: MANVNode


Entwicklungsplatine zum Entwerfen und Testen von Firmware
JTAG-Schnittstelle fur Debugging ¨ ADuC-Mikroprozessor (vgl.
Erste-Hilfe-Sensor)
Testpunkte fur Strommessung ¨ Programmierbare Taster und LEDs Piezzo-Summer
Batterie- und Netzteilbetrieb (3V-16V)

## Software: Logische Sicht

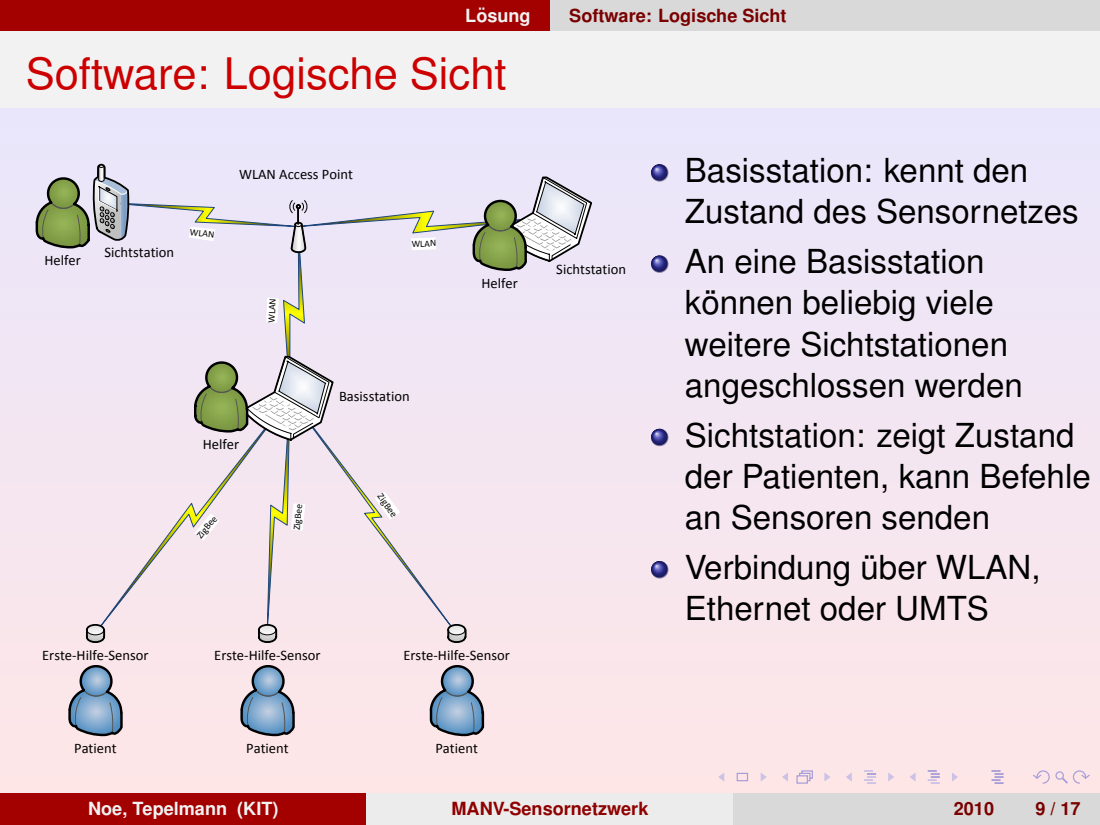
[picture p105: page 9]
Losung ¨; Software: Logische Sicht; WLAN ZigBee; ZigBee; WLAN; Patient; Basisstation; Helfer; Sichtstation; Noe, Tepelmann (KIT); MANV-Sensornetzwerk

WLAN Access Point

Basisstation: kennt den
Zustand des Sensornetzes
An eine Basisstation
konnen beliebig viele ¨
weitere Sichtstationen
angeschlossen werden
Sichtstation: zeigt Zustand
der Patienten, kann Befehle
an Sensoren senden
Verbindung uber WLAN, ¨
Ethernet oder UMTS

Erste-Hilfe-Sensor

## Software: Technische Sicht

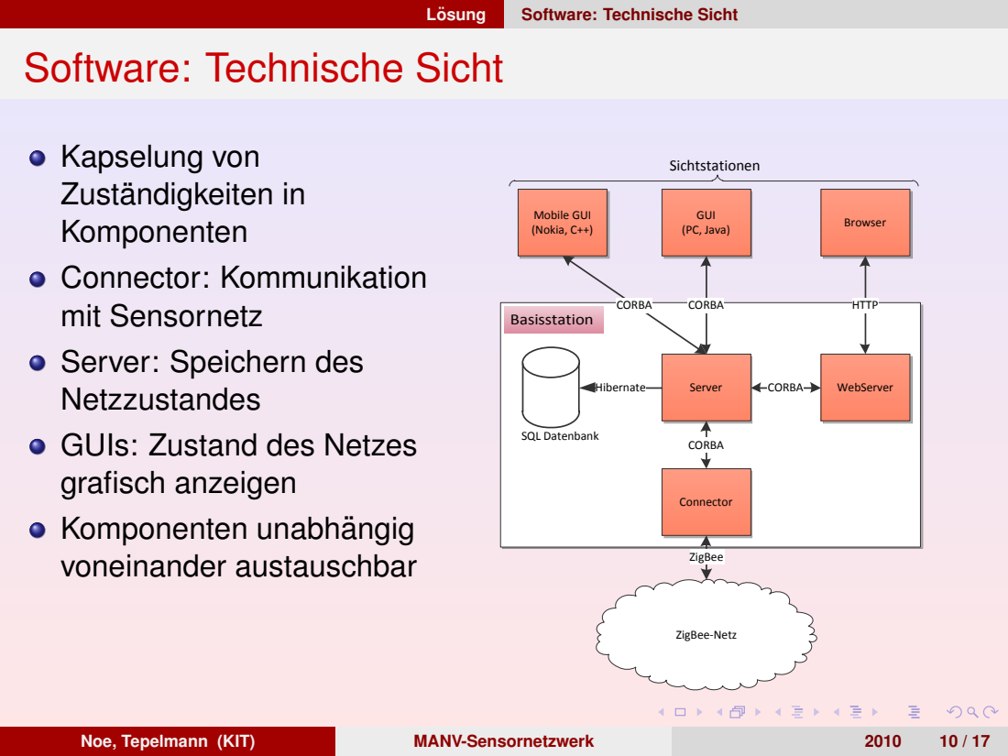
[picture p106: page 10]
Losung ¨; Software: Technische Sicht; Basisstation; Connector; Server; GUI (PC, Java); WebServer; Mobile GUI (Nokia, C++); SQL Datenbank; Browser CORBA; CORBA; HTTP; Hibernate; ZigBee-Netz; ZigBee; Sichtstationen; Noe, Tepelmann (KIT); MANV-Sensornetzwerk

Kapselung von
Zustandigkeiten in ¨
Komponenten
Connector: Kommunikation
mit Sensornetz
Server: Speichern des
Netzzustandes
GUIs: Zustand des Netzes
grafisch anzeigen
Komponenten unabhangig ¨
voneinander austauschbar

Losung ¨ | Software: Zusammenfassung

## Software: Zusammenfassung

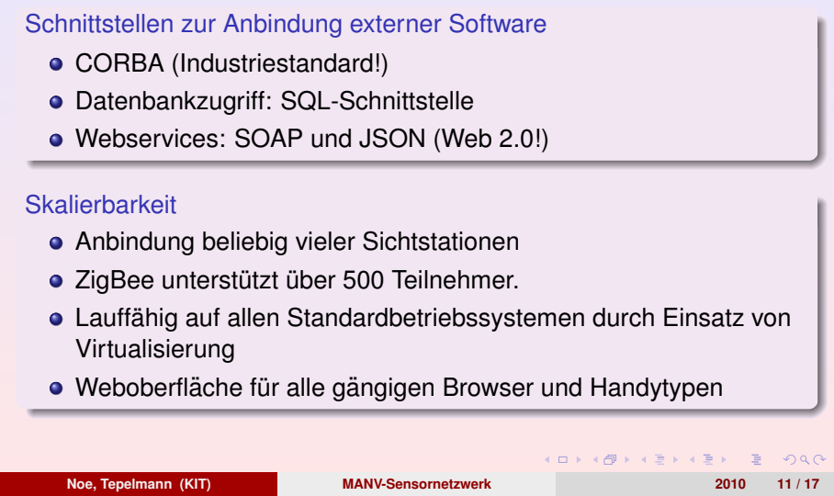
[picture p107: figure]
Schnittstellen zur Anbindung externer Software; CORBA (Industriestandard!); Datenbankzugriff: SQL-Schnittstelle; Webservices: SOAP und JSON (Web 2.0!); Skalierbarkeit; Anbindung beliebig vieler Sichtstationen; ZigBee unterstutzt ¨; uber 500 Teilnehmer. ¨; Virtualisierung; Weboberflache f ¨; ur alle g ¨; angigen Browser und Handytypen ¨; Noe, Tepelmann (KIT); MANV-Sensornetzwerk

Lauffahig auf allen Standardbetriebssystemen durch Einsatz von ¨

## Praktische Vorfuhrung ¨

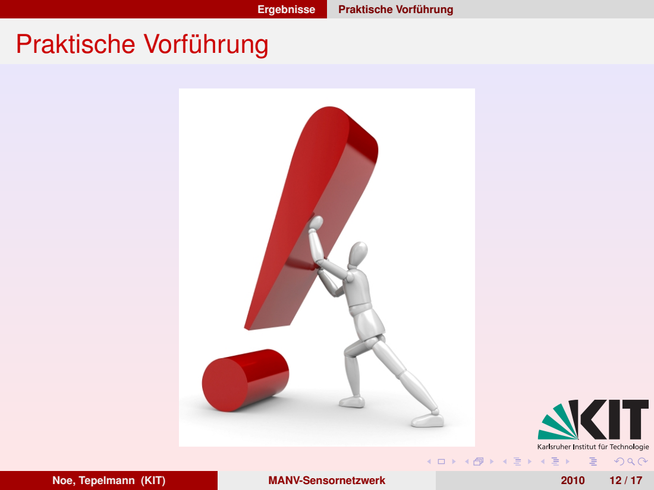
[picture p108: page 12]
Ergebnisse; Praktische Vorf ¨uhrung; Noe, Tepelmann (KIT); MANV-Sensornetzwerk

## Ergebnisse auf einen Blick

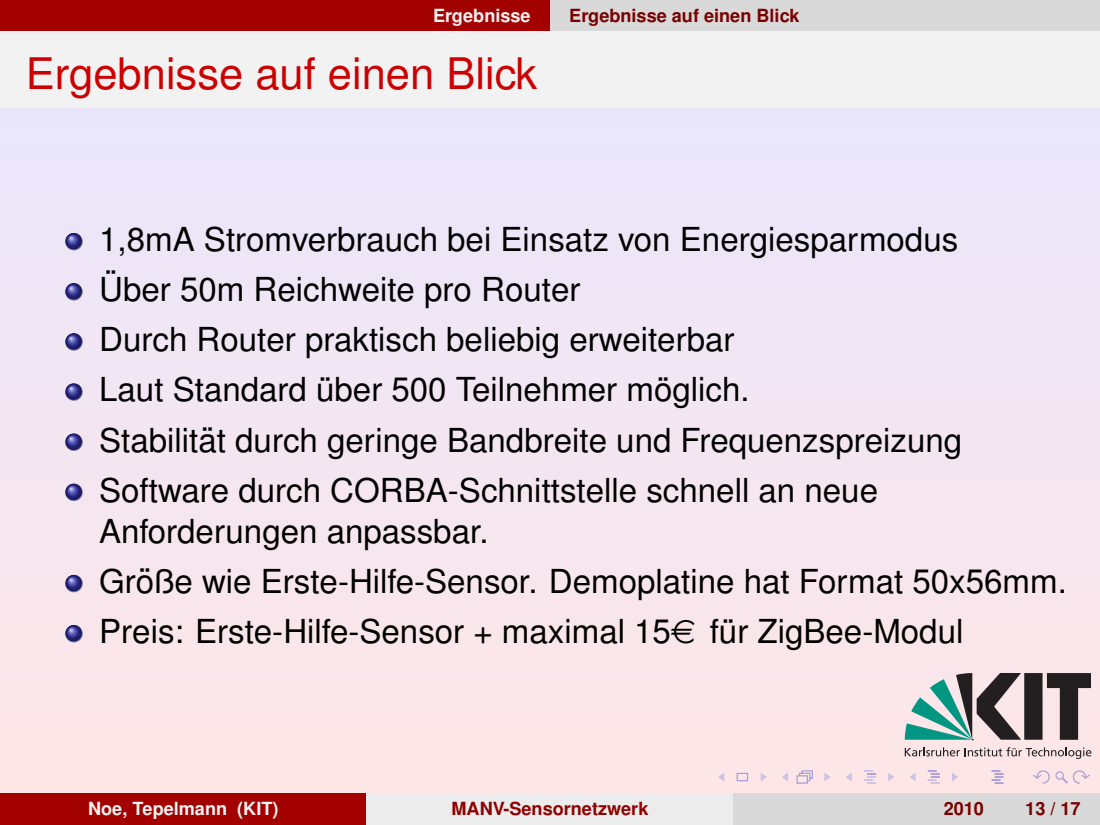
[picture p109: page 13]
Ergebnisse; Ergebnisse auf einen Blick; Laut Standard uber 500 Teilnehmer m ¨; oglich. ¨; Noe, Tepelmann (KIT); MANV-Sensornetzwerk

1,8mA Stromverbrauch bei Einsatz von Energiesparmodus
Uber 50m Reichweite pro Router ¨
Durch Router praktisch beliebig erweiterbar
Stabilitat durch geringe Bandbreite und Frequenzspreizung ¨
Software durch CORBA-Schnittstelle schnell an neue
Anforderungen anpassbar.
Große wie Erste-Hilfe-Sensor. Demoplatine hat Format 50x56mm. ¨
Preis: Erste-Hilfe-Sensor + maximal 15e fur ZigBee-Modul ¨

## Verbesserungen gegenuber dem Stand der Technik ¨

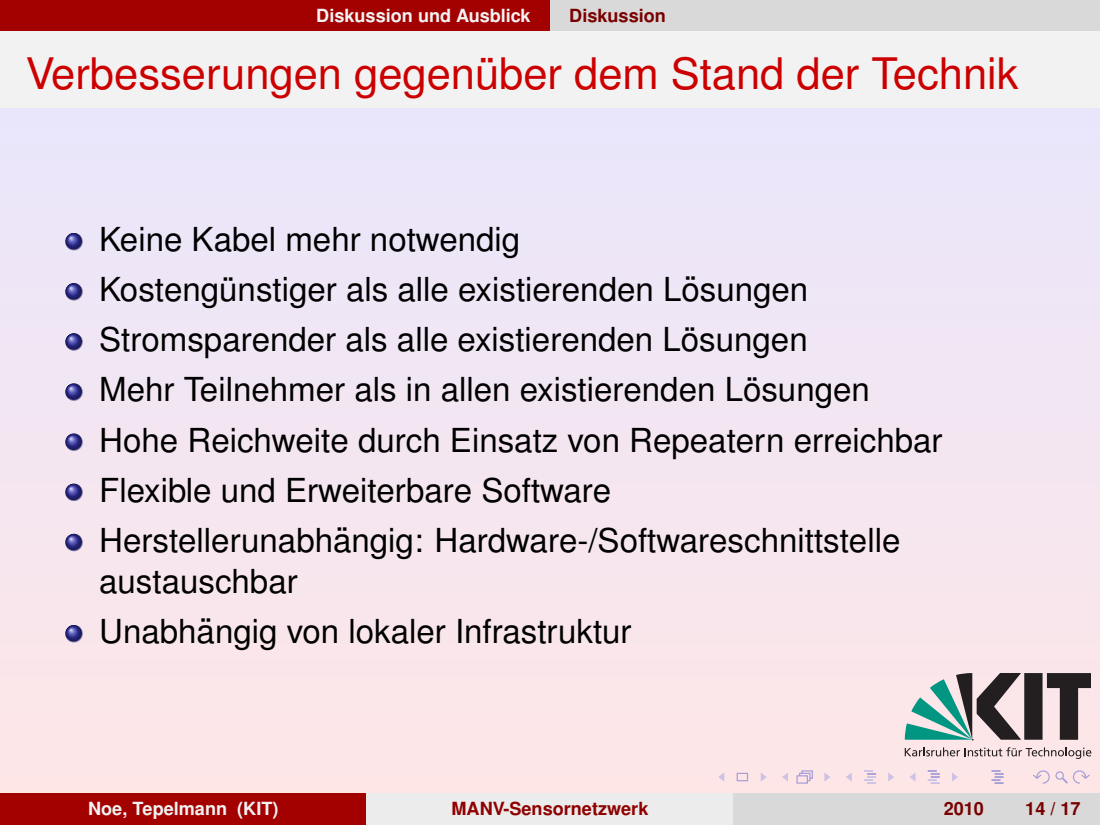
[picture p110: page 14]
Diskussion und Ausblick; Diskussion; Kostengunstiger als alle existierenden L ¨; osungen ¨; Noe, Tepelmann (KIT); MANV-Sensornetzwerk

Keine Kabel mehr notwendig
Stromsparender als alle existierenden Losungen ¨
Mehr Teilnehmer als in allen existierenden Losungen ¨
Hohe Reichweite durch Einsatz von Repeatern erreichbar
Flexible und Erweiterbare Software
Herstellerunabhangig: Hardware-/Softwareschnittstelle ¨
austauschbar
Unabhangig von lokaler Infrastruktur ¨

## Ausblick

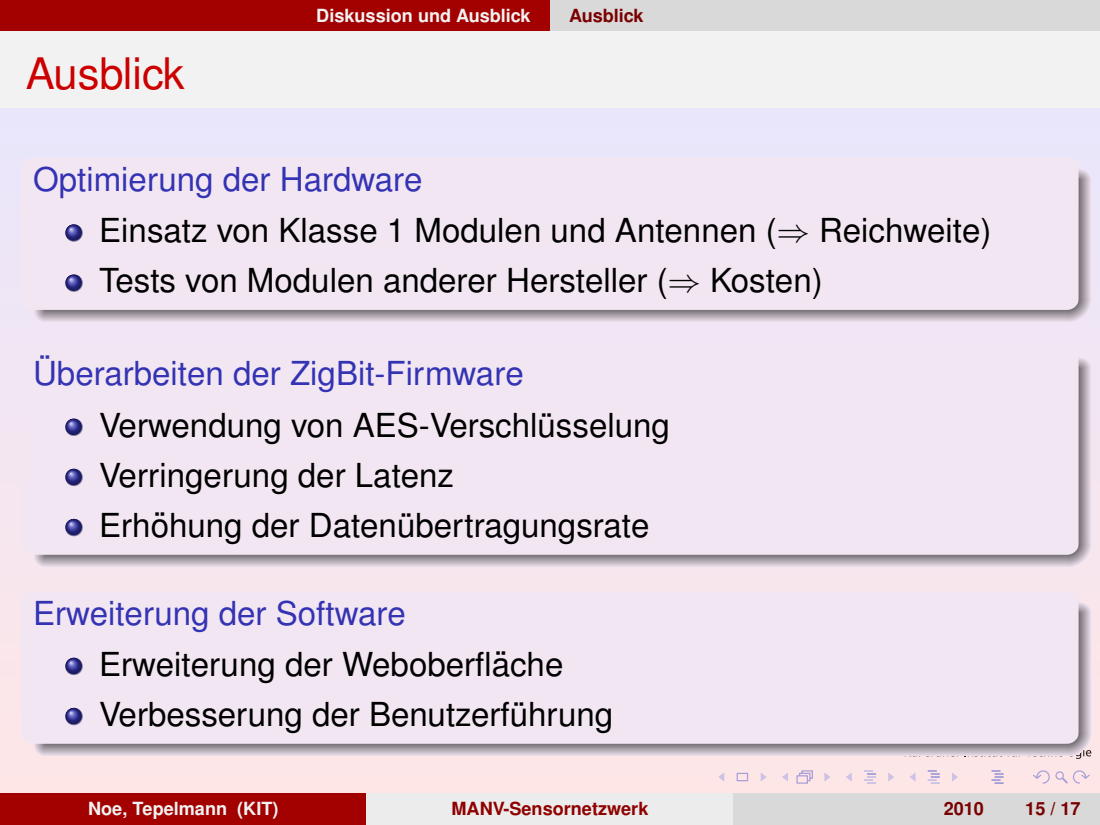
[picture p111: page 15]
Diskussion und Ausblick; Ausblick; Erhohung der Daten ¨; ubertragungsrate ¨; Noe, Tepelmann (KIT); MANV-Sensornetzwerk

Optimierung der Hardware
Einsatz von Klasse 1 Modulen und Antennen (⇒ Reichweite)
Tests von Modulen anderer Hersteller (⇒ Kosten)

Uberarbeiten der ZigBit-Firmware ¨
Verwendung von AES-Verschlusselung ¨
Verringerung der Latenz

Erweiterung der Software
Erweiterung der Weboberflache ¨
Verbesserung der Benutzerfuhrung ¨

## AAL-Kongress: Posterbeitrag

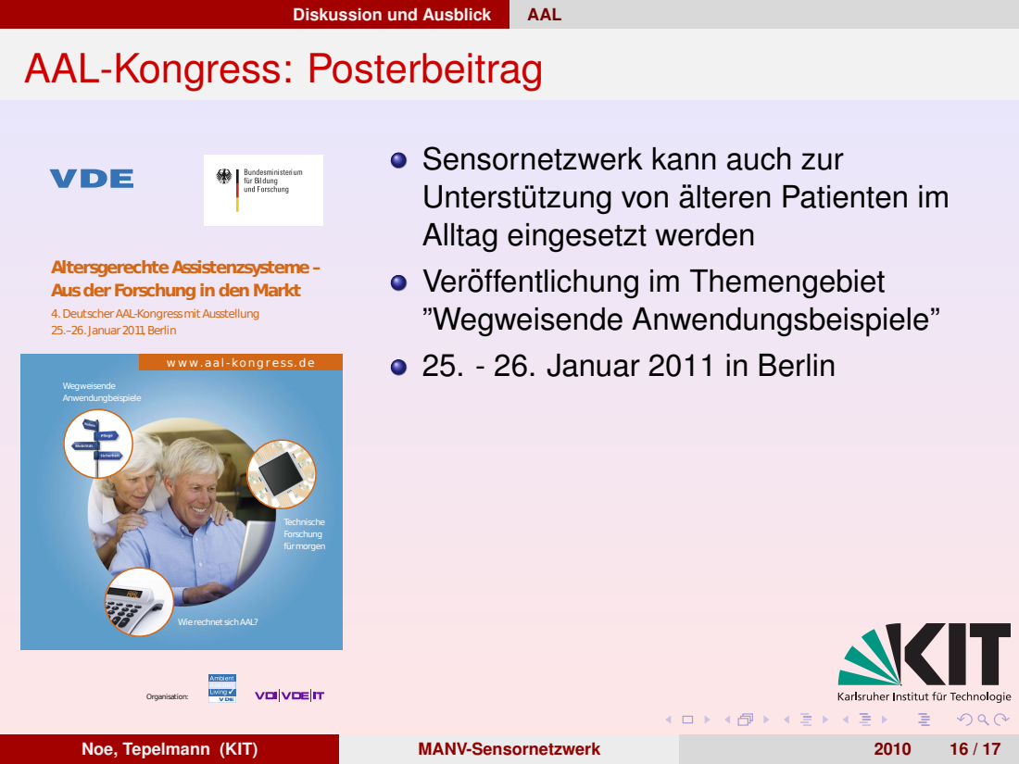
[picture p112: page 16]
Diskussion und Ausblick; AAL; Organisation:; Wegweisende Anwendungbeispiele; Technische Forschung für morgen; Unterstutzung von ¨; alteren Patienten im ¨; Noe, Tepelmann (KIT); MANV-Sensornetzwerk

Sensornetzwerk kann auch zur
Alltag eingesetzt werden
Veroffentlichung im Themengebiet ¨
”Wegweisende Anwendungsbeispiele”
25. - 26. Januar 2011 in Berlin

AltersgerechteAssistenzsysteme –
Aus der Forschung in den Markt

4. Deutscher AAL-Kongressmit Ausstellung
25.–26. Januar 2011, Berlin

w w w.aal -ko ng ress.de

Wie rechnet sich AAL?

## Fragen?

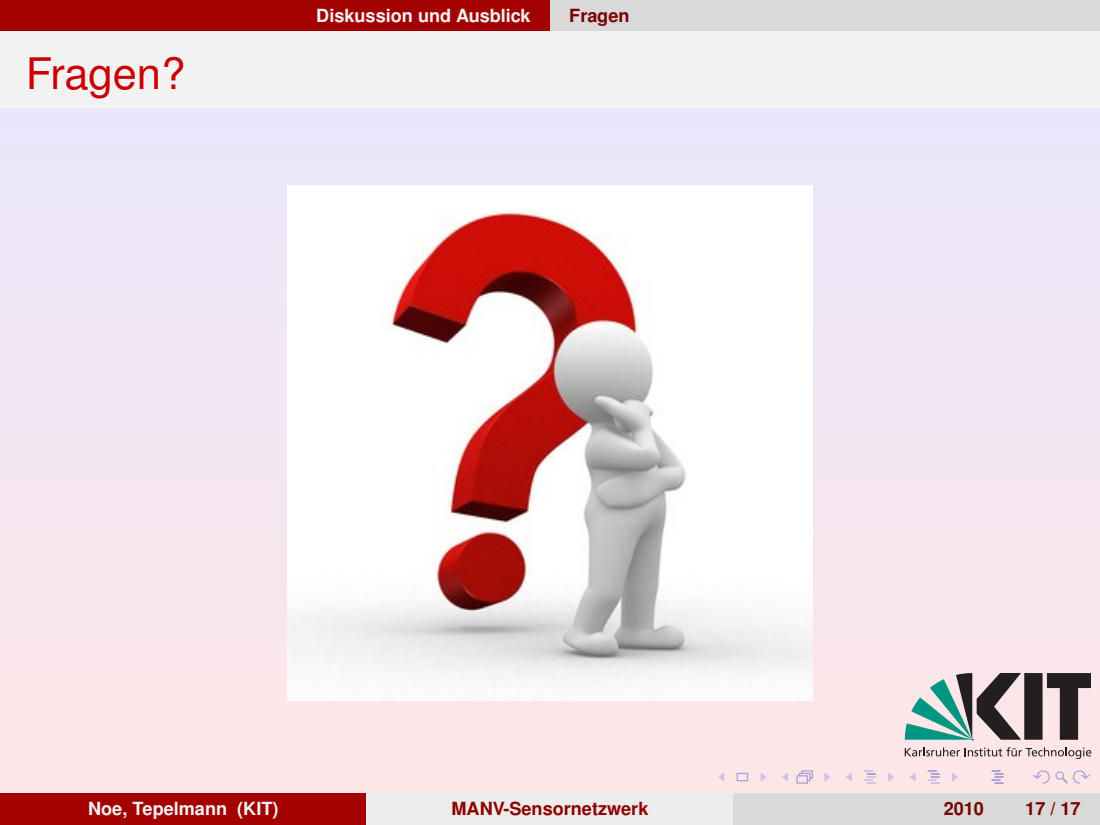
[picture p113: page 17]
Diskussion und Ausblick; Fragen; Noe, Tepelmann (KIT); MANV-Sensornetzwerk
