NeoLeMarc/Diplomarbeit/vortrag/vortrag_uebersicht.pdf

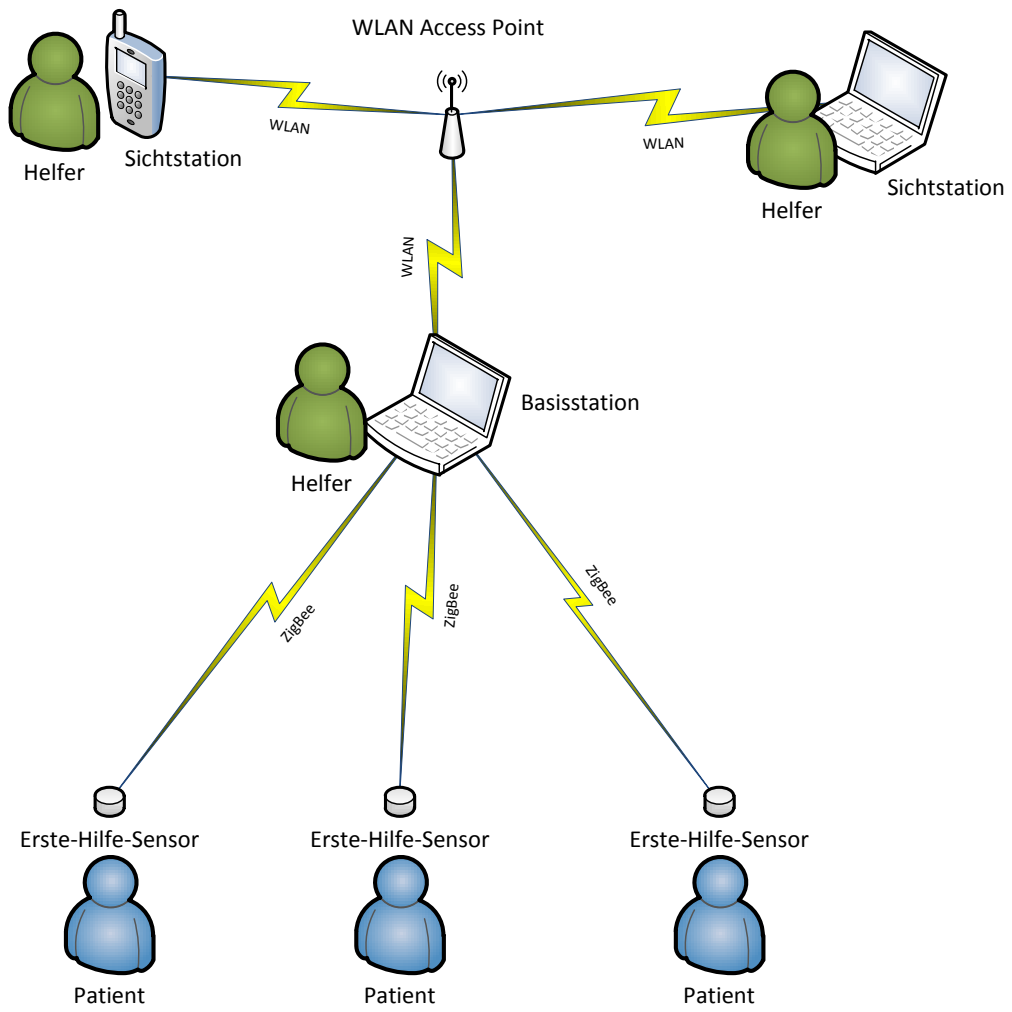
[picture p114: page 1]
WLAN ZigBee; ZigBee; WLAN; Patient; Basisstation; Helfer; Sichtstation

WLAN Access Point

Erste-Hilfe-Sensor
