NeoLeMarc/Diplomarbeit/vortrag/ZigBee_Netz.pdf

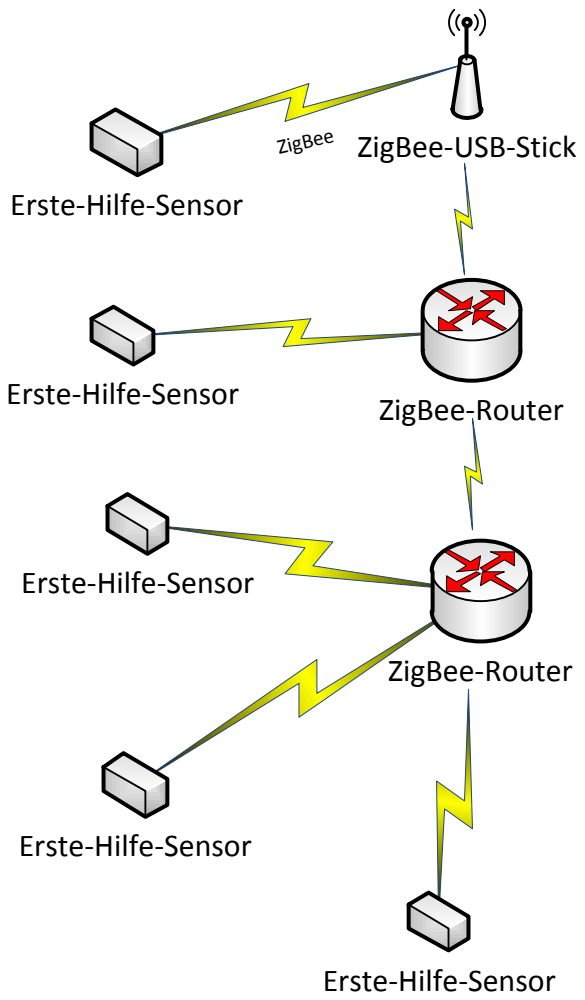
[picture p115: page 1]
ZigBee-Router

ZigBee
ZigBee-USB-Stick

Erste-Hilfe-Sensor
