NeoLeMarc/Diplomarbeit/vortrag_tng2/vortrag_uebersicht-crop.pdf

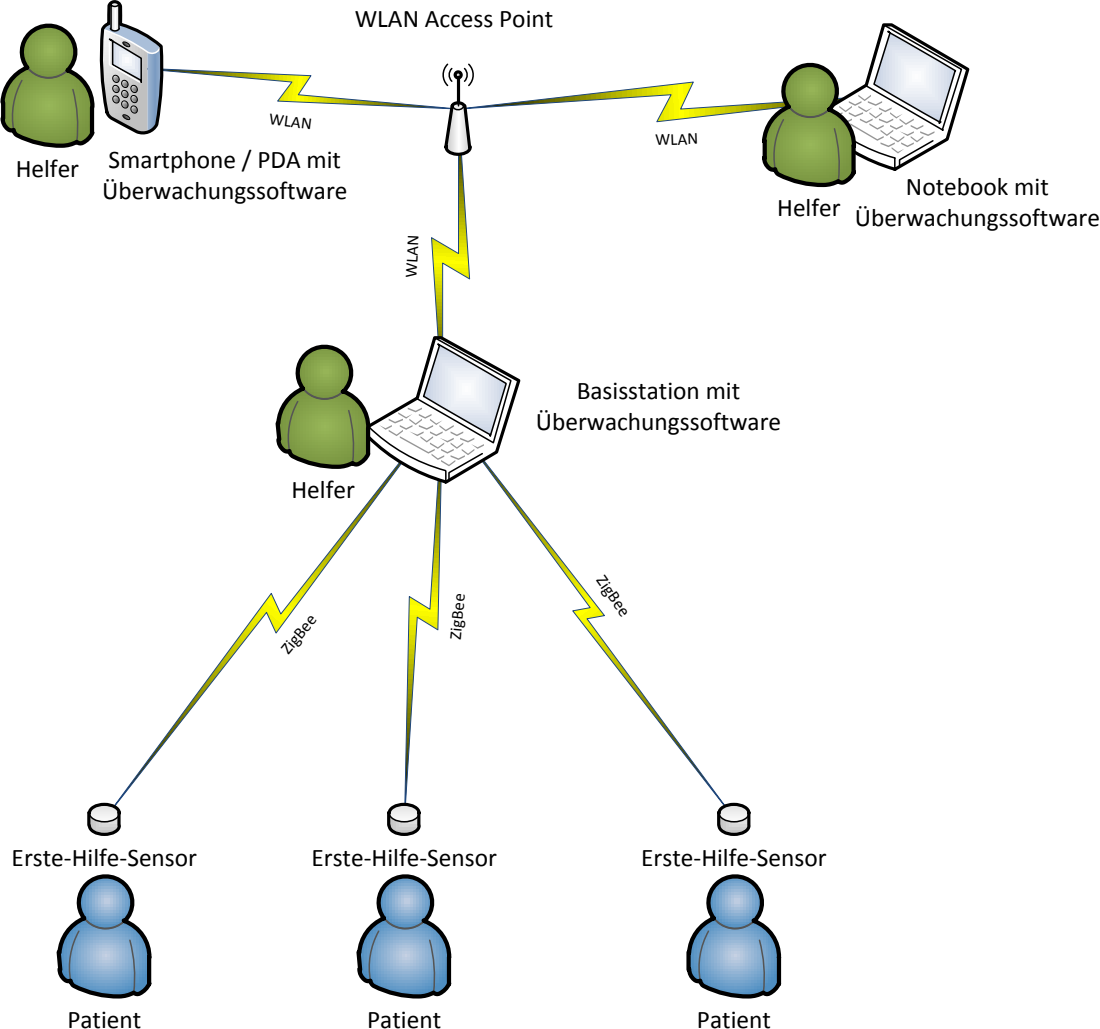
[picture p116: page 1]
WLAN ZigBee; ZigBee; WLAN; Patient; Basisstation mit Überwachungssoftware; Überwachungssoftware; Notebook mit Überwachungssoftware Helfer; Helfer

WLAN Access Point

Helfer Smartphone / PDA mit

Erste-Hilfe-Sensor
