NeoLeMarc/Diplomarbeit/ausarbeitung/uml_diagramme/manvconnector_uml_threads.pdf

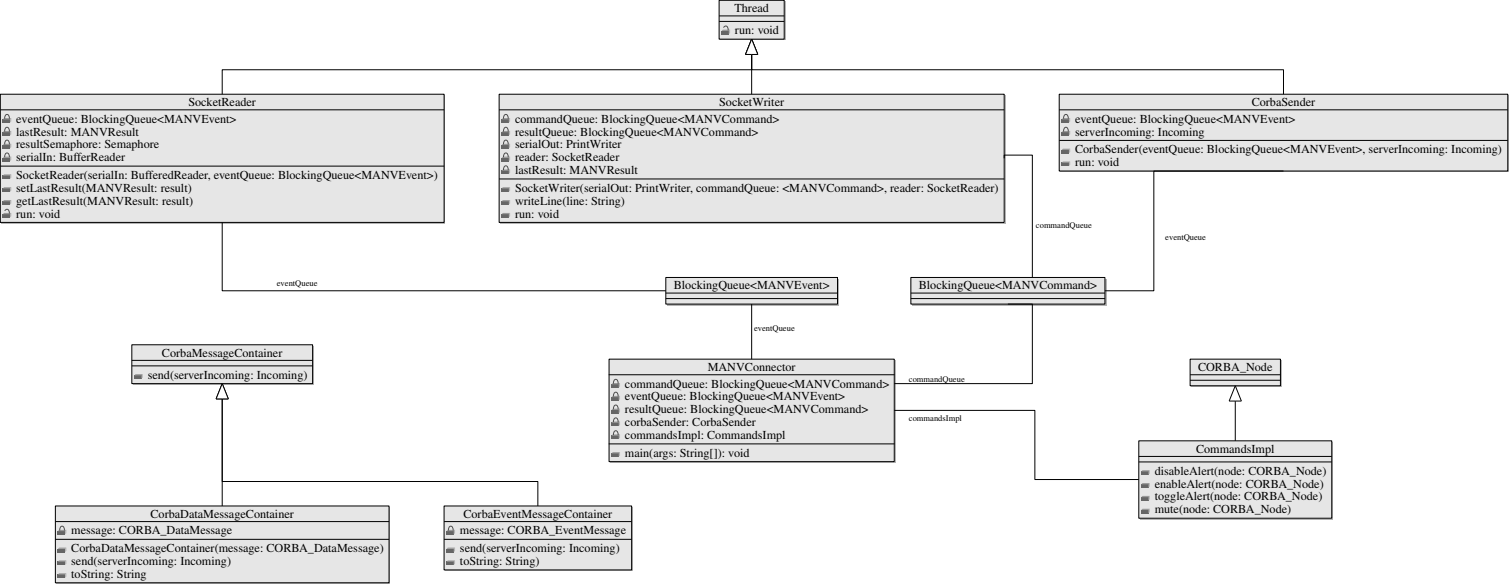
[picture p117: page 1]
MANVConnector; CORBA_Node; CommandsImpl; disableAlert(node: CORBA_Node) enableAlert(node: CORBA_Node) toggleAlert(node: CORBA_Node) mute(node: CORBA_Node); BlockingQueue<MANVEvent>; BlockingQueue<MANVCommand>; Thread; run: void; CorbaMessageContainer; eventQueue; commandQueue; commandsImpl

SocketReader | SocketWriter | CorbaSender

eventQueue: BlockingQueue<MANVEvent> lastResult: MANVResult resultSemaphore: Semaphore serialIn: BufferReader | commandQueue: BlockingQueue<MANVCommand> resultQueue: BlockingQueue<MANVCommand> serialOut: PrintWriter reader: SocketReader lastResult: MANVResult | eventQueue: BlockingQueue<MANVEvent> serverIncoming: Incoming

CorbaSender(eventQueue: BlockingQueue<MANVEvent>, serverIncoming: Incoming)
run: void

SocketReader(serialIn: BufferedReader, eventQueue: BlockingQueue<MANVEvent>)
setLastResult(MANVResult: result)
getLastResult(MANVResult: result)

SocketWriter(serialOut: PrintWriter, commandQueue: <MANVCommand>, reader: SocketReader)
writeLine(line: String)

send(serverIncoming: Incoming)

commandQueue: BlockingQueue<MANVCommand>
eventQueue: BlockingQueue<MANVEvent>
resultQueue: BlockingQueue<MANVCommand>
corbaSender: CorbaSender
commandsImpl: CommandsImpl
main(args: String[]): void

CorbaDataMessageContainer | CorbaEventMessageContainer

message: CORBA_DataMessage | message: CORBA_EventMessage
CorbaDataMessageContainer(message: CORBA_DataMessage) send(serverIncoming: Incoming) toString: String | send(serverIncoming: Incoming) toString: String)
