NeoLeMarc/Diplomarbeit/ausarbeitung/uml_diagramme/manvconnector_uml.pdf

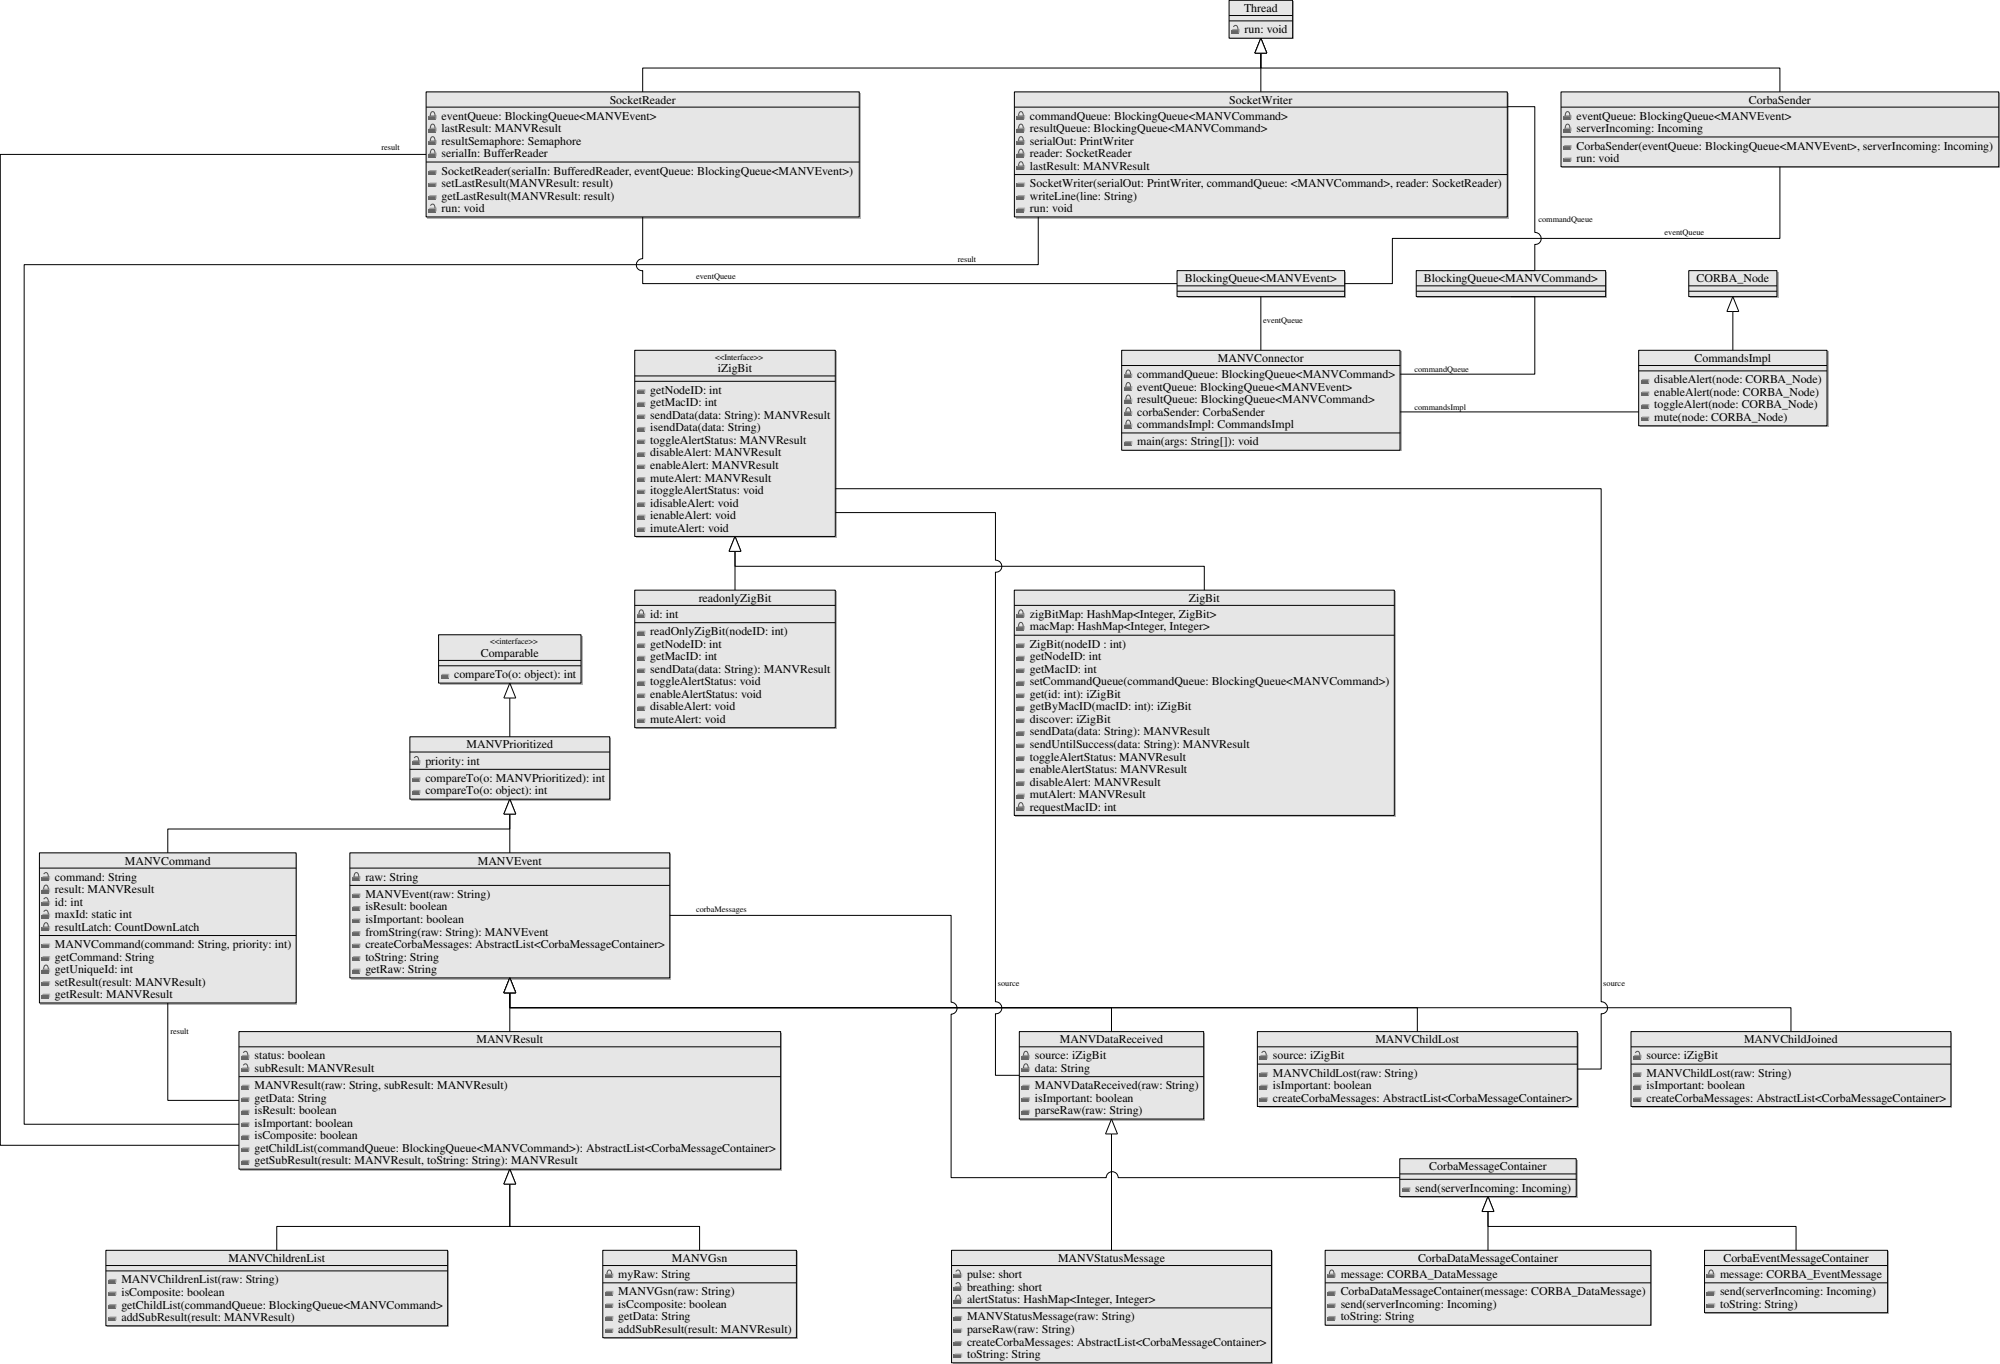
[picture p118: page 1]
MANVConnector; <<Interface>> iZigBit; readonlyZigBit; ZigBit; CORBA_Node; CommandsImpl; disableAlert(node: CORBA_Node) enableAlert(node: CORBA_Node) toggleAlert(node: CORBA_Node) mute(node: CORBA_Node); BlockingQueue<MANVEvent>; BlockingQueue<MANVCommand>; Thread; run: void; SocketReader; SocketWriter; CorbaSender; <<interface>> Comparable; MANVPrioritized; MANVEvent; MANVResult; MANVCommand; MANVChildLost; MANVChildJoined; MANVStatusMessage; MANVGsn; MANVChildrenList; CorbaMessageContainer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

eventQueue: BlockingQueue<MANVEvent>
lastResult: MANVResult
resultSemaphore: Semaphore
serialIn: BufferReader
SocketReader(serialIn: BufferedReader, eventQueue: BlockingQueue<MANVEvent>)
setLastResult(MANVResult: result)
getLastResult(MANVResult: result)
run: void

commandQueue: BlockingQueue<MANVCommand>
resultQueue: BlockingQueue<MANVCommand>
serialOut: PrintWriter
reader: SocketReader
SocketWriter(serialOut: PrintWriter, commandQueue: <MANVCommand>, reader: SocketReader)
writeLine(line: String)

serverIncoming: Incoming
CorbaSender(eventQueue: BlockingQueue<MANVEvent>, serverIncoming: Incoming)

corbaSender: CorbaSender
commandsImpl: CommandsImpl
main(args: String[]): void

getNodeID: int
getMacID: int
sendData(data: String): MANVResult
isendData(data: String)
toggleAlertStatus: MANVResult
disableAlert: MANVResult
enableAlert: MANVResult
muteAlert: MANVResult
itoggleAlertStatus: void
idisableAlert: void
ienableAlert: void
imuteAlert: void

id: int
readOnlyZigBit(nodeID: int)
toggleAlertStatus: void
enableAlertStatus: void
disableAlert: void
muteAlert: void

zigBitMap: HashMap<Integer, ZigBit>
macMap: HashMap<Integer, Integer>
ZigBit(nodeID : int)
setCommandQueue(commandQueue: BlockingQueue<MANVCommand>)
get(id: int): iZigBit
getByMacID(macID: int): iZigBit
discover: iZigBit
sendUntilSuccess(data: String): MANVResult
enableAlertStatus: MANVResult
mutAlert: MANVResult
requestMacID: int

compareTo(o: object): int

priority: int
compareTo(o: MANVPrioritized): int

command: String
result: MANVResult
maxId: static int
resultLatch: CountDownLatch
MANVCommand(command: String, priority: int)
getCommand: String
getUniqueId: int
setResult(result: MANVResult)
getResult: MANVResult

raw: String
MANVEvent(raw: String)
isResult: boolean
isImportant: boolean
fromString(raw: String): MANVEvent
createCorbaMessages: AbstractList<CorbaMessageContainer>
toString: String
getRaw: String

MANVDataReceived
source: iZigBit
data: String
MANVDataReceived(raw: String)
parseRaw(raw: String)

status: boolean
subResult: MANVResult
MANVResult(raw: String, subResult: MANVResult)
getData: String
isComposite: boolean
getChildList(commandQueue: BlockingQueue<MANVCommand>): AbstractList<CorbaMessageContainer>
getSubResult(result: MANVResult, toString: String): MANVResult

MANVChildLost(raw: String)

send(serverIncoming: Incoming)

CorbaEventMessageContainer
message: CORBA_EventMessage
toString: String)

myRaw: String
MANVGsn(raw: String)
isCcomposite: boolean
addSubResult(result: MANVResult)

pulse: short
breathing: short
alertStatus: HashMap<Integer, Integer>
MANVStatusMessage(raw: String)

message: CORBA_DataMessage
CorbaDataMessageContainer(message: CORBA_DataMessage)

MANVChildrenList(raw: String)
getChildList(commandQueue: BlockingQueue<MANVCommand>
