NeoLeMarc/Diplomarbeit/ausarbeitung/uml_diagramme/manvconnector_uml_rechts.pdf

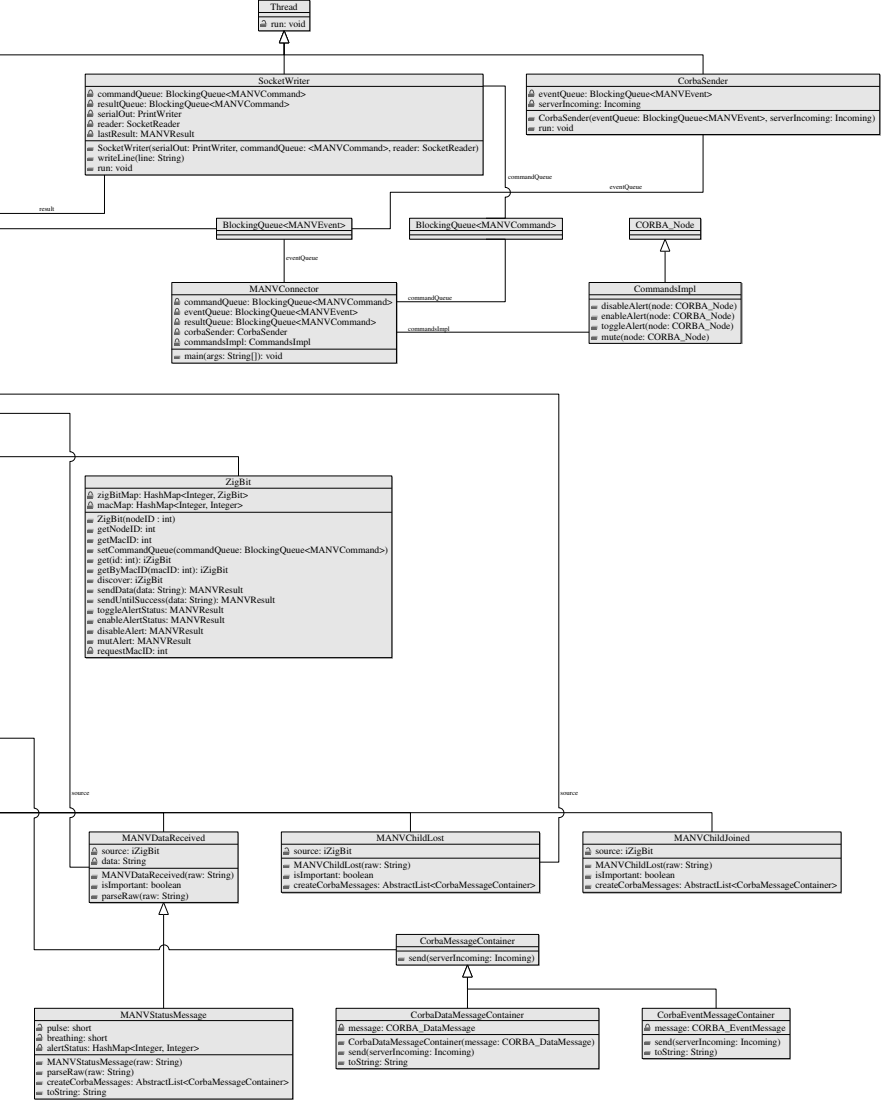
[picture p119: page 1]
MANVConnector; CORBA_Node; CommandsImpl; disableAlert(node: CORBA_Node) enableAlert(node: CORBA_Node) toggleAlert(node: CORBA_Node) mute(node: CORBA_Node); BlockingQueue<MANVEvent>; BlockingQueue<MANVCommand>; Thread; run: void; lastResult: MANVResult; MANVStatusMessage; CorbaDataMessageContainer; eventQueue; source; commandQueue; commandsImpl

SocketWriter | CorbaSender

commandQueue: BlockingQueue<MANVCommand> resultQueue: BlockingQueue<MANVCommand> serialOut: PrintWriter reader: SocketReader | eventQueue: BlockingQueue<MANVEvent> serverIncoming: Incoming

CorbaSender(eventQueue: BlockingQueue<MANVEvent>, serverIncoming: Incoming)
run: void

SocketWriter(serialOut: PrintWriter, commandQueue: <MANVCommand>, reader: SocketReader) writeLine(line: String) run: void

result

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

ZigBit

zigBitMap: HashMap<Integer, ZigBit> macMap: HashMap<Integer, Integer>

ZigBit(nodeID : int) getNodeID: int getMacID: int setCommandQueue(commandQueue: BlockingQueue<MANVCommand>) get(id: int): iZigBit getByMacID(macID: int): iZigBit discover: iZigBit sendData(data: String): MANVResult sendUntilSuccess(data: String): MANVResult toggleAlertStatus: MANVResult enableAlertStatus: MANVResult disableAlert: MANVResult mutAlert: MANVResult requestMacID: int

MANVDataReceived | MANVChildLost | MANVChildJoined
source: iZigBit data: String | | source: iZigBit | source: iZigBit

MANVChildLost(raw: String) isImportant: boolean createCorbaMessages: AbstractList<CorbaMessageContainer> | MANVChildLost(raw: String) isImportant: boolean createCorbaMessages: AbstractList<CorbaMessageContainer>

MANVDataReceived(raw: String)
isImportant: boolean
parseRaw(raw: String)

CorbaMessageContainer
send(serverIncoming: Incoming)

CorbaEventMessageContainer
message: CORBA_EventMessage
toString: String)

pulse: short
breathing: short
alertStatus: HashMap<Integer, Integer>
MANVStatusMessage(raw: String)
createCorbaMessages: AbstractList<CorbaMessageContainer>
toString: String

message: CORBA_DataMessage
CorbaDataMessageContainer(message: CORBA_DataMessage)
