NeoLeMarc/Diplomarbeit/ausarbeitung/diagramme/Gesamtuebersicht.pdf

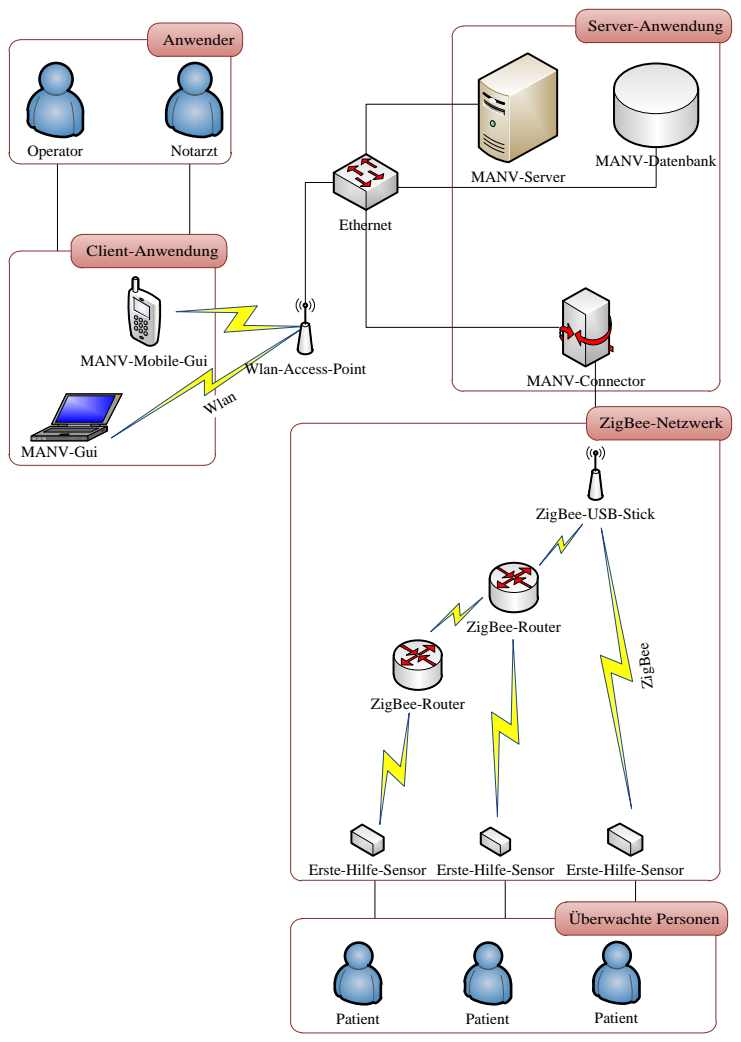
[picture p120: page 1]
Server-Anwendung; MANV-Datenbank; MANV-Connector; Ethernet; MANV-Server; Client-Anwendung; MANV-Gui; Wlan; Anwender; Operator; Notarzt; Überwachte Personen; Patient; ZigBee-Netzwerk; ZigBee-Router; ZigB

MANV-Mobile-Gui

Wlan-Access-Point

ZigBee-USB-Stick

Erste-Hilfe-Sensor Erste-Hilfe-Sensor Erste-Hilfe-Sensor
