NeoLeMarc/Diplomarbeit/ausarbeitung/diagramme/Flussdiagramm-Firmware-Mainloop-crop.pdf

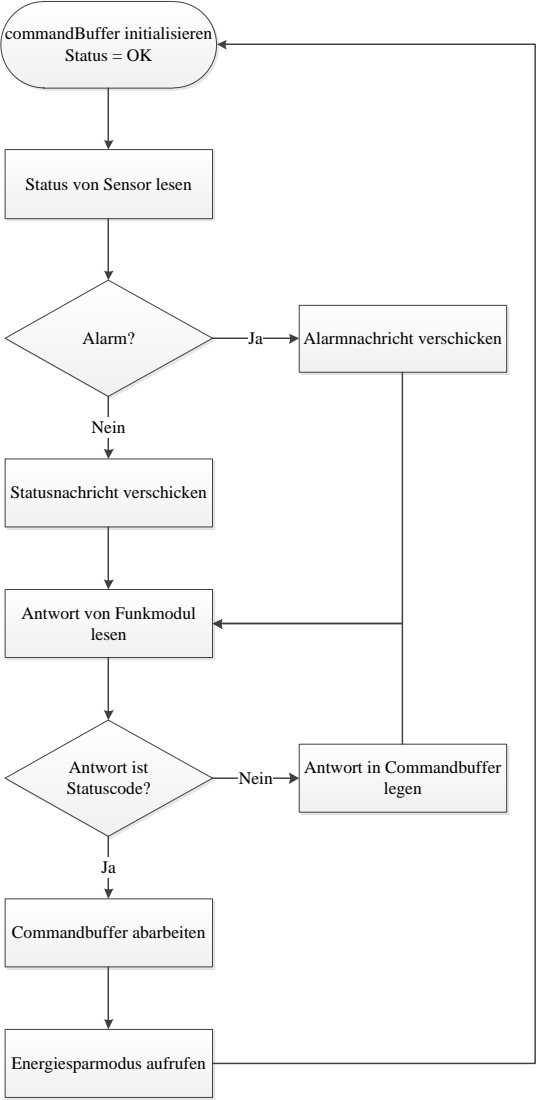
[picture p121: page 1]
commandBuffer initialisieren Status = OK; Alarm?; Alarmnachricht verschicken; Statusnachricht verschicken; Nein; lesen; Antwort ist Statuscode?; legen; Commandbuffer abarbeiten; Energiesparmodus aufrufen

Status von Sensor lesen

Antwort von Funkmodul

Antwort in Commandbuffer
