NeoLeMarc/Diplomarbeit/ausarbeitung/diagramme/manv_connector_sequenzdiagramm_main-crop.pdf

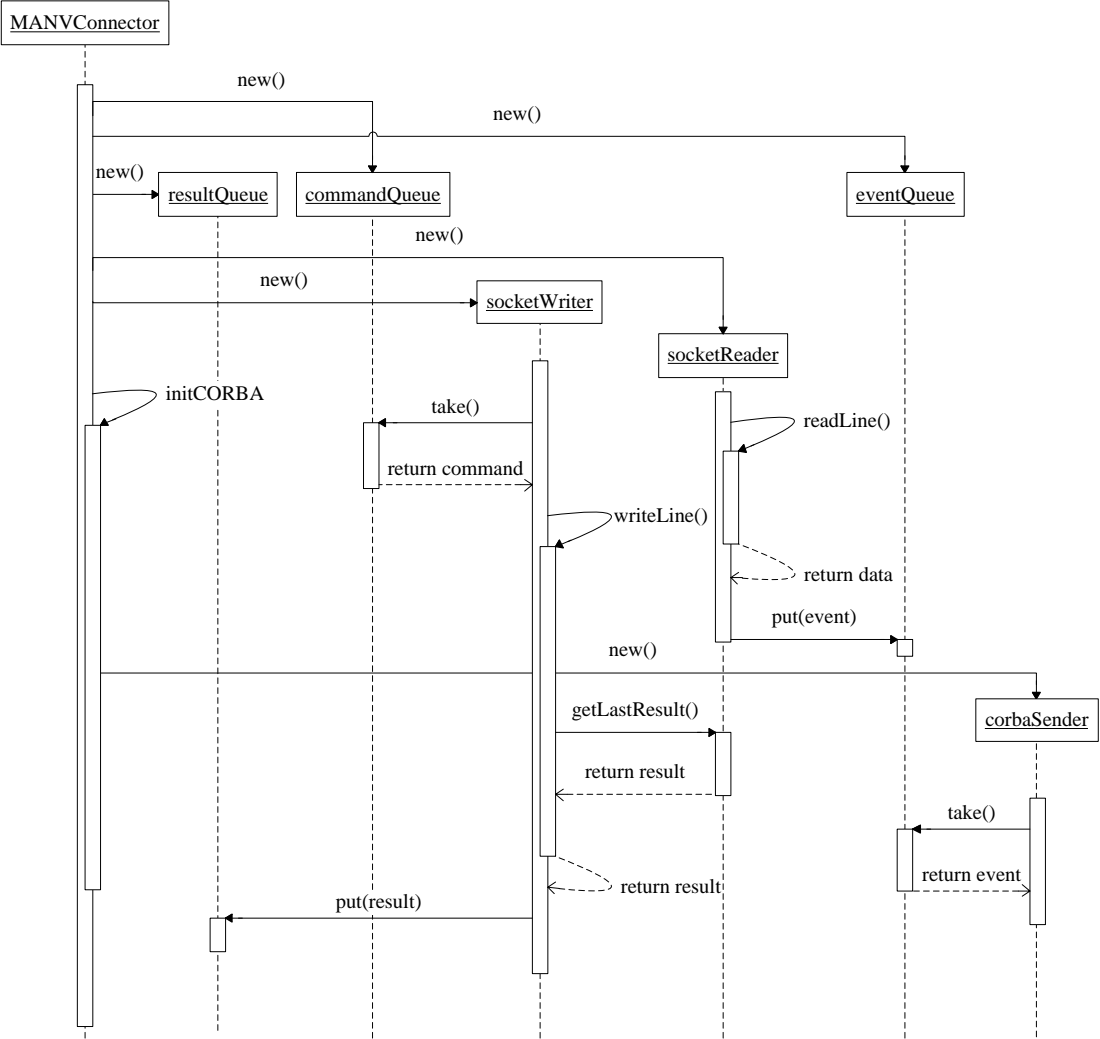
[picture p122: page 1]
new(); MANVConnector; resultQueue; commandQueue; eventQueue; initCORBA; socketReader; socketWriter; take(); return command; writeLine(); return result; put(result); readLine(); return data; put(event); getLastResult(); corbaSender; return event
