NeoLeMarc/Diplomarbeit/ausarbeitung/diagramme/schaltplan_manvnode_power-crop.pdf

# power

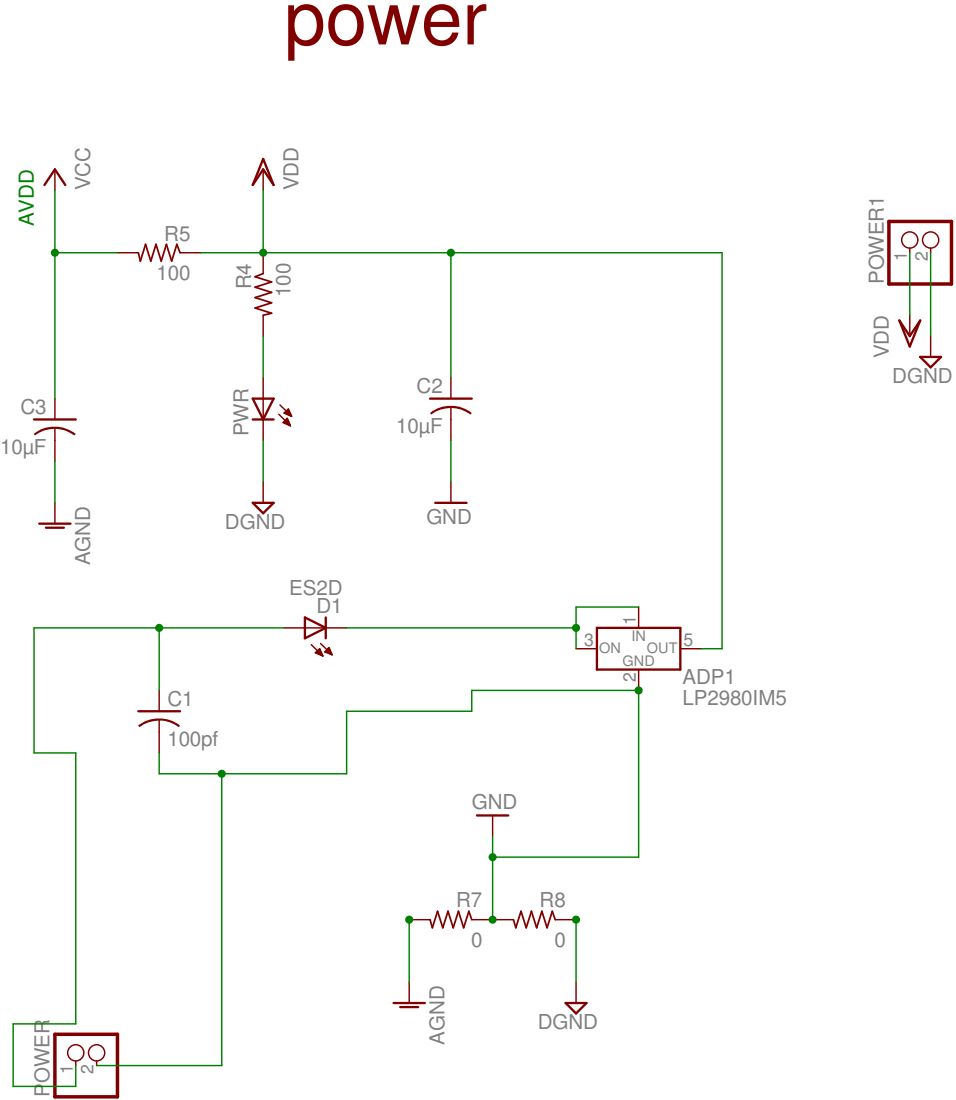
[picture p123: page 1]
