NeoLeMarc/Diplomarbeit/ausarbeitung/diagramme/aduc_blockdiagramm.pdf

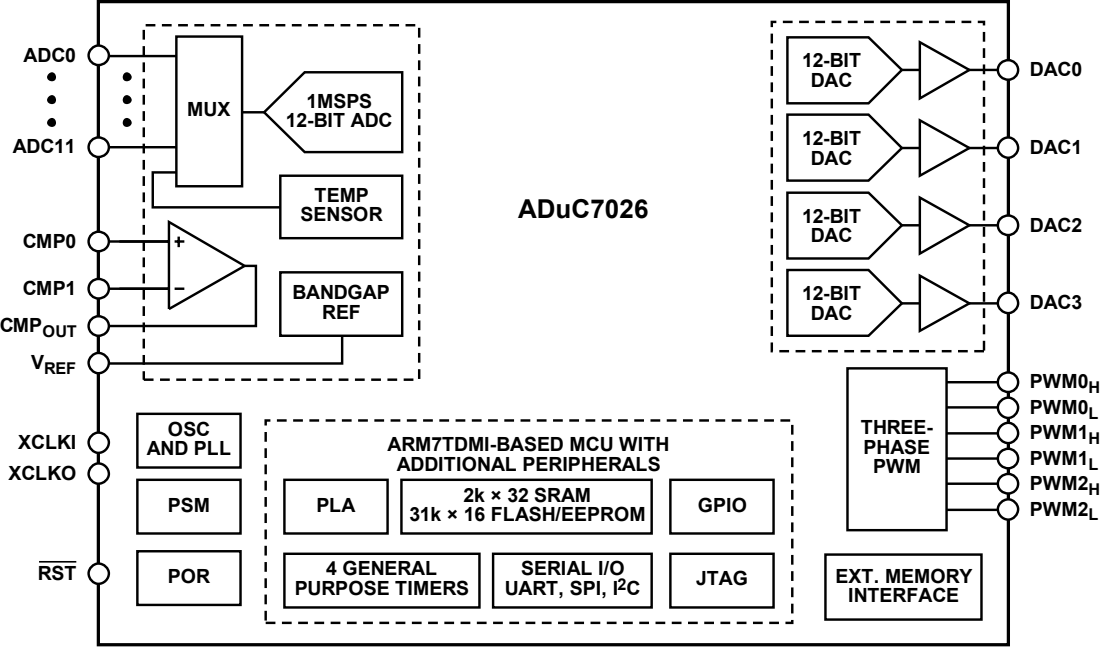
[picture p124: page 1]
1MSPS 12-BIT ADC; DAC0 12-BIT DAC; DAC1 12-BIT DAC; DAC2 12-BIT DAC; DAC3 12-BIT DAC; PWM0 H PWM0 L PWM1 H PWM1 L PWM2 H PWM2 L; THREE- PHASE PWM; EXT. MEMORY INTERFACE; ADuC7026; ADC0; XCLKI XCLKO; RST VREF; ADC11; MUX; TEMP SENSOR; BANDGAP REF; OSC AND PLL; PSM; POR; CMP0; CMP1; CMPOUT; PLA; 4 GENERAL PURPOSE TIMERS; 2k × 32 SRAM 31k × 16 FLASH/EEPROM; SERIAL I/O UART, SPI, I; GPIO; JTAG

ARM7TDMI-BASED MCU WITH
ADDITIONAL PERIPHERALS
