NeoLeMarc/Diplomarbeit/ausarbeitung/diagramme/zigbit_blockdiagramm.pdf

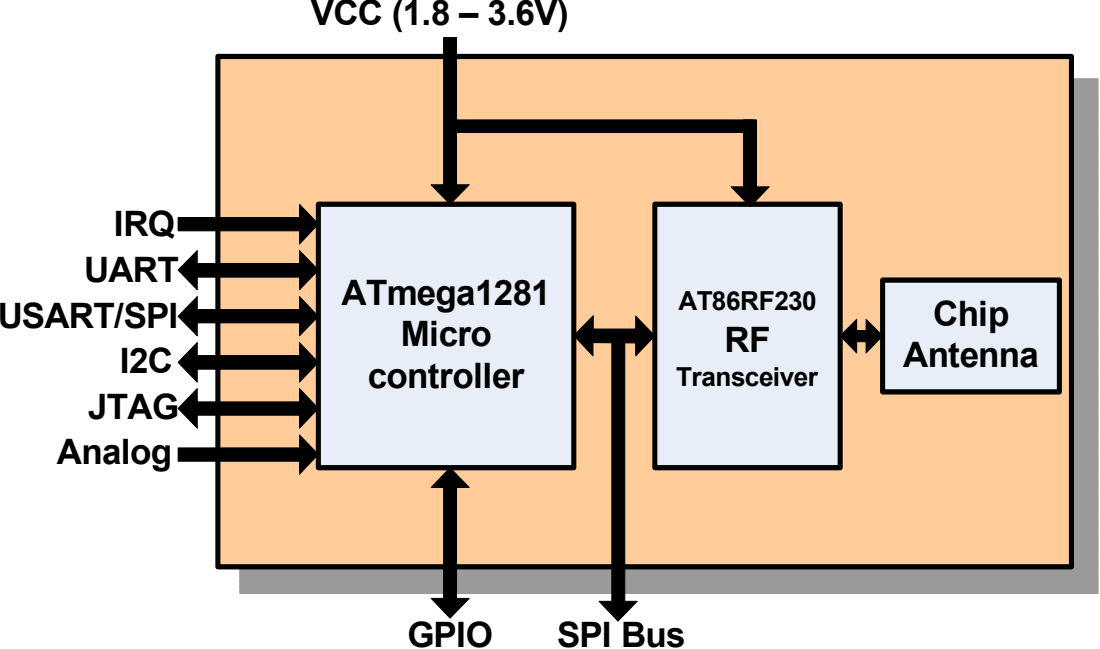
[picture p125: page 1]
ATmega1281 Micro controller; SPI BusGPIO; VCC (1.8 – 3.6V); UART; I2C JTAG Analog; IRQ; AT86RF230 RF Transceiver; Chip Antenna; USART/SPI
