NeoLeMarc/Diplomarbeit/ausarbeitung/diagramme/gesamtübersicht.pdf

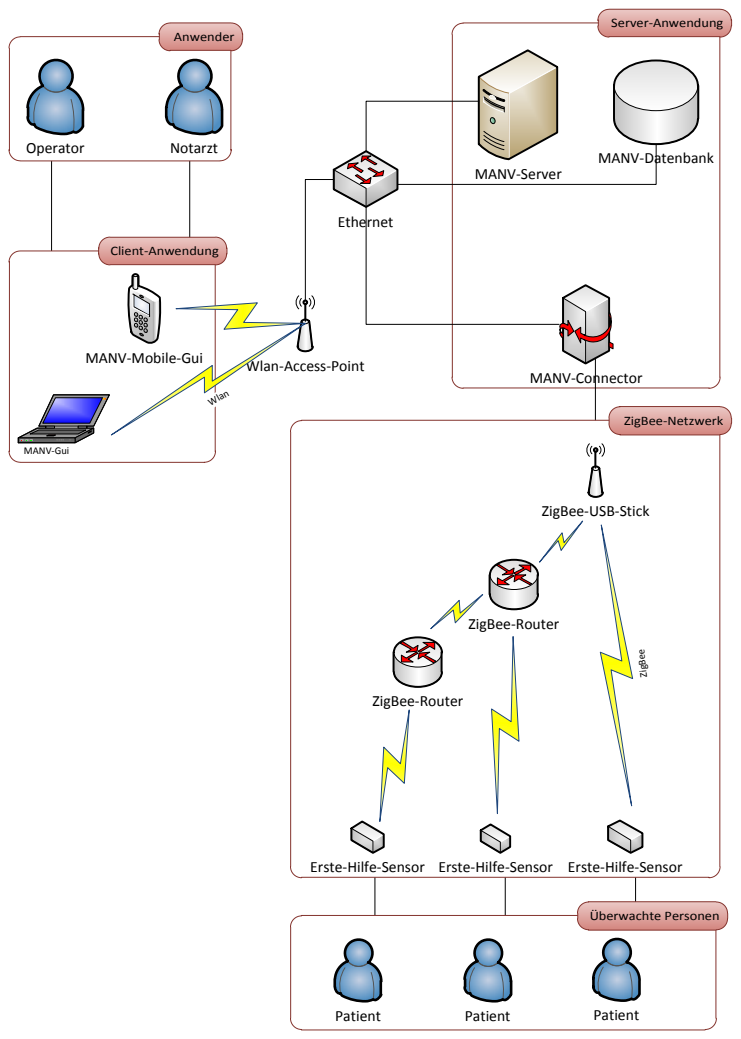
[picture p126: page 1]
Server-Anwendung; MANV-Datenbank; MANV-Connector; Ethernet; MANV-Server; Client-Anwendung; MANV-Gui; Wlan; Anwender; Operator; Notarzt; Überwachte Personen; Patient; ZigBee-Netzwerk; ZigBee-Router; Z gi Bee ZigBee-USB-Stick

MANV-Mobile-Gui

Wlan-Access-Point

Erste-Hilfe-Sensor Erste-Hilfe-Sensor Erste-Hilfe-Sensor
