NeoLeMarc/Diplomarbeit/ausarbeitung/diagramme/versuchsaufbau_integrationstest.pdf

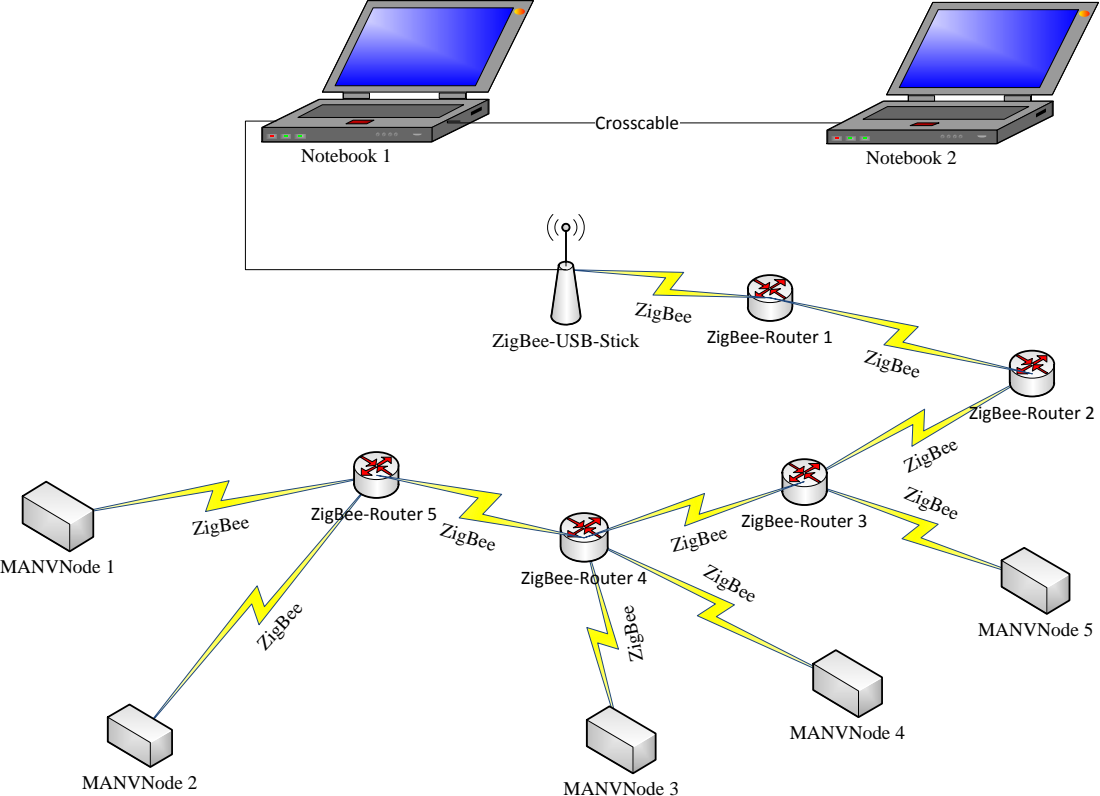
[picture p127: page 1]
ZigBee; ZigB; Notebook 1; MANVNode 1; ZigBee-Router 1; ZigBee-Router 3; Notebook 2; Crosscable; ZigBee-Router 2; ZigBee-Router 4; ZigBee-Router 5; MANVNode 2; MANVNode 3; MANVNode 4; MANVNode 5

ZigBee-USB-Stick

ZigB ZigBee ee
