NeoLeMarc/Diplomarbeit/ausarbeitung/uml_diagramme/manvconnector_uml_zigbit.pdf

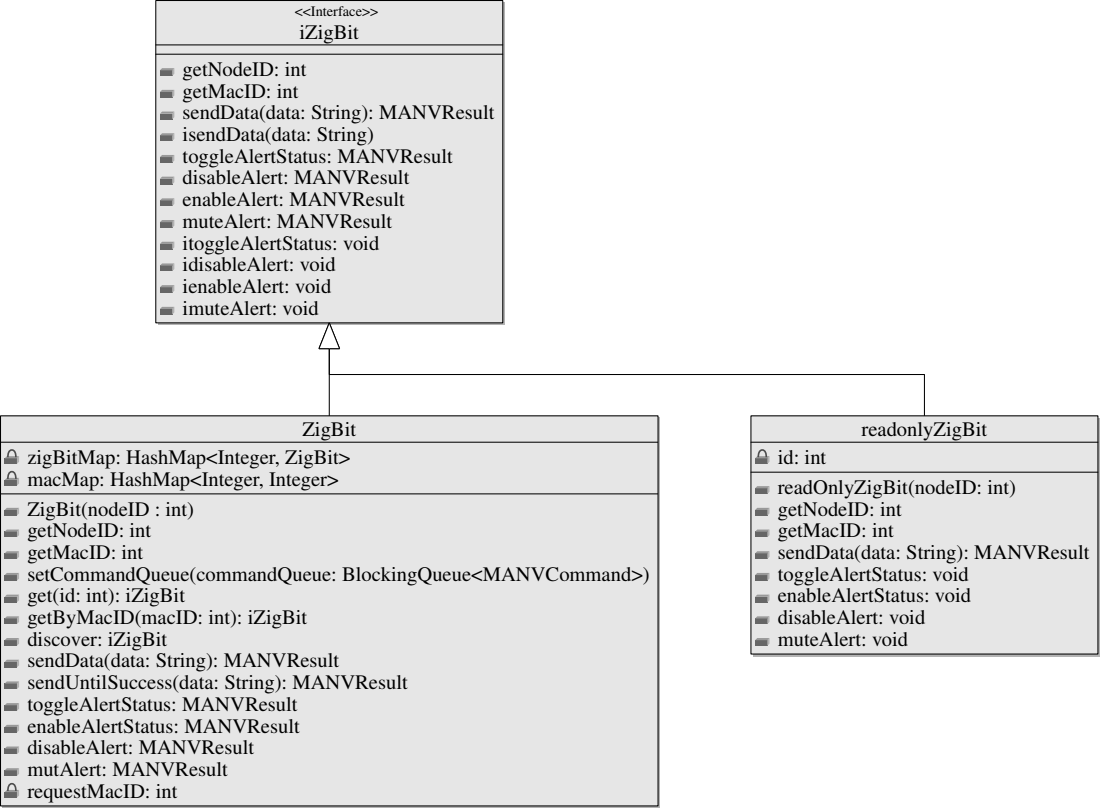
[picture p128: page 1]
<<Interface>> iZigBit

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

ZigBit | readonlyZigBit

zigBitMap: HashMap<Integer, ZigBit> macMap: HashMap<Integer, Integer> | id: int

readOnlyZigBit(nodeID: int)
toggleAlertStatus: void
enableAlertStatus: void
disableAlert: void
muteAlert: void

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
