NeoLeMarc/Diplomarbeit/ausarbeitung/uml_diagramme/manvconnector_uml_links.pdf

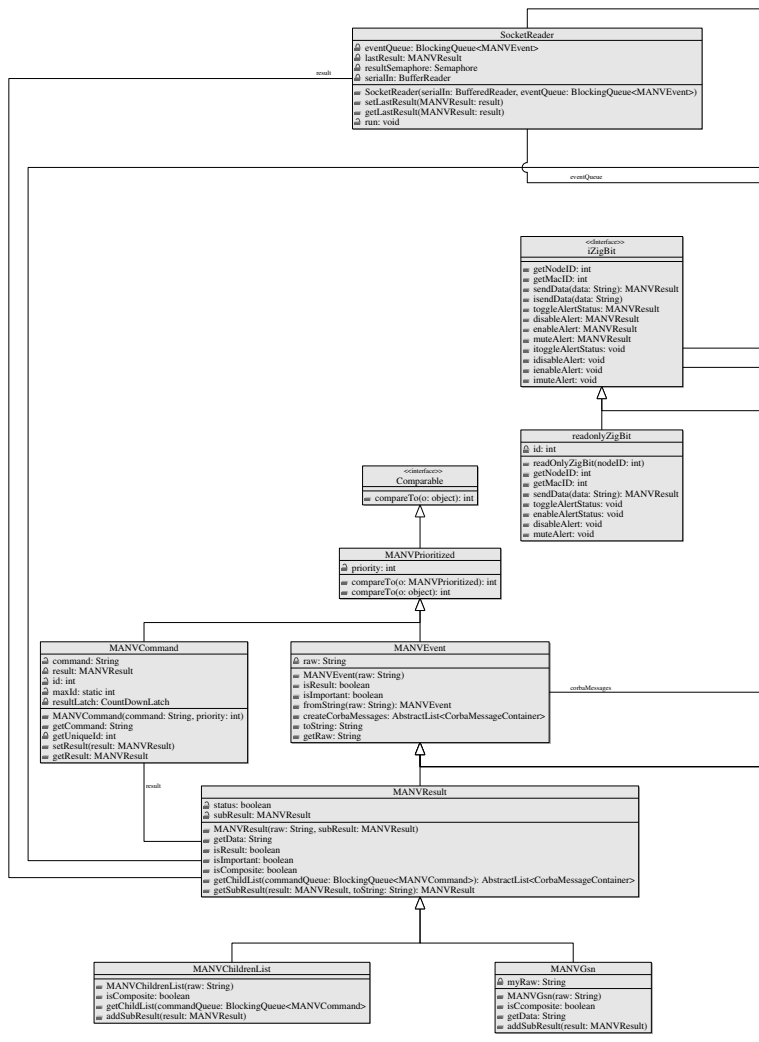
[picture p129: page 1]
<<Interface>> iZigBit; readonlyZigBit; SocketReader; MANVGsn; MANVChildrenList; eventQueue; result; corbaMessages

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

id: int
readOnlyZigBit(nodeID: int)
toggleAlertStatus: void
enableAlertStatus: void
disableAlert: void
muteAlert: void

<<interface>>
Comparable
compareTo(o: object): int

MANVPrioritized
priority: int
compareTo(o: MANVPrioritized): int compareTo(o: object): int

MANVCommand | | MANVEvent

command: String result: MANVResult id: int maxId: static int resultLatch: CountDownLatch | raw: String

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

MANVCommand(command: String, priority: int)
getCommand: String
getUniqueId: int
setResult(result: MANVResult)
getResult: MANVResult

MANVResult

status: boolean subResult: MANVResult

MANVResult(raw: String, subResult: MANVResult) getData: String isResult: boolean isImportant: boolean

isComposite: boolean getChildList(commandQueue: BlockingQueue<MANVCommand>): AbstractList<CorbaMessageContainer>

getSubResult(result: MANVResult, toString: String): MANVResult

MANVChildrenList(raw: String)
isComposite: boolean
getChildList(commandQueue: BlockingQueue<MANVCommand>
addSubResult(result: MANVResult)

myRaw: String
MANVGsn(raw: String)
isCcomposite: boolean
getData: String
