NeoLeMarc/Diplomarbeit/ausarbeitung/diagramme/corba.pdf

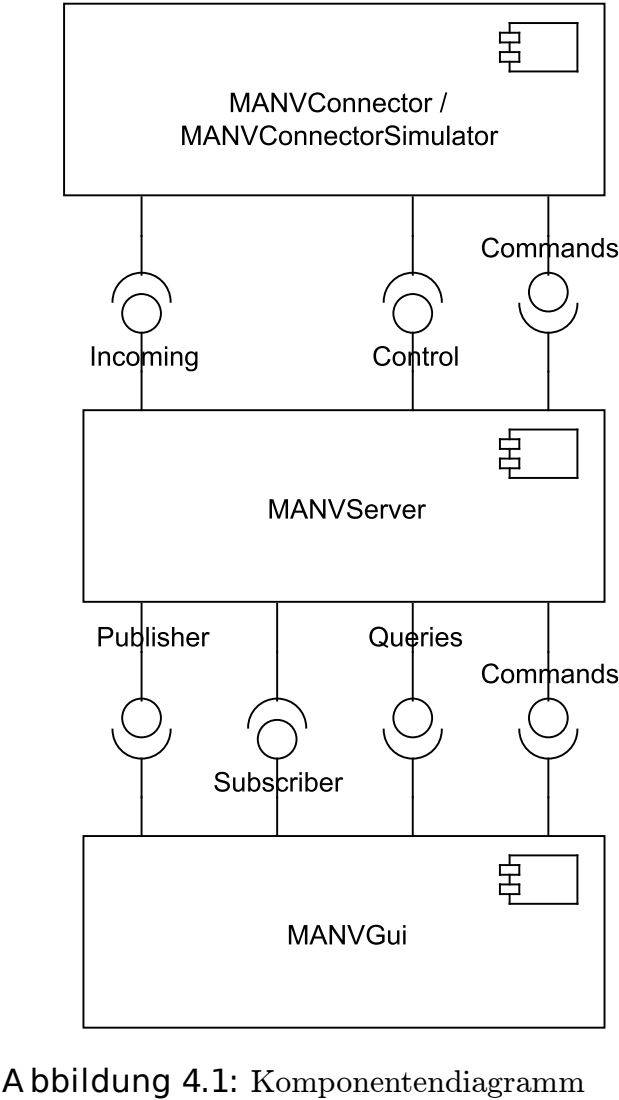
[picture p130: page 1]
A bbildung 4.1: Komponentendiagramm
