NeoLeMarc/Diplomarbeit/ausarbeitung/diagramme/manvnode_mitte.pdf

# ADuC 7026

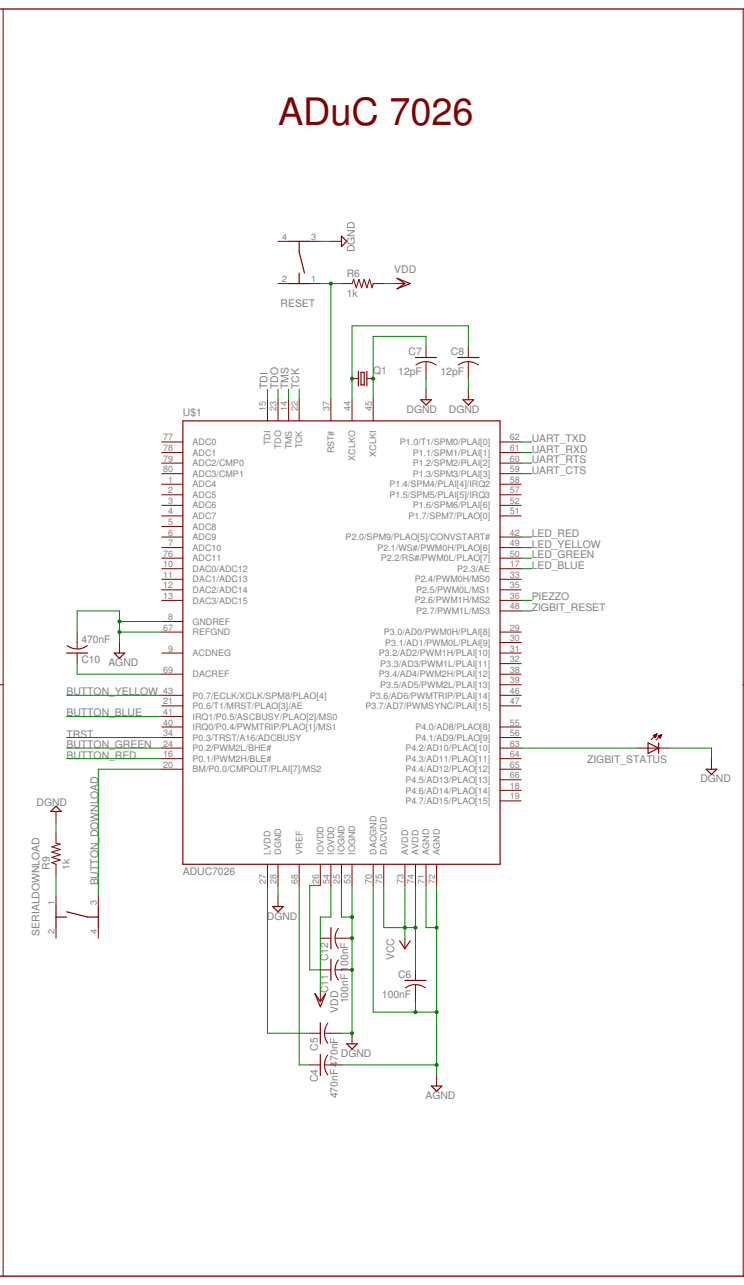
[picture p131: page 1]
