NeoLeMarc/Diplomarbeit/ausarbeitung/diagramme/schaltplan_manvnode_aduc-crop.pdf

# ADuC 7026

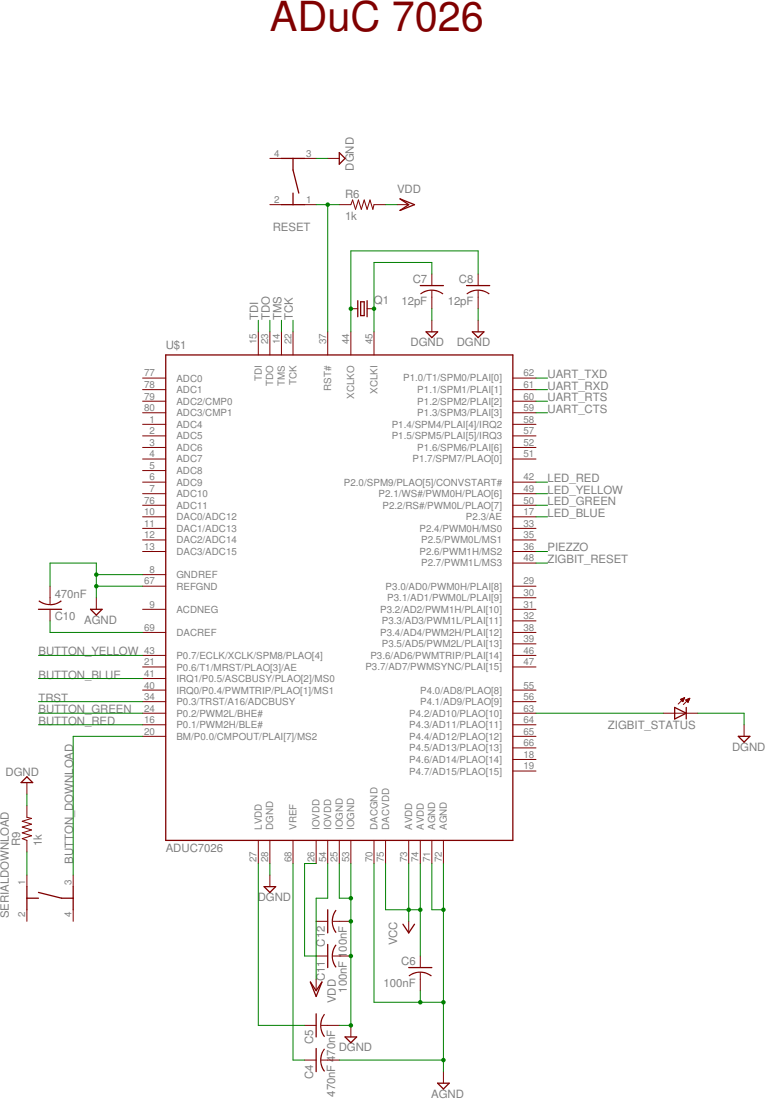
[picture p132: page 1]
