NeoLeMarc/Diplomarbeit/ausarbeitung/diagramme/schaltplan_manvnode_aduc.pdf

# ADuC 7026

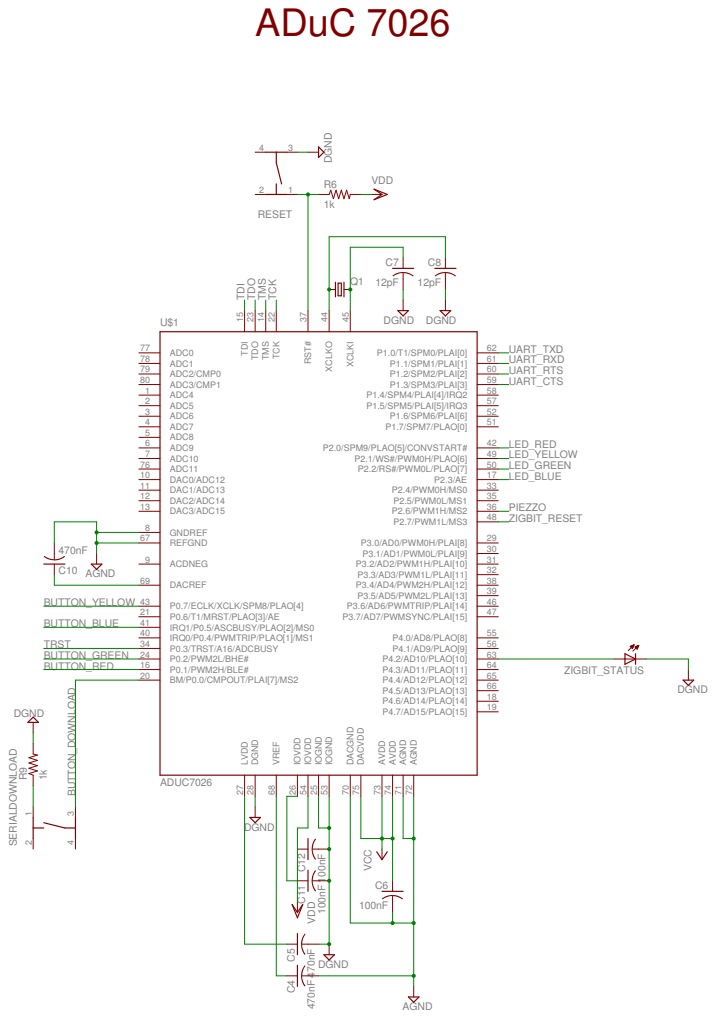
[picture p133: page 1]
