NeoLeMarc/Diplomarbeit/ausarbeitung/diagramme/schaltplan_manvnode_b.pdf

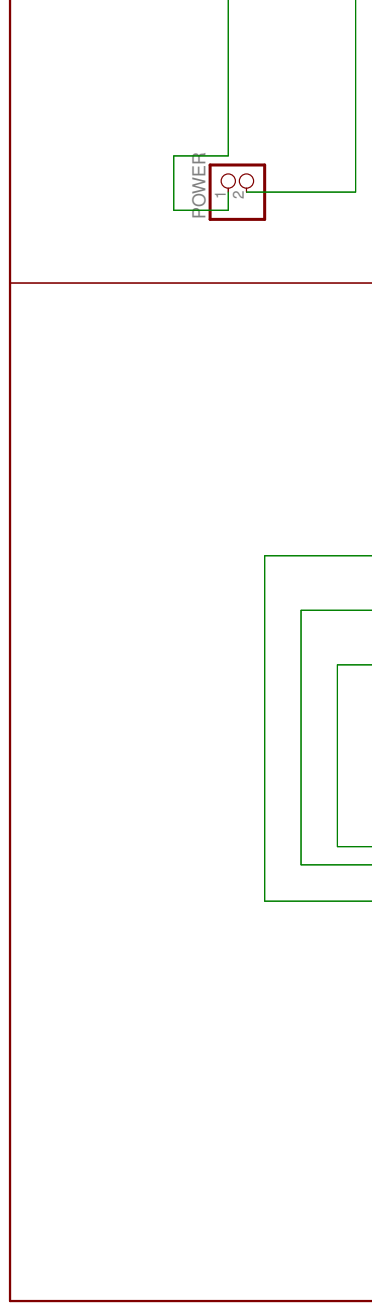
[picture p134: page 1]

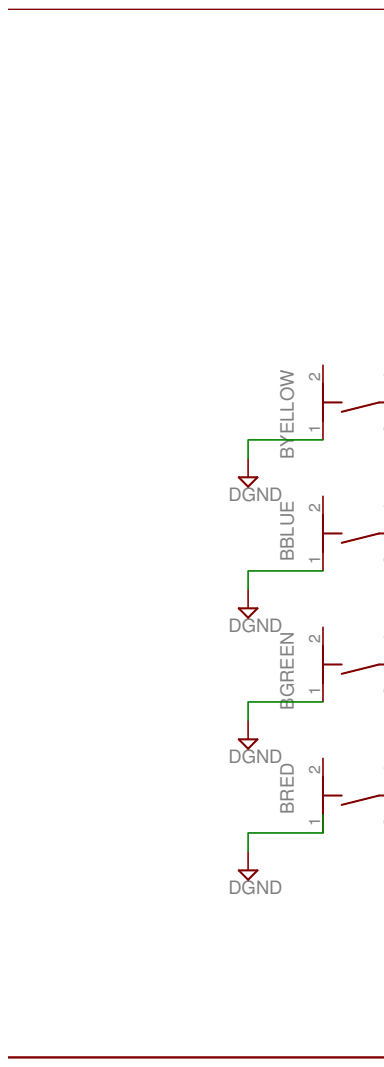
[picture p135: page 2]
