NeoLeMarc/Diplomarbeit/ausarbeitung/diagramme/schaltplan_manvnode_jtag-crop.pdf

# JTAG

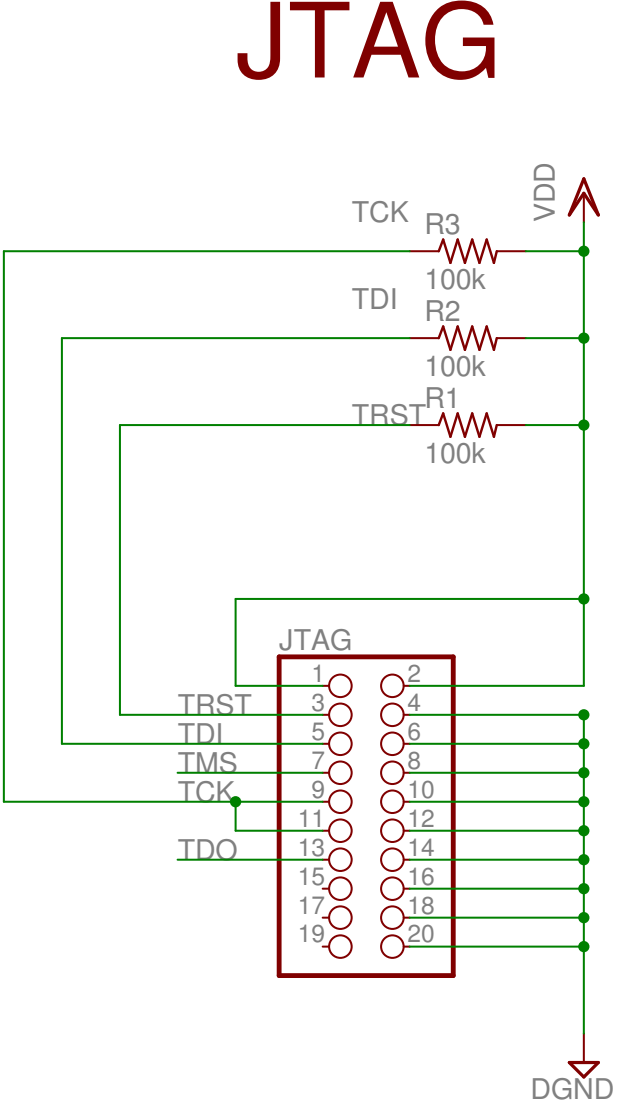
[picture p136: page 1]
VDD DGND; JTAG; TRST; TDI; TMS TCK; TCK; TDO
