NeoLeMarc/Diplomarbeit/ausarbeitung/diagramme/schaltplan_manvnode_jtag.pdf

# JTAG

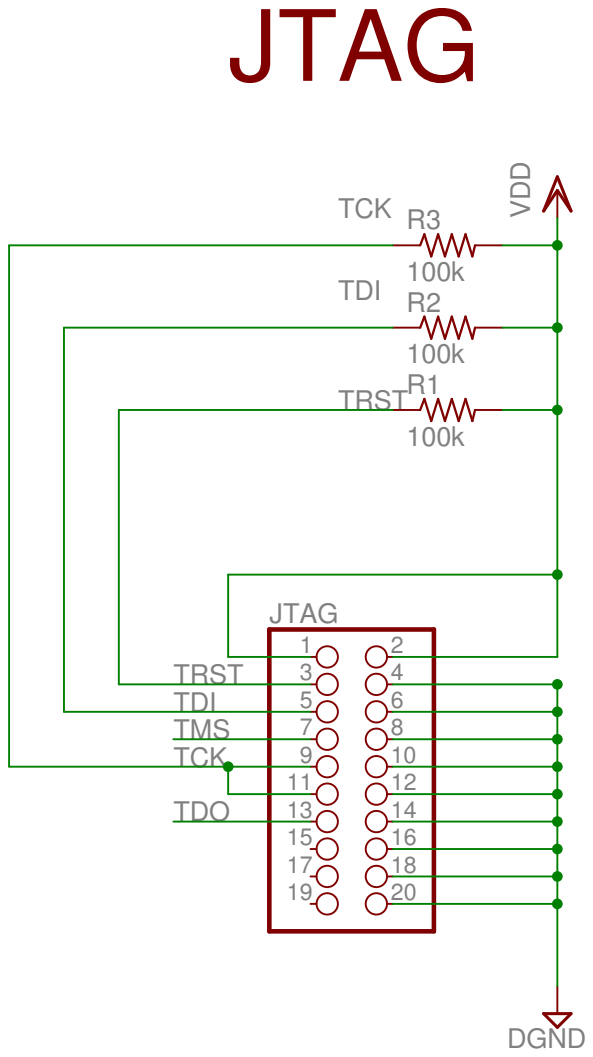
[picture p137: page 1]
VDD DGND; JTAG; TRST; TDI; TMS TCK; TCK; TDO
