NeoLeMarc/Diplomarbeit/ausarbeitung/diagramme/schaltplan_manvnode_mitte-crop.pdf

# ADuC 7026

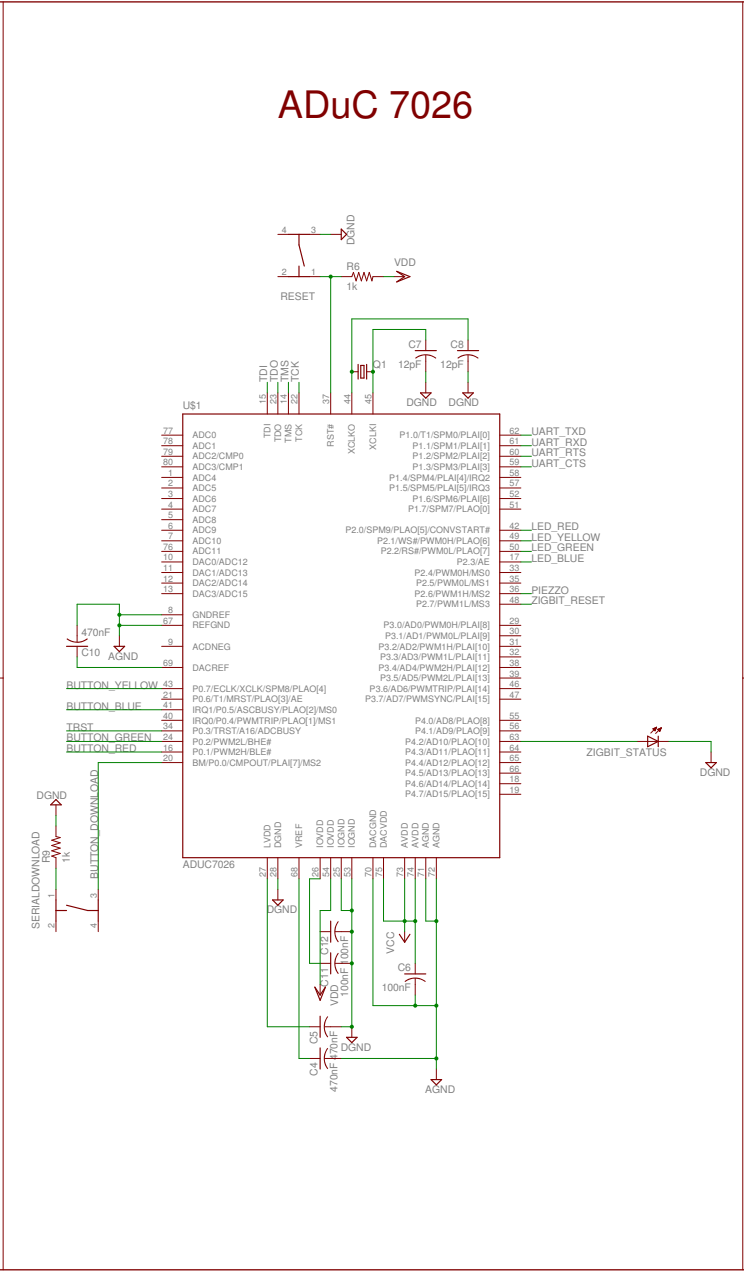
[picture p138: page 1]
