NeoLeMarc/Diplomarbeit/ausarbeitung/diagramme/schaltplan_manvnode_mitte.pdf

# ADuC 7026
