NeoLeMarc/Diplomarbeit/ausarbeitung/diagramme/schaltplan_manvnode_power.pdf

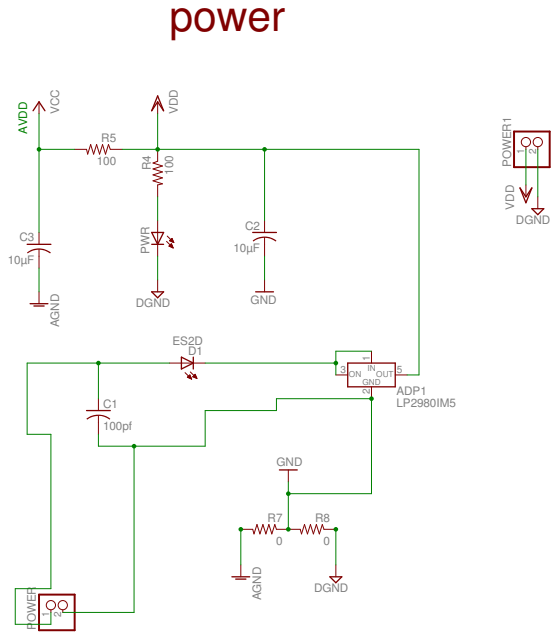
[picture p139: page 1]
