NeoLeMarc/Diplomarbeit/ausarbeitung/diagramme/platine_manvnode-crop.pdf

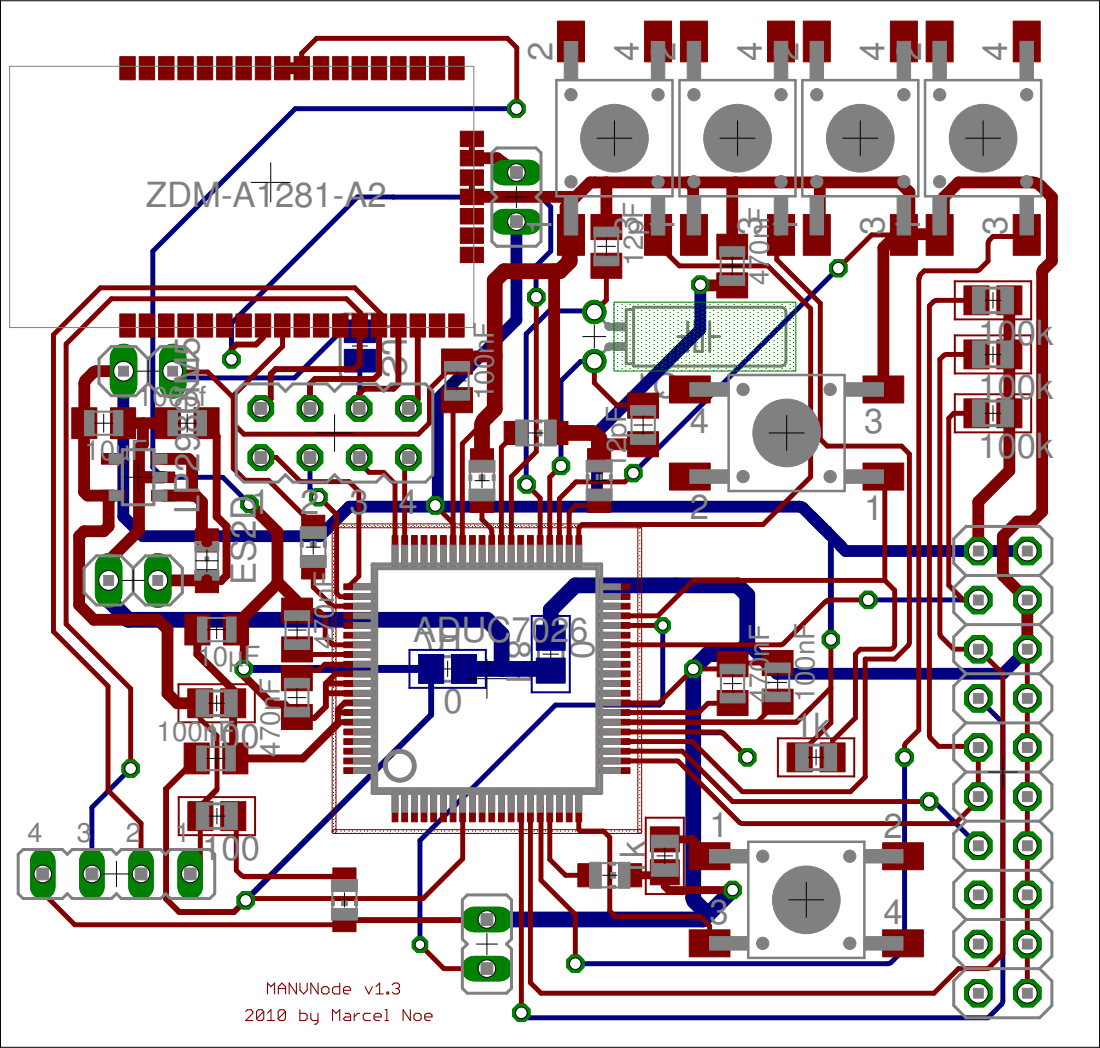
[picture p140: page 1]
ADUC7026; ZDM-A1281-A2
