NeoLeMarc/Diplomarbeit/ausarbeitung/diagramme/platine_manvnode.pdf

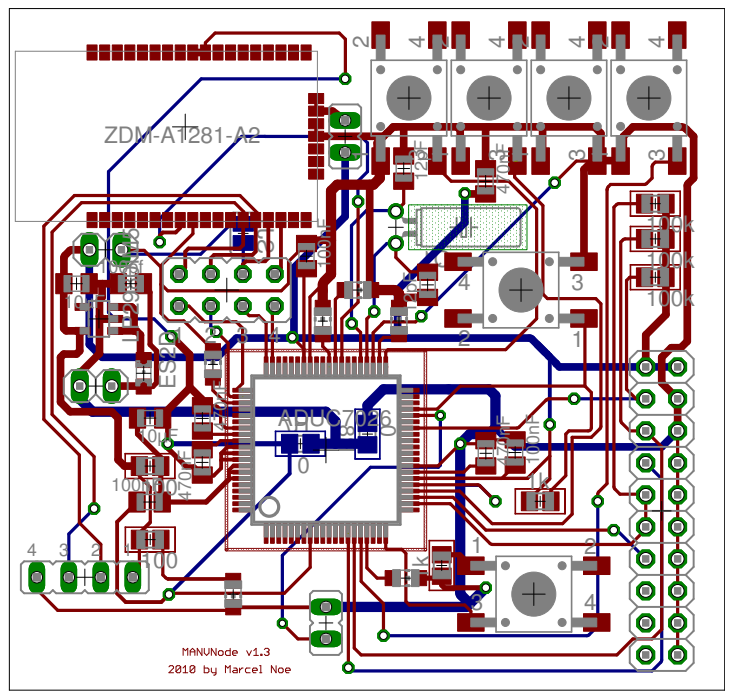
[picture p141: page 1]

ADUC7026
