NeoLeMarc/Diplomarbeit/ausarbeitung/diagramme/platine_usbstick-crop.pdf

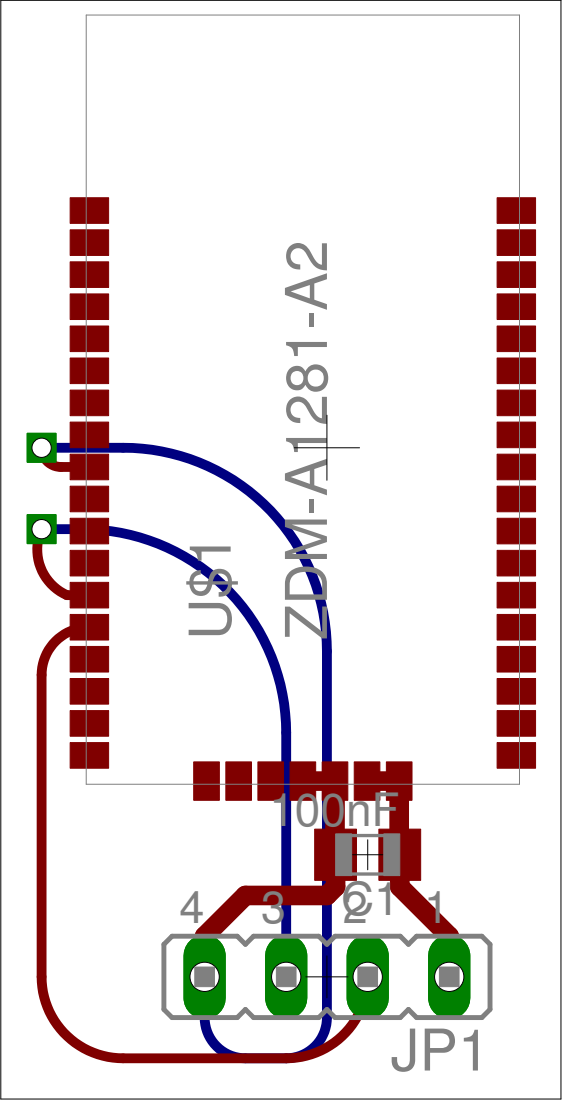
[picture p142: page 1]
