NeoLeMarc/Diplomarbeit/ausarbeitung/diagramme/platine_usbstick.pdf

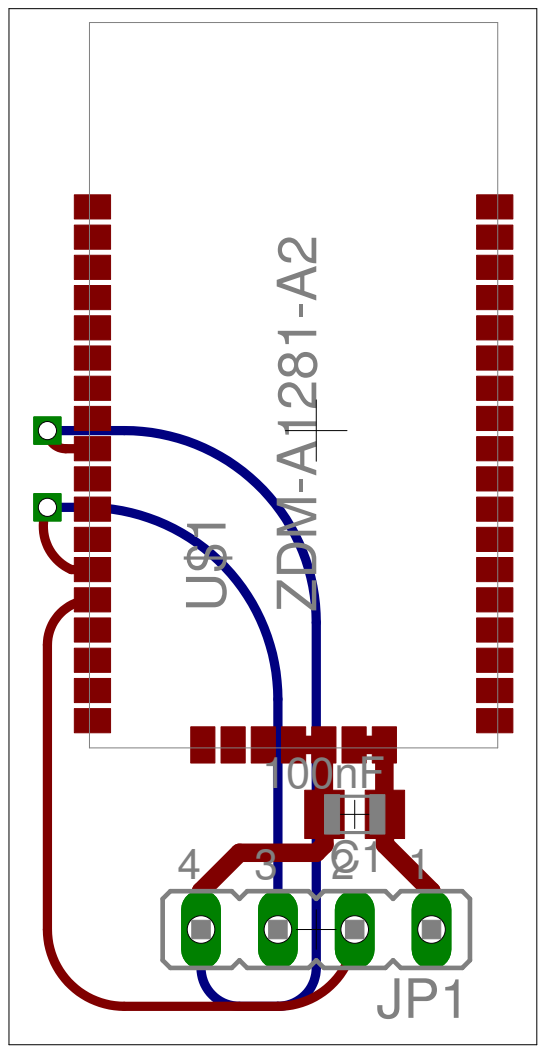
[picture p143: page 1]
