NeoLeMarc/Diplomarbeit/ausarbeitung/diagramme/platine_manvnode_bottom.pdf

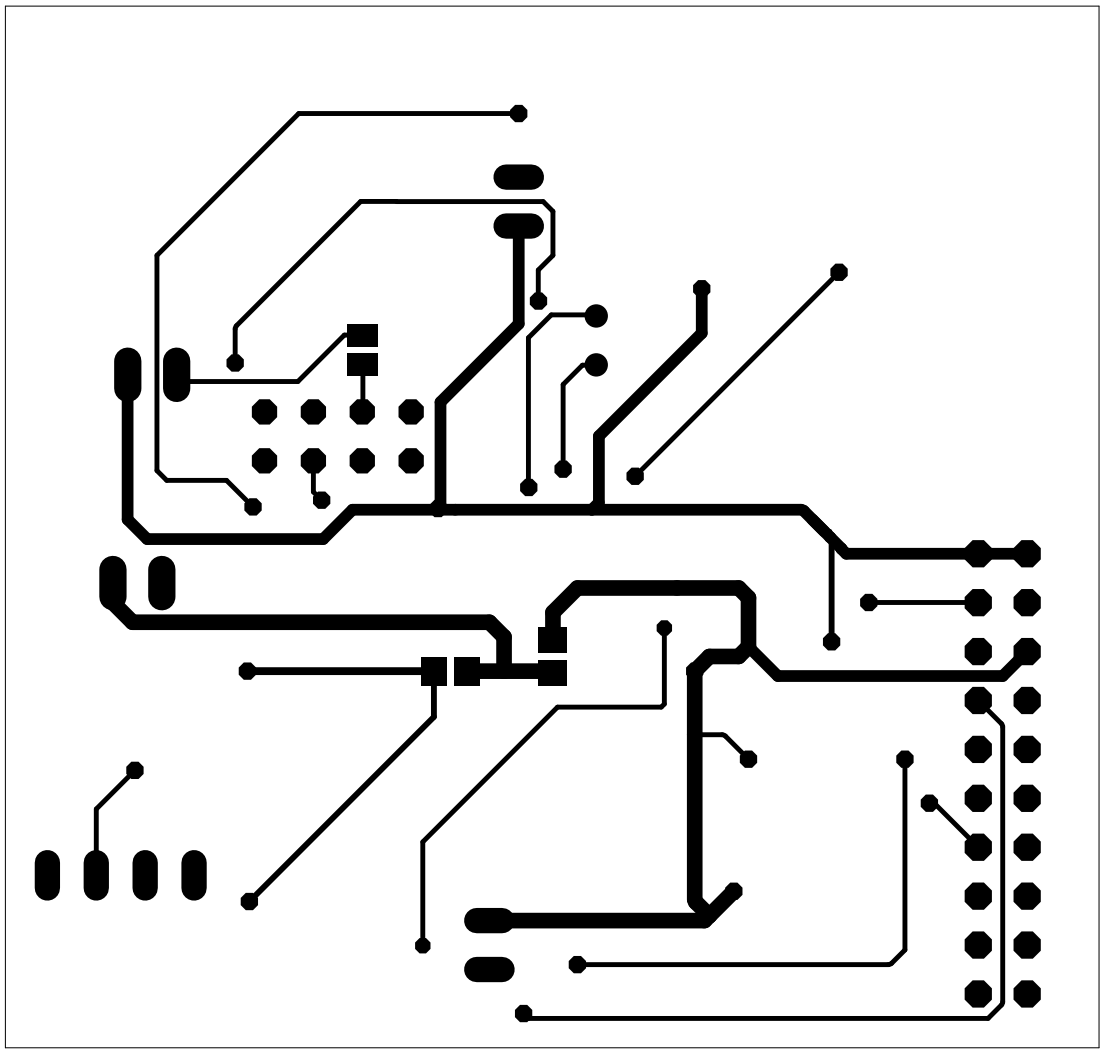
[picture p144: page 1]
