NeoLeMarc/Diplomarbeit/ausarbeitung/diagramme/platine_manvnode_top.pdf

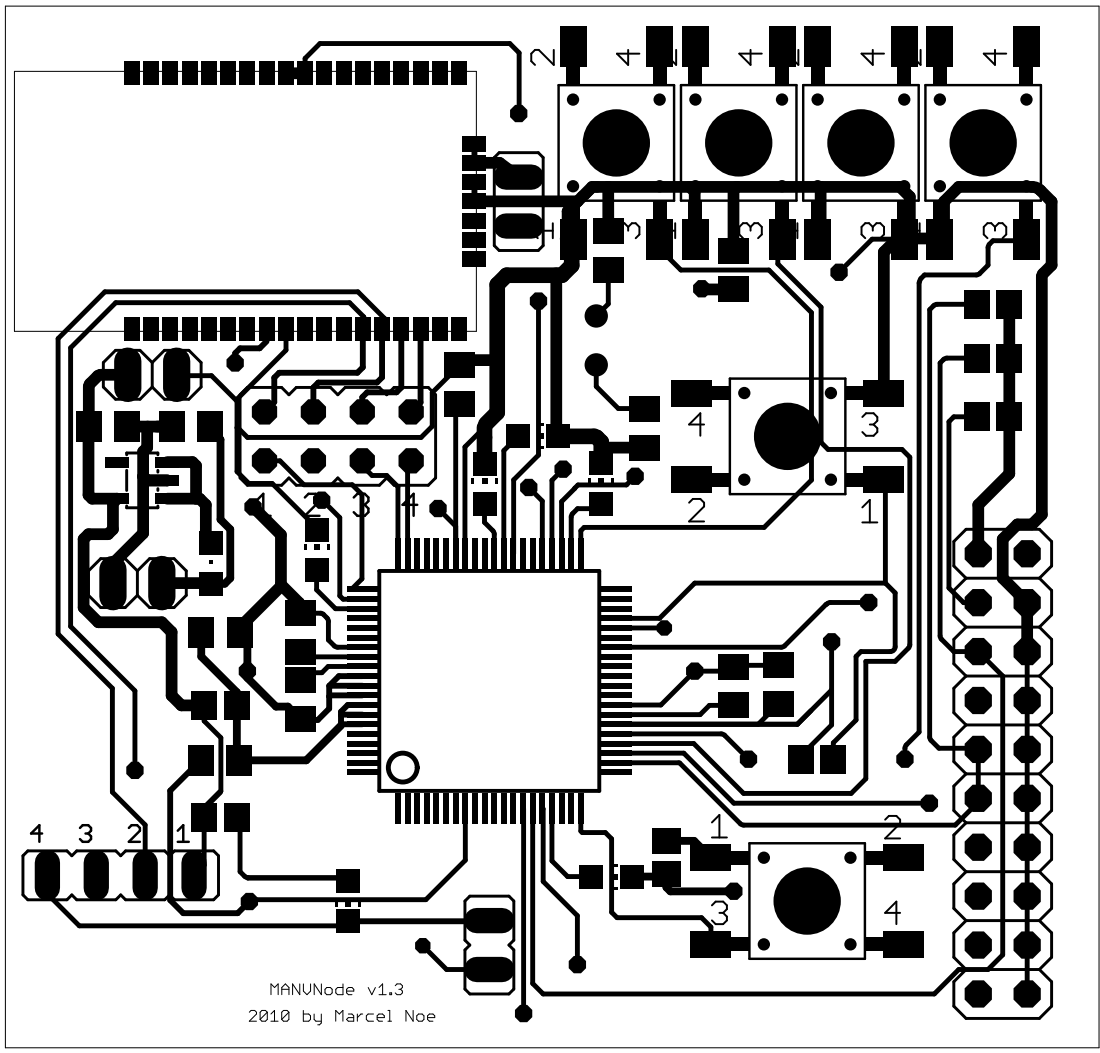
[picture p145: page 1]
