NeoLeMarc/Diplomarbeit/ausarbeitung/diagramme/schaltplan_manvnode.pdf

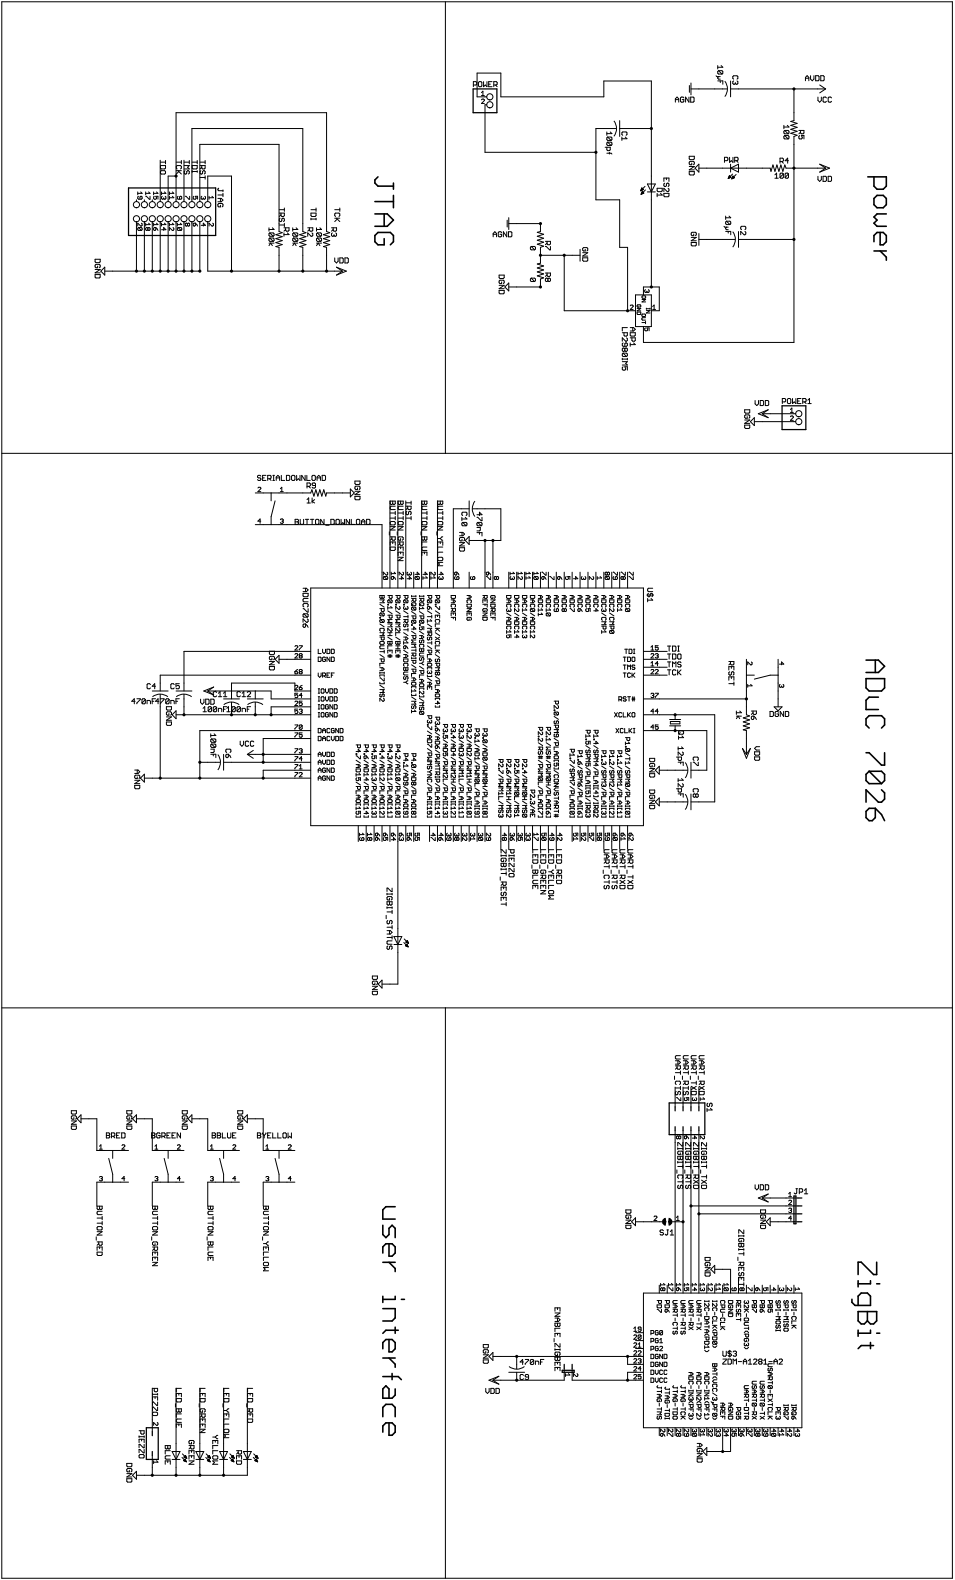
[picture p146: page 1]
