NeoLeMarc/Diplomarbeit/vortrag_tng2/images/schaltplan_usbstick.pdf

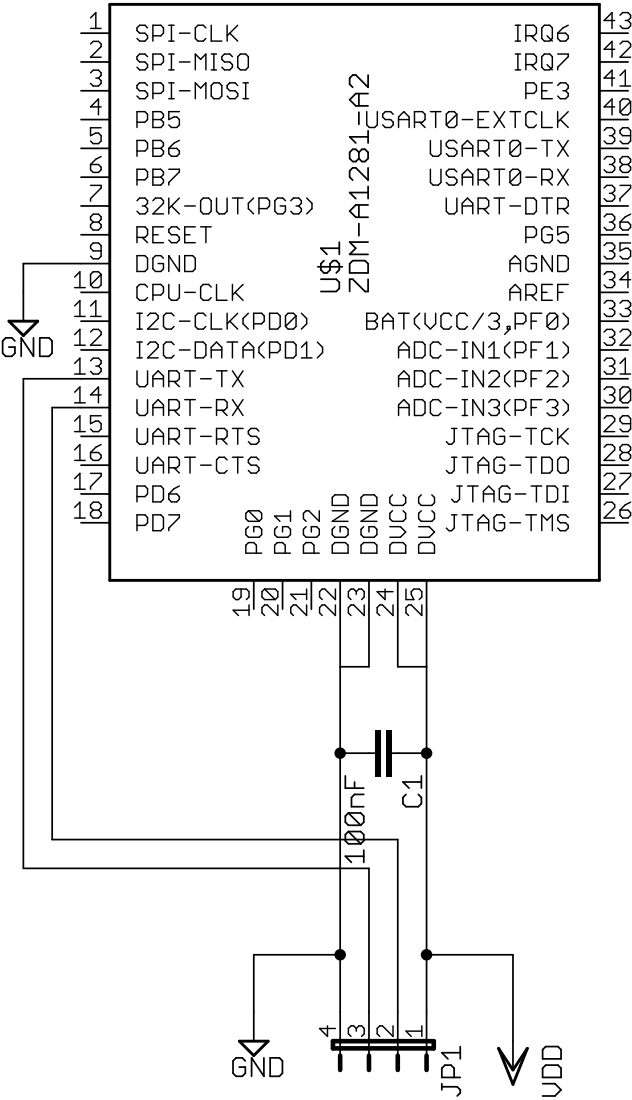
[picture p147: page 1]
