NeoLeMarc/Diplomarbeit/platine/adapter/bottom_new.pdf

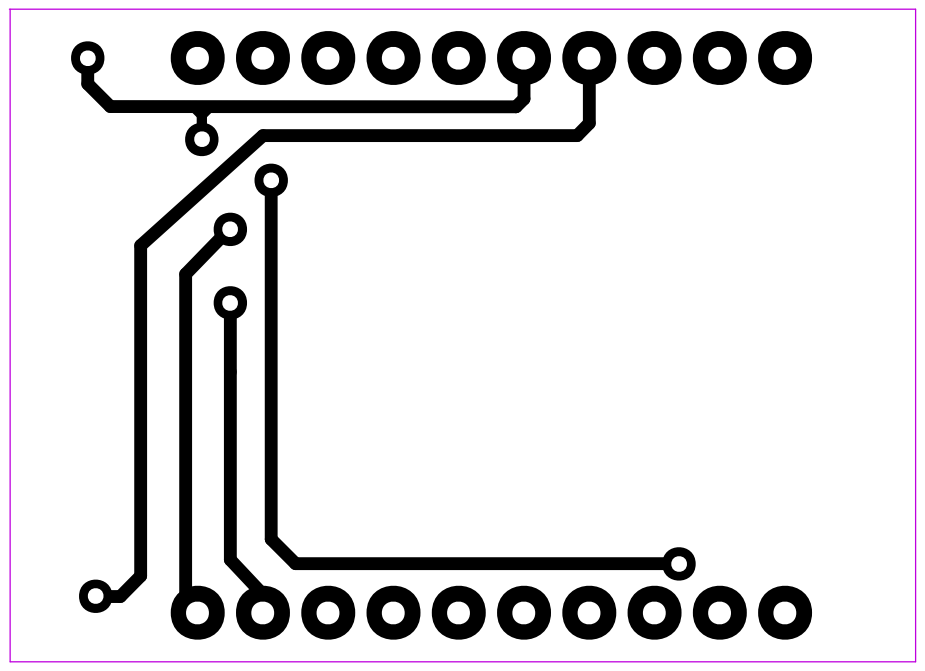
[picture p148: page 1]
