NeoLeMarc/Diplomarbeit/platine/adapter/bottom_new_mirrored.pdf

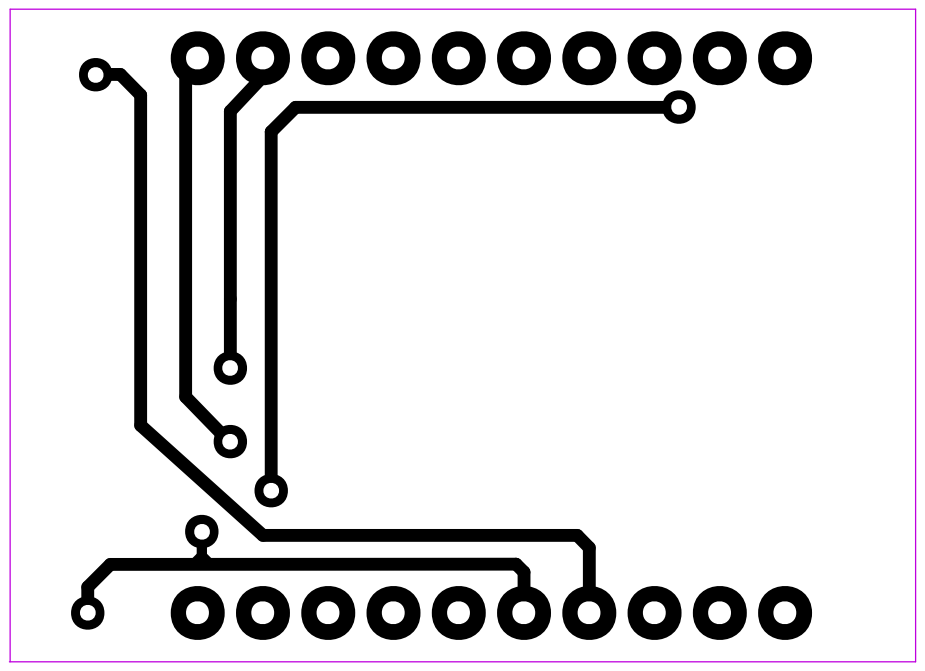
[picture p149: page 1]
