NeoLeMarc/Diplomarbeit/platine/adapter/top_new.pdf

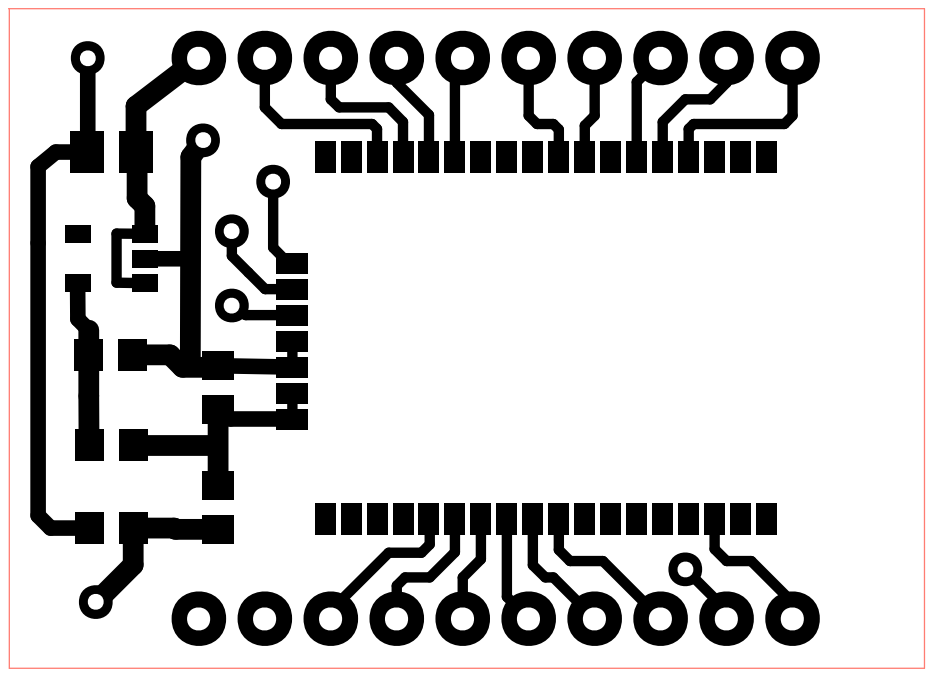
[picture p150: page 1]
