NeoLeMarc/Diplomarbeit/platine/adapter/top_new_mirrored.pdf

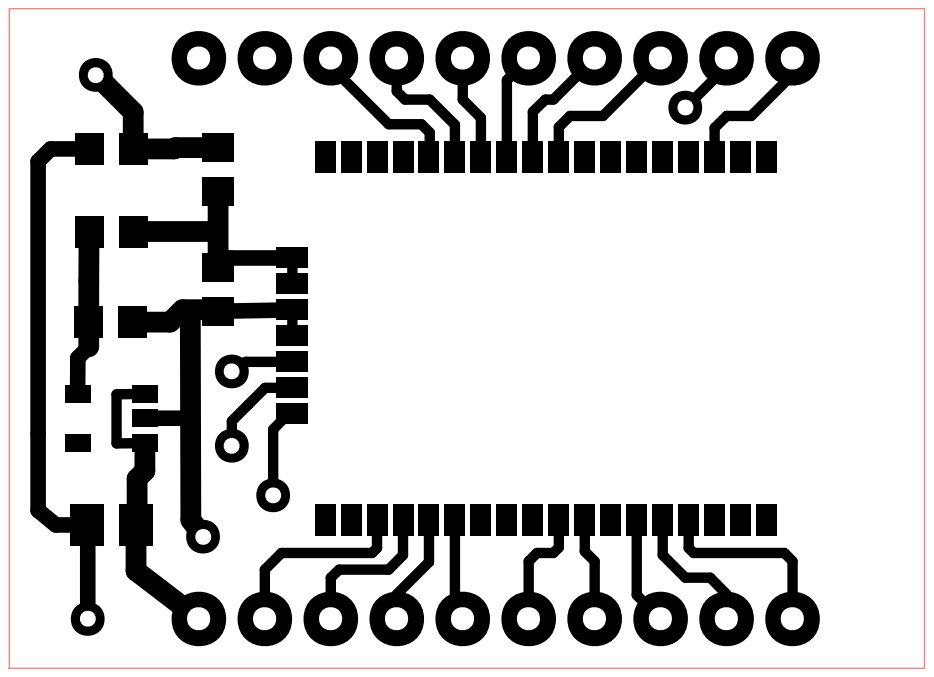
[picture p151: page 1]
