NeoLeMarc/Diplomarbeit/(list of files, drawings)

Other design files:
platine/adapter/ADAPT254.LAY
platine/adapter/ZigBit.pcblib
