NeoLeMarc/Diplomarbeit/serial_to_socket/poc/findzigbee.py

#!/usr/bin/env python
import usb, os, serial

class UserInterface:

    def printStatus(self, text):
        pass


class TextUI(UserInterface):

    def printStatus(self, text):
        print "Status: %s" % text


class ZigBitFinder:

    def __init__(self, ui):

        ## User-Interface
        self.ui = ui

    def searchUSB(self):
        ## Search for device on USB-Bus
        for bus in usb.busses():
            for dev in bus.devices:
                if dev.idVendor == 0x10c4 and dev.idProduct == 0xea60:
                    
                    ## Debug Information
                    self.ui.printStatus("Found on USB-Bus: Bus: %s Device: %s ID: %04x:%04x" % (bus.dirname, dev.filename, dev.idVendor, dev.idProduct))

                    return (bus.dirname, dev.filename)
        
        return False


    def searchSYS(self):
        ## Locate all usb-serial devices in /sys
        devices = []

        self.ui.printStatus("Searching in /sys")

        for device in os.listdir('/sys/bus/usb-serial/devices'):
            self.ui.printStatus("Found device: %s" % str(device))
            devices.append(device)

        return devices


    def testDevice(self, name):
        ret = []

        # Open with python serial and test device-identification
        self.ui.printStatus("Testing device %s" % name)
        ser = serial.Serial("/dev/%s" % name, 38400, timeout=1)
        ser.write("ATI\r\n")
        out = ser.read(74)
        
        ## Compare return value for matching vendor strings etc.
        if out:

            formatedOut = out.split("\r\n")

            if len(formatedOut) == 5:
                vendor  = formatedOut[1]
                name    = formatedOut[2]
                version = formatedOut[3]
                mac     = formatedOut[4]

                if vendor == 'ATMEL' and name == 'ZIGBIT':
                    self.ui.printStatus("Successfully tested device %s" % name)
                    return (vendor, name, version, mac)
                else:
                    self.ui.printStatus("Device %s does not match identification string" % name)
                    return False
        else:
            return False

    def findDevices(self):

        ## Search for an USB-Device and return a list of all ZigBit Devices

        # 1. Search on USB-Bus
        info    = self.searchUSB()
        devices = []

        if info:
            for device in self.searchSYS():

                # 2. Test device for identificatin string
                info = self.testDevice(device)

                if info:

                    # Append the device to device list if test
                    # was successful.
                    devices.append((device, info))

            return devices
        else:
            return False


if __name__ == "__main__":
    z = ZigBitFinder(TextUI())
    print z.findDevices()
