NeoLeMarc/Diplomarbeit/(commit log)

2010-01-05 Verbindung:
    Java -> Python -> Serial klappt, hat nur noch ein paar seltsame Bugs.
    [MARVConnector.java, serial_driver.py, serial_to_socket.py]
2010-01-08 - Serial-To-Socket.py funktioniert nun zuverlässig, und hängt sich nicht mehr auf. - Java Programm kann nun Befehle senden und Parsen.
    Next-Steps: Das Parsing muss auf eine Art Event-System umgestellt werden, und wir brauchen
    noch eine Sinnvolle Möglichkeit, Return-Codes zu interpretieren.
    Dannach müssen wir die Corba-Schnittstelle einbauen.
2010-01-10 Multithreaded Variante mit Reader und Writer Threads. Events und Queues sind noch nicht implementiert.
2010-02-23 Firmware jetzt schön mit interrupts und buttons usw.
2010-02-25 - Java connector kann nun DATA Events verarbeiten - Firmware sendet nun sofort nach einem Knopfdruck den aktuellen Status
2010-03-04 Firmware sendet nun Zufällige Puls- und Atmungswerte.
2010-03-05 Connector überarbeitet:
    CorbaMessages werden nun von den MARVEvent-Klassen generiert
    -> Bessere Faktorisierung
2010-03-12 Vorlage für die Ausarbeitung.
2010-03-28 Firmware auf Interrupt getriebener Basis. Noch ungetestet.
2010-03-29 Rewrite der Firmware: - UART komplett IRQ basiert.
    Muss noch aufgeräumt werden.
2010-03-29 Rewrite der Firmware, jetzt in aufgeräumt.
2010-03-29 Data-Befehle werden nun erkannt und auf den Commandbuffer gelegt.
2010-04-05 Weiter am konzept gearbeitet
2010-04-26 Jetzt mit piepsen, blinken und Buttons.
    Lediglich der gelbe Button fehlt noch.
2010-04-28 Weiter gearbeitet.
2010-04-30 weiter gearbeietet
2010-05-06 Etwas aufgeräumt... Anfang des Supports des Sendens von Befehlen.
2010-05-14 Anfang eines Entwurfs für die MANV Platine
    [ADAPT254.LAY, ZigBit.pcblib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]
2010-05-25 Weiter an der Platine gearbeitet.
    [manvnode.sch]
2010-05-27 Erstellung der Projektbeschreibung für den Arzt.
2010-05-30 Platine fertig.
    [manvnode.brd, manvnode.sch, manvnode2.brd, manvnode_old.brd]
2010-05-31 Jetzt mit Text
    [manvnode.brd]
2010-05-31 STromleitungen dicker gemacht.
    [manvnode.brd, manvnode.sch]
2010-05-31 Platine verschönert.
    [manvnode.brd]
2010-06-01 Powermanagement so einigermassen integriert.
2010-06-01 Powermanagement funktioniert... irgendwie.
2010-06-06 SerialNet hinzugefügt.
    [manvnode.brd, manvnode.sch, zigbit_config.txt]
2010-06-27 Zusammengeschrumpfte Version
    [manvnode.brd, manvnode.sch]
2010-06-27 Jetzt mit Beschriftung.
    [manvnode.brd]
2010-06-28 Platine noch einmal überarbeitet. Sternpunkt eingeführt, Verbindungen aufgehübscht.
    [manvnode.brd, manvnode.sch]
2010-06-28 Fertig zum Ätzen.
    [manvnode.brd]
2010-07-27 Erste Version des AAL-Abstracts
2010-07-28 Zweite Version des Abstrakts.
2010-08-07 Weiter an Paper gearbeitet.
    [manvnode.brd, manvnode.sch]
2010-08-25 Verbesserungen am Board
    [manvnode.brd, manvnode.sch]
2010-09-07 ZigBit Device wird nun automatisch erkannt.
2010-09-07 Serieller Treiber wird jetzt automatisch gestartet
2010-09-09 Beginn der Aufräumarbeiten.
2010-09-09 Quellcode aufgeräumt und in Packages aufgeteilt.
2010-09-12 Nodes werden nun aktiv über die Mac-Adresse identifiziert. Problem: Join Meldungen sind momentan deaktiviert.
2010-09-12 Join Messages funktionieren jetzt wieder.
    [manvnode.brd, manvnode.sch]
2010-09-21 Simulator für MANV-Nodes
    [zigbit_config.txt]
2010-09-30 Beschleunigt für Vorführung (Powermanagement und zuverlässiges ATD abgeschaltet)
    [manvnode.brd, manvnode.sch, zigbit_config.txt]
2010-09-30 MAC-Detection aus Geschwindigkeitsgründen deaktiviert Letzte Anpassungen and er Platine vor FD0
    [manvnode.brd, manvnode.sch]
2010-10-05 vias oktagonal geformt und bohrdurchmessser auf 0.5mm gesetzt
    [manvnode.brd, manvnode.sch]
2010-10-05 airwires entfernt
    [manvnode.brd]
2010-10-05 bestueckungsdruck angezeigt
    [manvnode.brd]
2010-10-05 Nächster Versuch mit der Platine
    [manvnode.brd]
2010-10-06 Graphiken etwas aufgehübscht.
    [manvnode.brd, manvnode.sch, zigbit_usbstick.brd, zigbit_usbstick.sch]
2010-10-07 Weiter an dem UML_Diagramm gearbeitet.
2010-10-07 Weiter am Diagramm gearbeitet.
2010-10-07 Weiter an dem DiaGramm gearbeitet...
2010-10-10 Weiter an der dusseligen Graphik gearbeitet.
2010-10-10 Weiter an der Graphik gearbeitet.
2010-10-11 Zustandsautomat des SerialNet-Protokolls
2010-10-12 Weiter an der Ausarbeitung gearbeitet.
2010-10-24 Webinterface nun mit hübschem Status update und so
2010-11-01 Weiter an der Ausarbeitung geschrieben.
2010-11-04 nächster Versuch die weise Schrift weg zu bekommen
2010-11-06 Grafik "Logische Sicht" verbessert (weniger Text) und etwas vergrößert
2010-11-07 Am Ergebniskapittel gearbeitet.
2010-11-07 Text auf Folien "Logische Sicht" und "Technische Sicht" geändert
2010-11-08 An dem Ergebniskapitel gearbeitet.
2010-11-08 Ecken und Kanten abgefeilt.
2010-11-15 Weiter am Anhang gearbeitet.
2010-11-17 Stand der Diagramme
2010-11-18 Diskussion und Ergebnisse fertig.
2010-11-18 Am Bibtexfile gearbeitet
2010-11-19 Zusammenfassung und Ausblick
2010-11-19 Fleißig an der ausarbeitung gearbeitet.
2010-11-22 Am Glossar gearbeitet.
2010-11-29 Titelseite und Dank fehlte.
2010-12-02 Rechtschreibfehler in Kapitel Stand der Technik behoben.
2010-12-05 Diagramm für den Versuchsaufbau des Integrationstests.
2010-12-05 Abgeschlossen: Überarbeitung der Abbildungen
2010-12-05 Klassendiagramm des MANVConnectors auf zwei Seiten verteilt.
2010-12-05 Schnitt des aufgeteilten UML-Diagramms verbessert.
2010-12-05 Threads ausgeschnitten
2010-12-06 Batterielaufzeit und Teilnehmerzahl
2012-01-06 Weiter am Vortrag gearbeitet.
2012-01-09 Weiter gearbeitet
2013-01-19 Vortrag über Sensornetze
